mm-hand/mmhand-core-software/desktop/resources/images/joint_motor_ids.png

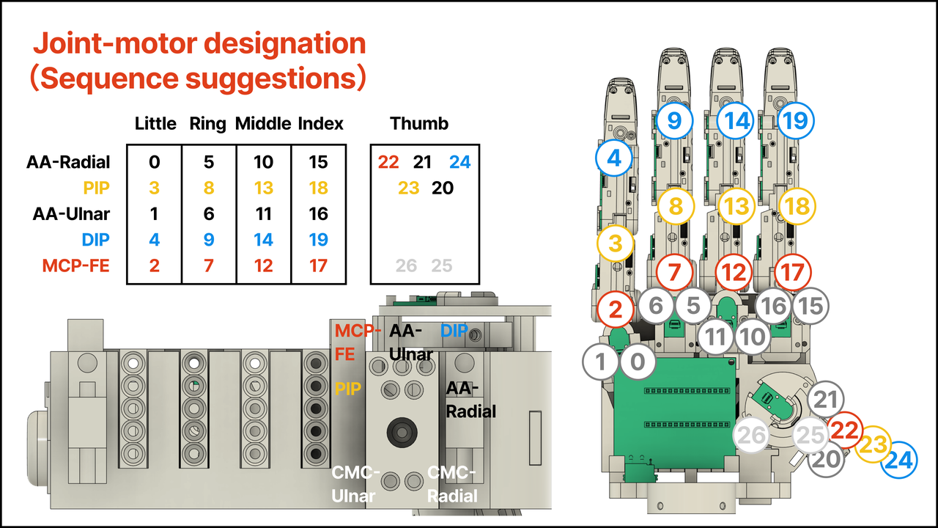
desktop/resources/images/joint_motor_ids.png
