mm-hand/mmhand-core-software/docs/desktop-safety-catalog.md

# Desktop safety catalog

Generated by `tools/generate_desktop_safety_catalog.py`; do not edit.

188 rejection messages, 124 fall back to `HOST_ACTION_FAILED` (the app cannot name the cause).

Static scan only: gates that fail silently, or forward `return False, message`,
are not listed. f-string messages are templates.

## desktop/core/application_actions.py

| Line | Message | Issue |
| --- | --- | --- |
| 158 | Wait for calibration to finish before changing control parameters | HOST_ACTION_FAILED ⚠ fallback |
| 165 | Parameters saved; P4 synchronization pending until idle | HOST_ACTION_FAILED ⚠ fallback |
| 177 | Parameters saved; P4 synchronization pending until idle | HOST_ACTION_FAILED ⚠ fallback |
| 182 | Wait for calibration to finish before changing control parameters | HOST_ACTION_FAILED ⚠ fallback |
| 189 | Default parameters restored; P4 synchronization pending until idle | HOST_ACTION_FAILED ⚠ fallback |
| 205 | Parameter synchronization cancelled by STOP | HOST_CANCELLED |
| 209 | Parameters changed during synchronization; apply the new revision first | HOST_ACTION_FAILED ⚠ fallback |
| 321 | Missing operation id | HOST_ACTION_FAILED ⚠ fallback |
| 327 | Calibration alert acknowledged | HOST_ACTION_FAILED ⚠ fallback |
| 328 | Operation has no calibration alert | HOST_ACTION_FAILED ⚠ fallback |
| 329 | Unknown operation | HOST_ACTION_FAILED ⚠ fallback |
| 369 | Replay service is not running | HOST_ACTION_FAILED ⚠ fallback |
| 446 | Application is shutting down | HOST_ACTION_FAILED ⚠ fallback |
| 448 | An operation is still finishing. Use STOP to cancel. | HOST_OPERATION_BUSY |
| 450 | P4 is disconnected or status data is stale. Check the connection. | HOST_CONNECTION_LOST |
| 488 | The operation worker is closed | HOST_ACTION_FAILED ⚠ fallback |
| 490 | {…} accepted | HOST_ACTION_FAILED ⚠ fallback |
| 514 | Select a device. The port is never changed automatically. | HOST_ACTION_FAILED ⚠ fallback |
| 521 | Connection cancelled | HOST_CANCELLED |
| 557 | Connection failed on {…}: {…} | HOST_ACTION_FAILED ⚠ fallback |
| 571 | Application is shutting down | HOST_ACTION_FAILED ⚠ fallback |
| 589 | Joint selection is out of range | HOST_ACTION_FAILED ⚠ fallback |
| 608 | Device is stopped (E-STOP latched); use the top-right Clear Faults button first | ACT-1005 |
| 615 | {…} cancelled | HOST_CANCELLED |
| 622 | Control handover was not queued | HOST_ACTION_FAILED ⚠ fallback |
| 626 | P4 did not acknowledge control handover | HOST_ACTION_FAILED ⚠ fallback |
| 635 | P4 did not release the old control owner | HOST_ACTION_FAILED ⚠ fallback |
| 675 | A maintenance or recovery operation owns the device | HOST_ACTION_FAILED ⚠ fallback |
| 686 | Select joints before enabling | HOST_SELECTION_EMPTY |
| 703 | Enable coordinate recovery failed: {…} | HOST_ACTION_FAILED ⚠ fallback |
| 705 | Scope setup failed. Check online devices, feedback and calibration. | HOST_ACTION_FAILED ⚠ fallback |
| 708 | Enable cancelled | HOST_CANCELLED |
| 729 | Enable preparation was not confirmed by P4 | HOST_ACTION_FAILED ⚠ fallback |
| 732 | Enable preparation changed before it could be used | HOST_ACTION_FAILED ⚠ fallback |
| 739 | P4 did not report READY after workspace recovery | HOST_ACTION_FAILED ⚠ fallback |
| 742 | Enable cancelled | HOST_CANCELLED |
| 745 | Enable blocked: P4 readiness or mapped feedback changed | HOST_ACTION_FAILED ⚠ fallback |
| 750 | Enable blocked: J{…} current angle is invalid | HOST_ACTION_FAILED ⚠ fallback |
| 769 | Enable cancelled | HOST_CANCELLED |
| 773 | Workspace recovery was not queued | HOST_ACTION_FAILED ⚠ fallback |
| 776 | Enable cancelled | HOST_CANCELLED |
| 778 | P4 workspace recovery ACK timed out | HOST_ACTION_FAILED ⚠ fallback |
| 780 | P4 rejected workspace recovery (ACK={…}) | HOST_ACTION_FAILED ⚠ fallback |
| 790 | Enable cancelled | HOST_CANCELLED |
| 791 | P4 workspace recovery result timed out | HOST_RESULT_UNKNOWN |
| 794 | Enable cancelled or workspace recovery result changed | HOST_CANCELLED |
| 797 | P4 workspace recovery failed (reason={…}) | HOST_ACTION_FAILED ⚠ fallback |
| 827 | Fault clear cancelled | HOST_CANCELLED |
| 832 | P4 did not acknowledge RESET. STOP remains pending; check the connection and Diagnostics. | HOST_ACTION_FAILED ⚠ fallback |
| 851 | RESET acknowledged, but a fresh stationary P4 status was not confirmed. Check Diagnostics. | HOST_ACTION_FAILED ⚠ fallback |
| 854 | Fault clear cancelled by a new STOP | HOST_CANCELLED |
| 865 | Targets must contain 21 finite angle values | HOST_ACTION_FAILED ⚠ fallback |
| 868 | Select a valid joint scope | HOST_ACTION_FAILED ⚠ fallback |
| 872 | Target cancelled | HOST_CANCELLED |
| 879 | Select valid joints | HOST_ACTION_FAILED ⚠ fallback |
| 889 | An operation is running. Wait for it to finish before authorizing ROS Input. | HOST_ACTION_FAILED ⚠ fallback |
| 896 | Invalid Manual capture arguments | HOST_ACTION_FAILED ⚠ fallback |
| 925 | P4 connection changed; capture the endpoint again. | HOST_ACTION_FAILED ⚠ fallback |
| 942 | J{…} raw feedback is invalid or stale. Check the encoder before capturing. | HOST_ACTION_FAILED ⚠ fallback |
| 946 | Press STOP and wait until P4 is stationary before capturing Manual endpoints. | HOST_MANUAL_INVALID |
| 949 | Capture cancelled | HOST_CANCELLED |
| 979 | J{…} not saved: {…} | HOST_ACTION_FAILED ⚠ fallback |
| 981 | Manual save cancelled | HOST_CANCELLED |
| 997 | Select joints | HOST_SELECTION_EMPTY |
| 1002 | Manual readback failed | HOST_ACTION_FAILED ⚠ fallback |
| 1008 | Clear cancelled | HOST_CANCELLED |
| 1024 | The current operation is still finishing | HOST_OPERATION_BUSY |
| 1029 | Select joints and connect P4 with fresh status | HOST_SELECTION_EMPTY |
| 1031 | Control parameters are not applied. Wait for parameter synchronization before calibrating. | HOST_PARAMETERS_PENDING |
| 1034 | J{…} is missing Manual Min / Max | HOST_MANUAL_MISSING |
| 1038 | J{…}: {…} | HOST_ACTION_FAILED ⚠ fallback |
| 1076 | Selected-joint calibration accepted | HOST_ACTION_FAILED ⚠ fallback |
| 1178 | Motor selection is out of range | HOST_ACTION_FAILED ⚠ fallback |
| 1183 | Motor scope updated | HOST_ACTION_FAILED ⚠ fallback |
| 1196 | Select motors before enabling | HOST_SELECTION_EMPTY |
| 1205 | Motor scope setup failed | HOST_MOTORS_NOT_READY |
| 1208 | Select motors; enable was not submitted | HOST_SELECTION_EMPTY |
| 1250 | Motors are online but their configuration check has not finished. Check the motor bus and retry. | HOST_MOTORS_NOT_READY |
| 1254 | ABS zero requires the original connected P4 device | HOST_MOTORS_NOT_READY |
| 1272 | ABS zero cancelled before stopping | HOST_CANCELLED |
| 1283 | P4 stop/owner release was not confirmed; ABS zero was not sent | HOST_ACTION_FAILED ⚠ fallback |
| 1285 | P4 device identity changed; ABS zero was not sent | HOST_ACTION_FAILED ⚠ fallback |
| 1328 | ABS zero may have completed; new trusted feedback/JSON save is unconfirmed. No automatic retry. | HOST_RESULT_UNKNOWN |
| 1330 | ABS zero partly completed (saved mask=0x{…}); {…} | HOST_RESULT_PARTIAL |
| 1347 | Waiting for motor firmware and configuration checks | HOST_MOTORS_NOT_READY |
| 1350 | No online, routable motors to initialize. Check the motor buses. | HOST_MOTORS_NOT_READY |
| 1359 | Select motors | HOST_SELECTION_EMPTY |
| 1369 | Select joints before releasing their tendons | HOST_SELECTION_EMPTY |
| 1396 | Calibration file exceeds 10 MB | HOST_ACTION_FAILED ⚠ fallback |
| 1408 | Calibration preview cancelled | HOST_CANCELLED |
| 1419 | Import requires a validated file and fresh, idle P4 connection | HOST_ACTION_FAILED ⚠ fallback |
| 1421 | Control parameters are not applied. Wait for parameter synchronization before loading calibration. | HOST_PARAMETERS_PENDING |
| 1454 | Calibration import started | HOST_ACTION_FAILED ⚠ fallback |
| 1461 | Motor scope setup failed | HOST_MOTORS_NOT_READY |
| 1464 | Direct control cancelled | HOST_CANCELLED |
| 1470 | Direct control cancelled | HOST_CANCELLED |
| 1475 | Current ABS is stale or untrusted | HOST_ACTION_FAILED ⚠ fallback |
| 1487 | Motor target send failed | HOST_ACTION_FAILED ⚠ fallback |
| 1495 | P4 rejected motor target (reason={…}, mask=0x{…}) | HOST_ACTION_FAILED ⚠ fallback |
| 1497 | Motor execution confirmation timed out | HOST_ACTION_FAILED ⚠ fallback |
| 1505 | Select joints explicitly before playing a motion | HOST_SELECTION_EMPTY |
| 1509 | Playback cancelled | HOST_CANCELLED |
| 1511 | Replay is not running | HOST_ACTION_FAILED ⚠ fallback |
| 1518 | Playback startup cancelled | HOST_CANCELLED |
| 1532 | Turn Save Data OFF before changing recording options | HOST_ACTION_FAILED ⚠ fallback |
| 1534 | Recording options updated | HOST_ACTION_FAILED ⚠ fallback |

## desktop/core/core_logic.py

| Line | Message | Issue |
| --- | --- | --- |
| 153 | Cannot reset motor positions while Stop is active. Check the hand, click Clear Faults, then retry the original action. | HOST_ACTION_FAILED ⚠ fallback |
| 338 | Not connected or empty motor scope | HOST_ACTION_FAILED ⚠ fallback |
| 349 | Direct enable cancelled | HOST_CANCELLED |
| 352 | Current ABS is stale or untrusted | HOST_ACTION_FAILED ⚠ fallback |
| 359 | Current-position hold was not queued | HOST_ACTION_FAILED ⚠ fallback |
| 365 | P4 rejected current-position hold (reason={…}) | HOST_ACTION_FAILED ⚠ fallback |
| 371 | Direct enable execution was not confirmed | HOST_ACTION_FAILED ⚠ fallback |
| 979 | serial not connected | HOST_CONNECTION_LOST |
| 985 | no multi-turn anchors to reconcile | HOST_ACTION_FAILED ⚠ fallback |
| 1011 | multi-turn frame shift refused: {…} | HOST_ACTION_FAILED ⚠ fallback |
| 1020 | multi-turn reconciliation reload failed: {…} | HOST_ACTION_FAILED ⚠ fallback |
| 1025 | device connection changed during coordinate reconciliation | HOST_ACTION_FAILED ⚠ fallback |
| 1027 | P4 did not accept the multi-turn trust request | HOST_ACTION_FAILED ⚠ fallback |
| 1058 | multi-turn recovery cancelled | HOST_CANCELLED |
| 1127 | no persistent multi-turn anchor: {…} | HOST_ACTION_FAILED ⚠ fallback |
| 2205 | waiting for post-reset native ABS | HOST_ACTION_FAILED ⚠ fallback |
| 2223 | post-reset native ABS unavailable (fresh={…} routable={…} unknown=0x{…} online=0x{…}) | HOST_ACTION_FAILED ⚠ fallback |
| 2370 | serial not connected | HOST_CONNECTION_LOST |
| 2382 | snapshot Manual endpoints are invalid | HOST_MANUAL_INVALID |
| 2388 | snapshot contains no valid Manual endpoints | HOST_MANUAL_INVALID |
| 2393 | failed to read current Manual RAM before restore | HOST_ACTION_FAILED ⚠ fallback |
| 2430 | J{…} Manual RAM restore rejected | HOST_ACTION_FAILED ⚠ fallback |
| 2432 | J{…} Manual commit timed out | HOST_ACTION_FAILED ⚠ fallback |
| 2438 | failed to read Manual RAM after restore | HOST_ACTION_FAILED ⚠ fallback |
| 2451 | P4 Manual RAM readback mask is incomplete | HOST_ACTION_FAILED ⚠ fallback |
| 2461 | J{…} Manual RAM readback mismatch | HOST_ACTION_FAILED ⚠ fallback |
| 2480 | serial not connected | HOST_CONNECTION_LOST |
| 2484 | current URDF mapping is invalid: {…} | HOST_ACTION_FAILED ⚠ fallback |
| 2497 | invalid motor ABS limits: {…} | HOST_ACTION_FAILED ⚠ fallback |
| 2499 | unsupported snapshot schema v{…} | HOST_ACTION_FAILED ⚠ fallback |
| 2501 | invalid motor ABS limit count: {…}/{…} | HOST_ACTION_FAILED ⚠ fallback |
| 2505 | invalid joint calibration count: {…} | HOST_ACTION_FAILED ⚠ fallback |
| 2532 | P4 Manual RAM image was not committed | HOST_ACTION_FAILED ⚠ fallback |
| 2540 | P4 Manual references missing active joints: {…} | HOST_ACTION_FAILED ⚠ fallback |
| 2545 | P4 Manual endpoint readback is incomplete | HOST_ACTION_FAILED ⚠ fallback |
| 2560 | snapshot Manual CRC mismatch: {…}; re-run automatic calibration for these joints | HOST_ACTION_FAILED ⚠ fallback |
| 2579 | motor ABS limit load ACK timeout/reject | HOST_ACTION_FAILED ⚠ fallback |
| 2592 | J{…} load ACK timeout/reject | HOST_ACTION_FAILED ⚠ fallback |
| 2595 | no valid joint calibration result in snapshot | HOST_ACTION_FAILED ⚠ fallback |

## desktop/core/hand_backend.py

| Line | Message | Issue |
| --- | --- | --- |
| 619 | ROS2 enable blocked: host calibration is active | HOST_ACTION_FAILED ⚠ fallback |
| 621 | ROS2 enable blocked: device transaction is active | HOST_ACTION_FAILED ⚠ fallback |
| 624 | ROS2 enable blocked: P4 serial is not connected | HOST_ACTION_FAILED ⚠ fallback |
| 628 | ROS2 enable blocked: protocol/model handshake unconfirmed | HOST_RESULT_UNKNOWN |
| 631 | ROS2 enable blocked: active joint scope is empty | HOST_SELECTION_EMPTY |
| 668 | ROS2 enable blocked: host calibration is active | HOST_ACTION_FAILED ⚠ fallback |
| 670 | ordinary controller is not enabled; press ENABLE first | HOST_ACTION_FAILED ⚠ fallback |

## desktop/core/host_calibration/finish.py

| Line | Message | Issue |
| --- | --- | --- |
| 88 | J{…} zero finish requires a valid dual LUT containing 0 degrees | HOST_ACTION_FAILED ⚠ fallback |
| 92 | J{…} zero finish cancelled or control lost | HOST_CANCELLED |
| 96 | J{…} zero finish target publish failed | HOST_ACTION_FAILED ⚠ fallback |
| 102 | zero finish cancelled or control lost before release | HOST_CANCELLED |
| 104 | zero finish direct owner release failed | HOST_ACTION_FAILED ⚠ fallback |

## desktop/core/host_calibration/runtime.py

| Line | Message | Issue |
| --- | --- | --- |
| 147 | session cancelled, replaced or disconnected | HOST_CANCELLED |
| 152 | system status stale or missing (age={…}s) | HOST_ACTION_FAILED ⚠ fallback |
| 161 | faults=0x{…}, route conflicts=0x{…} | HOST_ACTION_FAILED ⚠ fallback |
| 169 | state={…}, owner={…}, token={…}/{…}, result={…} | HOST_ACTION_FAILED ⚠ fallback |
| 174 | not stopped: state={…}, owner={…} | HOST_ACTION_FAILED ⚠ fallback |
| 1150 | device or model identity changed before calibration commit | HOST_ACTION_FAILED ⚠ fallback |
| 1152 | invalid host joint calibration result | HOST_ACTION_FAILED ⚠ fallback |
| 1155 | mechanical result retained in host diagnostics; LUT build invalid, not uploaded | HOST_ACTION_FAILED ⚠ fallback |
| 1160 | could not release motion before Manual/LUT commit | HOST_ACTION_FAILED ⚠ fallback |
| 1164 | Manual writeback failed | HOST_ACTION_FAILED ⚠ fallback |
| 1167 | joint LUT writeback failed | HOST_ACTION_FAILED ⚠ fallback |
| 1174 | calibration motor limits incomplete | HOST_ACTION_FAILED ⚠ fallback |
| 1180 | joint ABS limits writeback failed | HOST_ACTION_FAILED ⚠ fallback |
| 1183 | calibration cancelled after device writeback | HOST_CANCELLED |
| 1217 | new joint result saved; waiting for trusted native ABS anchors | HOST_ACTION_FAILED ⚠ fallback |
| 1226 | new joint result saved; runtime anchor persistence failed | HOST_ACTION_FAILED ⚠ fallback |
| 1263 | calibration stopped; completed joints retained | HOST_ACTION_FAILED ⚠ fallback |
| 1265 | calibration complete; motion owner release failed | HOST_ACTION_FAILED ⚠ fallback |
| 1268 | calibration complete; active scope restore failed | HOST_ACTION_FAILED ⚠ fallback |
| 1270 | calibration complete; P4 preparation failed | HOST_ACTION_FAILED ⚠ fallback |
| 1273 | calibration complete; Pull Joint into Workspace start failed | HOST_ACTION_FAILED ⚠ fallback |
| 1276 | calibration complete; Pull Joint into Workspace result timeout | HOST_RESULT_UNKNOWN |
| 1279 | Pull Joint into Workspace failed | HOST_ACTION_FAILED ⚠ fallback |

## desktop/core/id_actions.py

| Line | Message | Issue |
| --- | --- | --- |
| 72 | Choose Scan (0–30) or Scan (0–253) | HOST_ACTION_FAILED ⚠ fallback |
| 110 | Scan cancelled | HOST_CANCELLED |
| 121 | Connect P4 and scan all buses before renumbering | HOST_MOTORS_NOT_READY |
| 128 | No motors were found | HOST_ACTION_FAILED ⚠ fallback |
| 137 | The scan is no longer current. {…} | HOST_ACTION_FAILED ⚠ fallback |
| 139 | P4 identity is unavailable; wait for device fingerprint | HOST_ACTION_FAILED ⚠ fallback |
| 221 | Connect P4 and scan all buses before buzzing a motor | HOST_MOTORS_NOT_READY |
| 224 | Scan all buses and select a motor to buzz | HOST_MOTORS_NOT_READY |

## Duplicate messages

- ×2 `Wait for calibration to finish before changing control parameters`
- ×2 `Parameters saved; P4 synchronization pending until idle`
- ×2 `Application is shutting down`
- ×5 `Enable cancelled`
- ×2 `Motor scope setup failed`
- ×2 `Direct control cancelled`
- ×2 `Current ABS is stale or untrusted`
- ×3 `serial not connected`
- ×2 `ROS2 enable blocked: host calibration is active`
