mm-hand/mmhand-core-software/desktop/resources/mmhand_urdf/meshes/link_finger_tip_2.stl

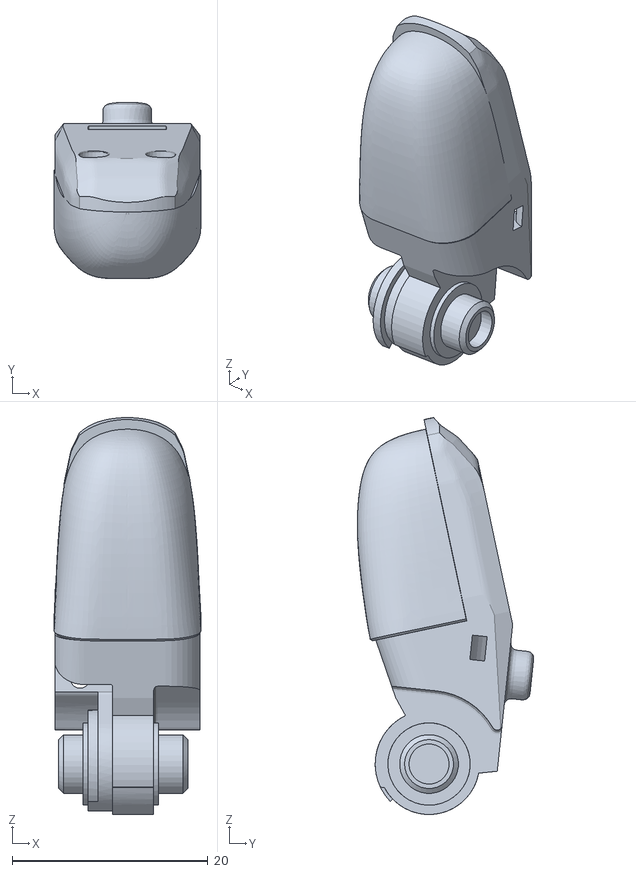
[picture p2: CAD file, 2026-10-31]
desktop/resources/mmhand_urdf/meshes/link_finger_tip_2.stl
15.0 x 18.0 x 40.5
