mm-hand/mmhand-core-software/desktop/resources/mmhand_urdf/meshes/link_proximal_phalanx_4.stl

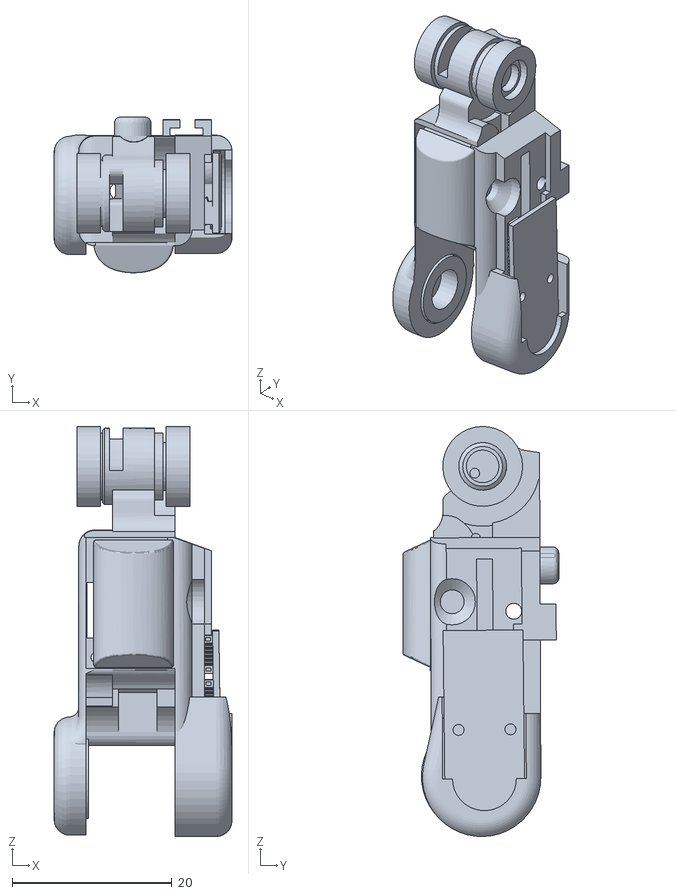
[picture p4: CAD file, 2026-10-31]
desktop/resources/mmhand_urdf/meshes/link_proximal_phalanx_4.stl
22.3 x 19.5 x 51.4
