mm-hand/mmhand-core-software/desktop/resources/mmhand_urdf/meshes/link_aa_with_fin_1.stl

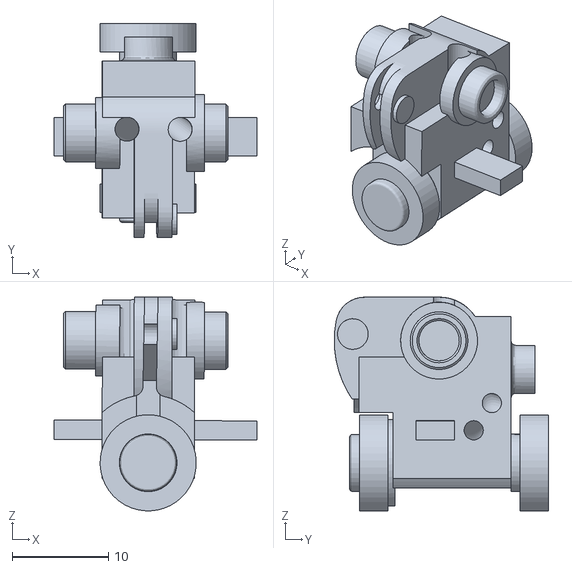
[picture p6: CAD file, 2026-10-31]
desktop/resources/mmhand_urdf/meshes/link_aa_with_fin_1.stl
21.1 x 22.3 x 22.2
