mm-hand/mmhand-core-software/desktop_macOS/hku_hand_v2_urdf/meshes/2-3_Link.STL.convex.stl

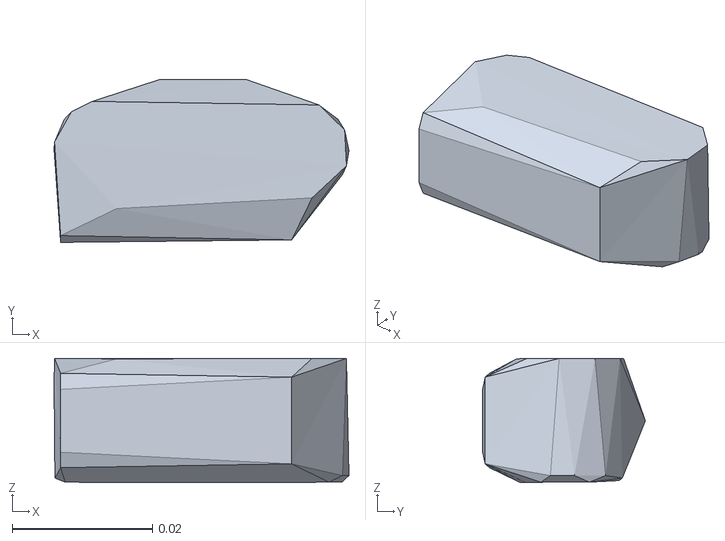
[picture p8: CAD file, 2026-04-04]
desktop_macOS/hku_hand_v2_urdf/meshes/2-3_Link.STL.convex.stl
0.042 x 0.0232 x 0.0177
