mm-hand/mmhand-core-software/desktop/resources/mmhand_urdf/meshes/link_left_thumb_base_1.stl

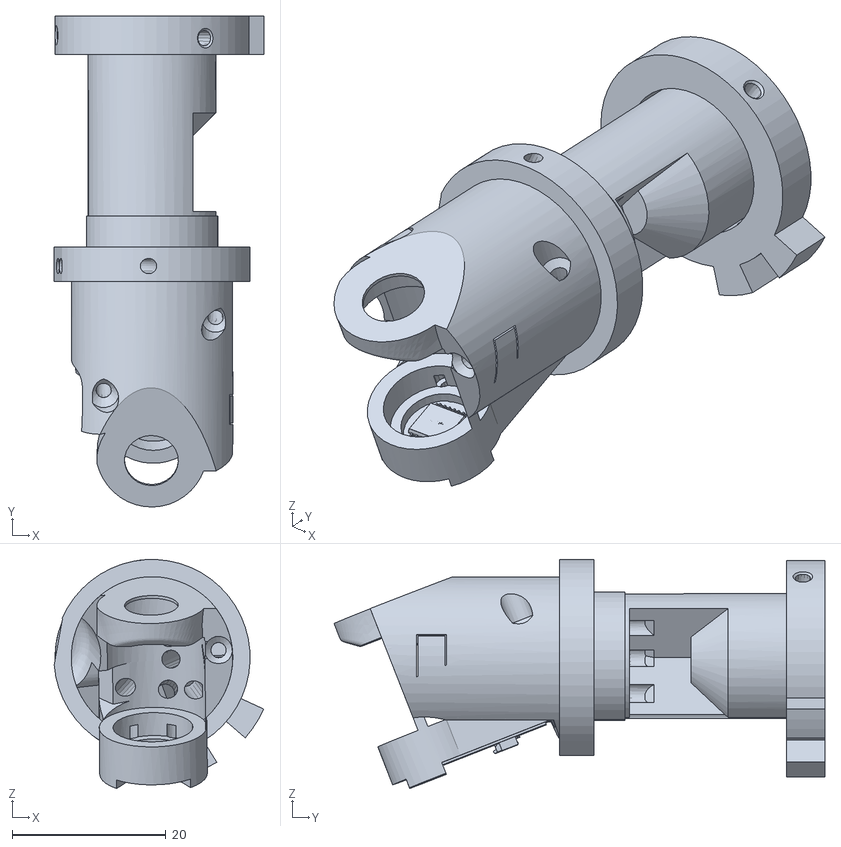
[picture p9: CAD file, 2026-10-31]
desktop/resources/mmhand_urdf/meshes/link_left_thumb_base_1.stl
27.2 x 63.8 x 29.8
