mm-hand/mmhand-core-software/desktop_macOS/hku_hand_v2_urdf/meshes/3-4_Link.STL

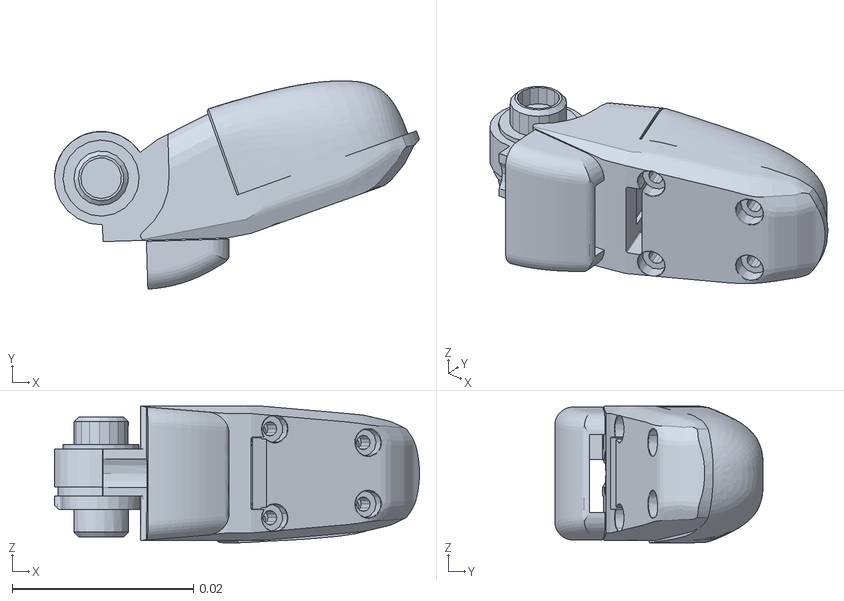
[picture p10: CAD file, 2026-04-04]
desktop_macOS/hku_hand_v2_urdf/meshes/3-4_Link.STL
0.0402 x 0.023 x 0.0151
