mm-hand/mmhand-core-software/desktop/resources/mmhand_urdf/meshes/link_aa_without_fin_1.stl

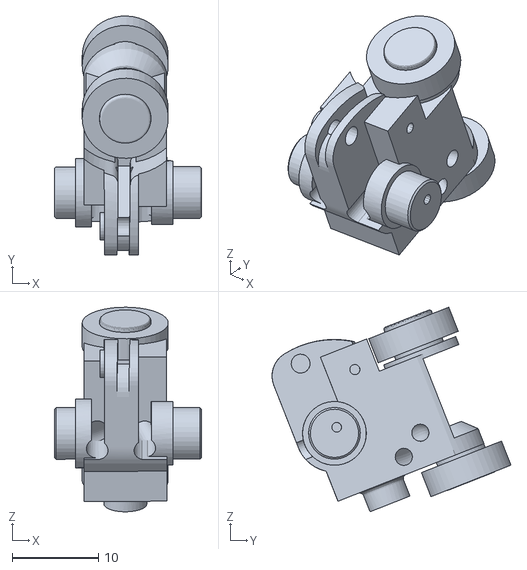
[picture p11: CAD file, 2026-10-31]
desktop/resources/mmhand_urdf/meshes/link_aa_without_fin_1.stl
17.1 x 27.7 x 23.7
