mm-hand/mmhand-core-software/desktop/resources/mmhand_urdf/meshes/link_distal_phalanx_3.stl

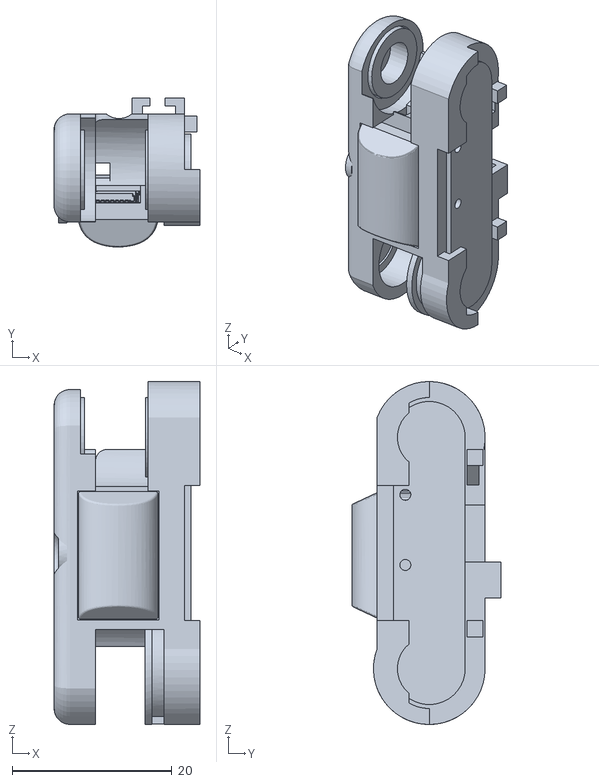
[picture p13: CAD file, 2026-10-31]
desktop/resources/mmhand_urdf/meshes/link_distal_phalanx_3.stl
18.3 x 18.7 x 43.0
