mm-hand/mmhand-core-software/desktop_macOS/hku_hand_v2_urdf/meshes/4-4_Link.STL

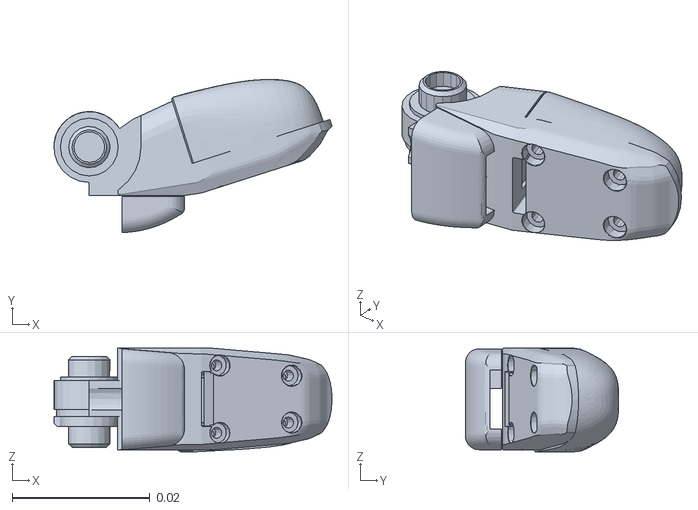
[picture p14: CAD file, 2026-04-04]
desktop_macOS/hku_hand_v2_urdf/meshes/4-4_Link.STL
0.0404 x 0.0222 x 0.0151
