mm-hand/mmhand-core-software/desktop_macOS/hku_hand_v2_urdf/meshes/base_link.STL

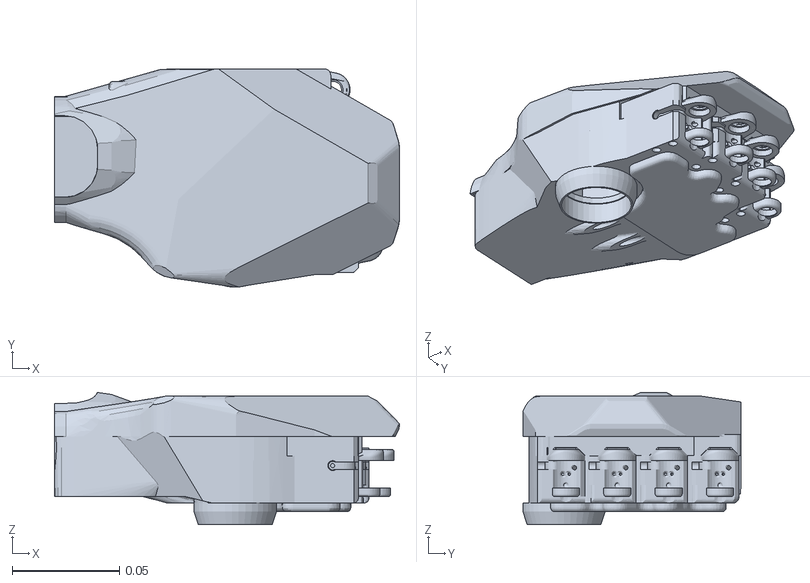
[picture p15: CAD file, 2026-04-04]
desktop_macOS/hku_hand_v2_urdf/meshes/base_link.STL
0.161 x 0.102 x 0.0617
