mm-hand/mmhand-core-software/desktop/resources/mmhand_urdf/meshes/link_left_palm_1.stl

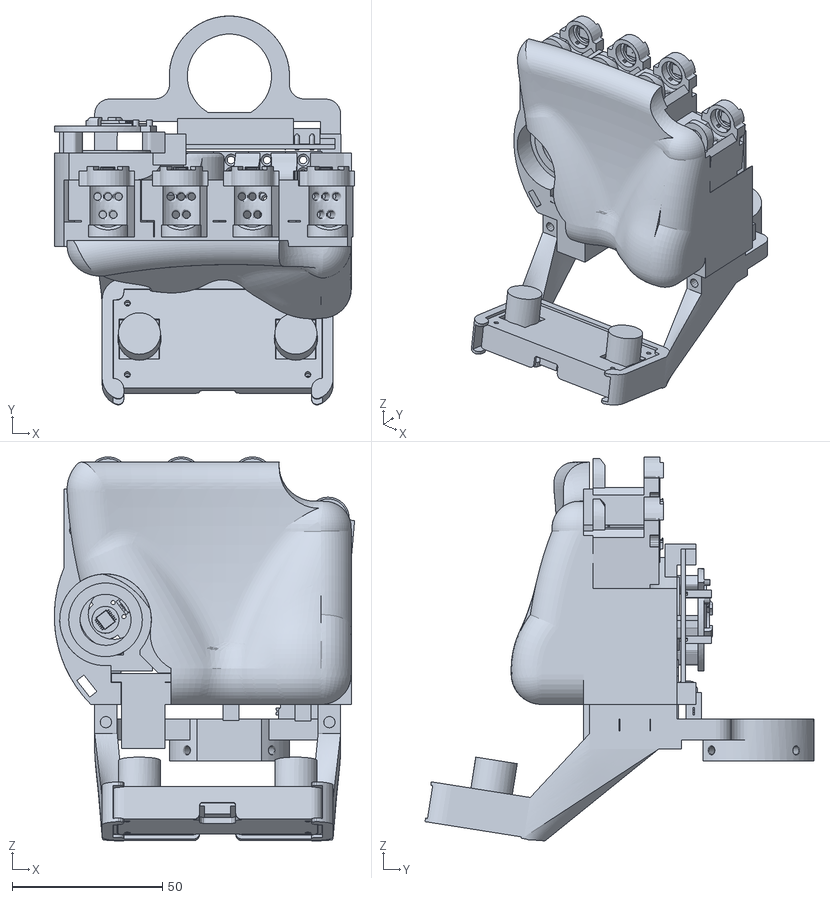
[picture p16: CAD file, 2026-10-31]
desktop/resources/mmhand_urdf/meshes/link_left_palm_1.stl
99.8 x 129.3 x 127.6
