mm-hand/mmhand-core-software/desktop/resources/mmhand_urdf/meshes/link_distal_phalanx_1.stl

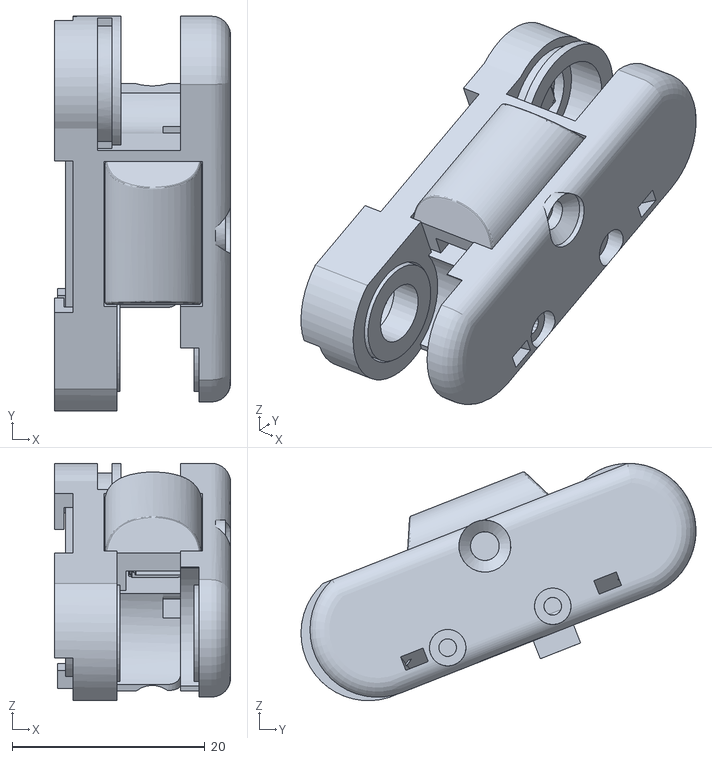
[picture p18: CAD file, 2026-10-31]
desktop/resources/mmhand_urdf/meshes/link_distal_phalanx_1.stl
18.3 x 41.0 x 24.6
