mm-hand/mmhand-core-software/desktop/resources/mmhand_urdf/meshes/link_proximal_phalanx_1.stl

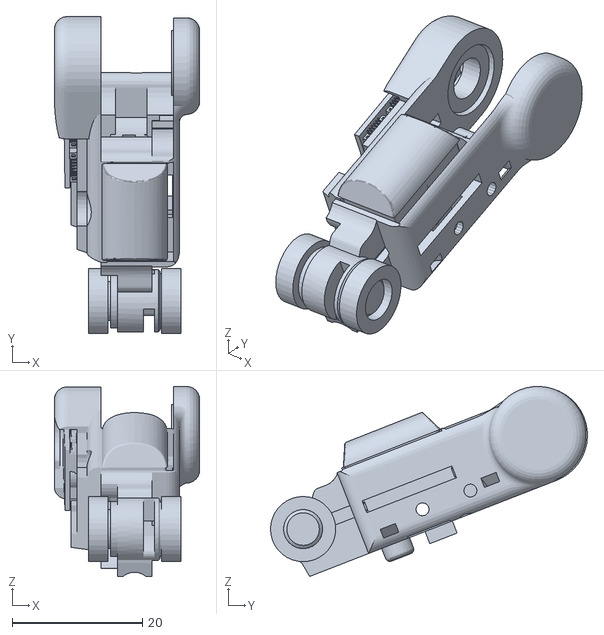
[picture p20: CAD file, 2026-10-31]
desktop/resources/mmhand_urdf/meshes/link_proximal_phalanx_1.stl
22.3 x 48.6 x 29.1
