mm-hand/mmhand-core-software/desktop_macOS/hku_hand_v2_urdf/meshes/4-2_Link.STL

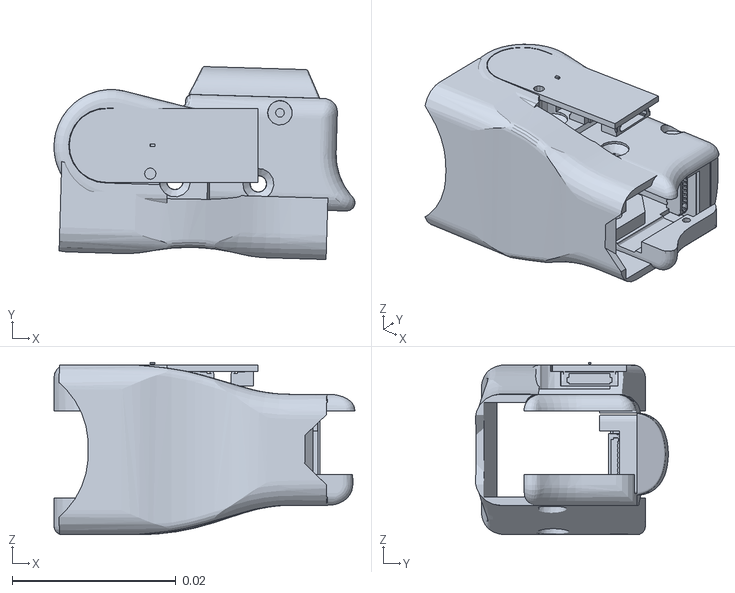
[picture p22: CAD file, 2026-04-04]
desktop_macOS/hku_hand_v2_urdf/meshes/4-2_Link.STL
0.0368 x 0.0236 x 0.0211
