mm-hand/mmhand-core-software/desktop/resources/mmhand_urdf/meshes/link_aa_without_fin_2.stl

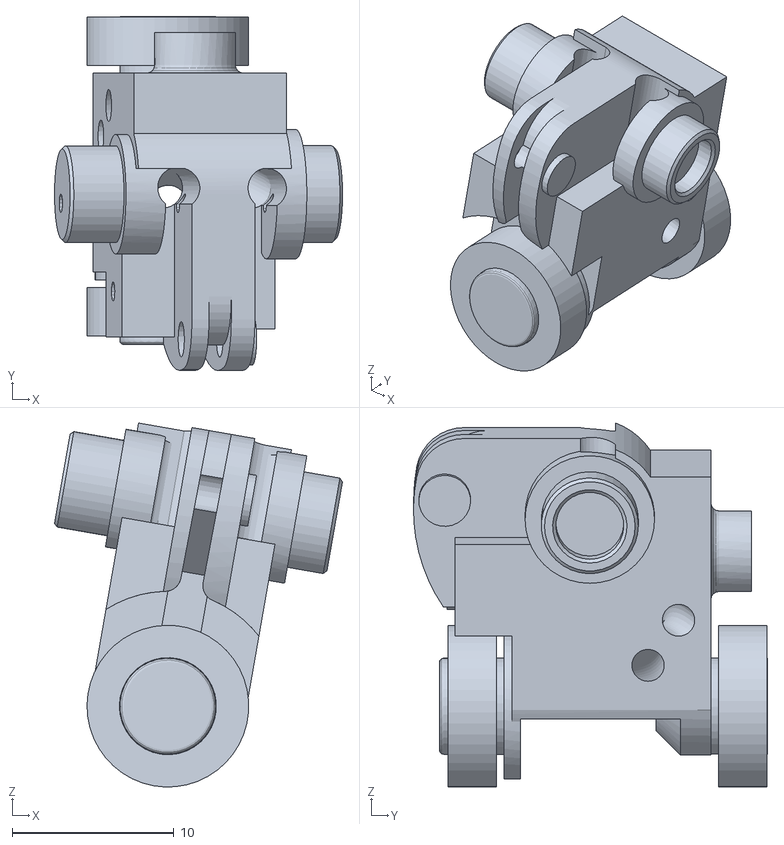
[picture p23: CAD file, 2026-10-31]
desktop/resources/mmhand_urdf/meshes/link_aa_without_fin_2.stl
17.8 x 21.9 x 22.5
