mm-hand/mmhand-core-software/desktop_macOS/hku_hand_v2_urdf/meshes/3-2_Link.STL.convex.stl

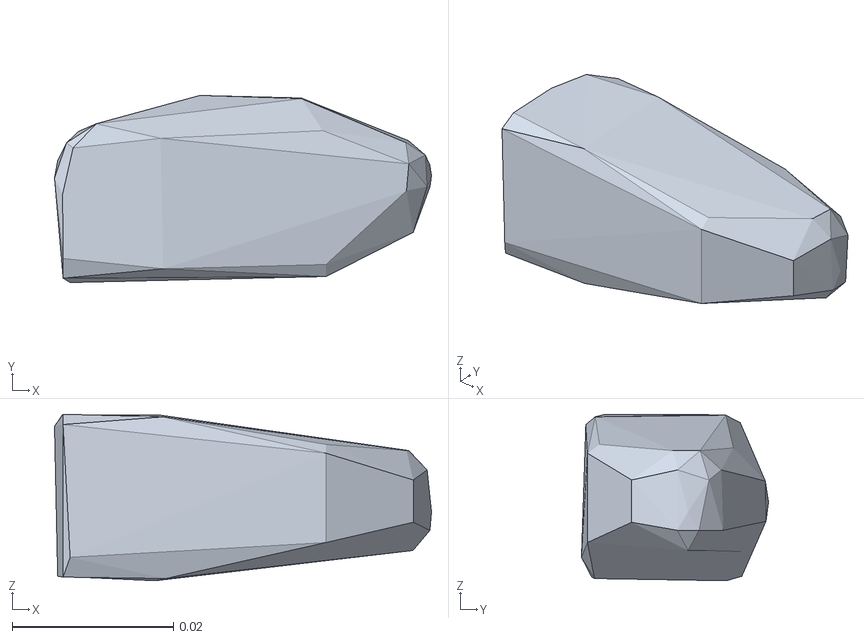
[picture p24: CAD file, 2026-04-04]
desktop_macOS/hku_hand_v2_urdf/meshes/3-2_Link.STL.convex.stl
0.0468 x 0.0232 x 0.0207
