mm-hand/mmhand-core-software/desktop_macOS/hku_hand_v2_urdf/meshes/5-2_Link.STL

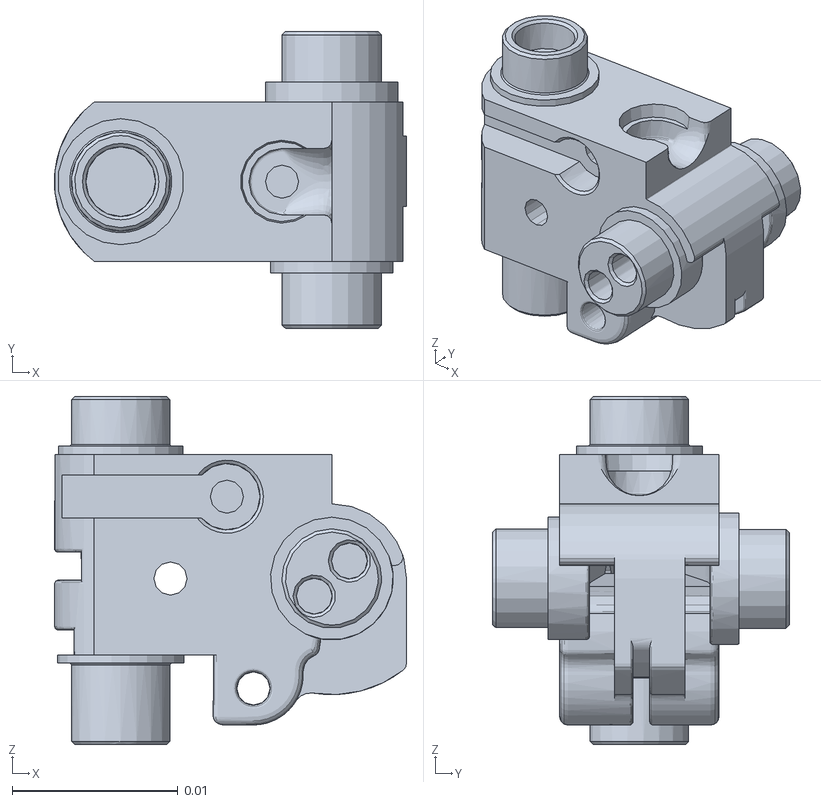
[picture p26: CAD file, 2026-04-04]
desktop_macOS/hku_hand_v2_urdf/meshes/5-2_Link.STL
0.0212 x 0.0179 x 0.021
