mm-hand/mmhand-core-software/desktop/resources/mmhand_urdf/meshes/link_proximal_phalanx_5.stl

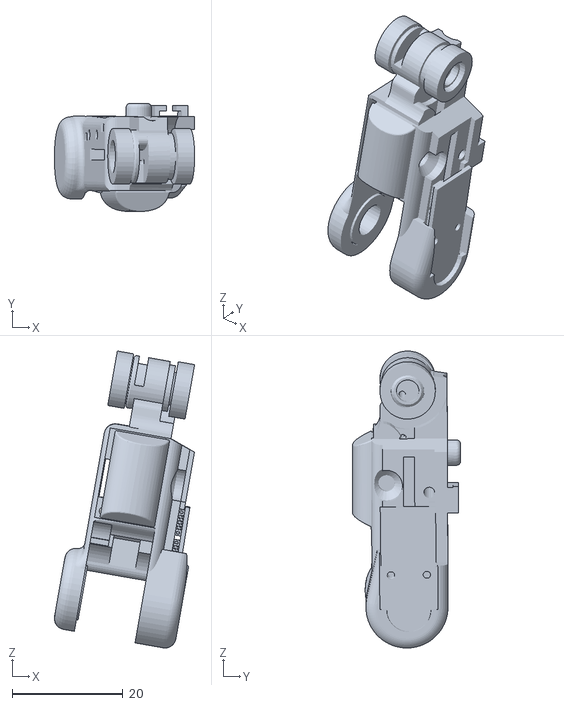
[picture p27: CAD file, 2026-10-31]
desktop/resources/mmhand_urdf/meshes/link_proximal_phalanx_5.stl
25.3 x 19.5 x 53.7
