mm-hand/mmhand-core-software/desktop_macOS/hku_hand_v2_urdf/meshes/2-4_Link.STL.convex.stl

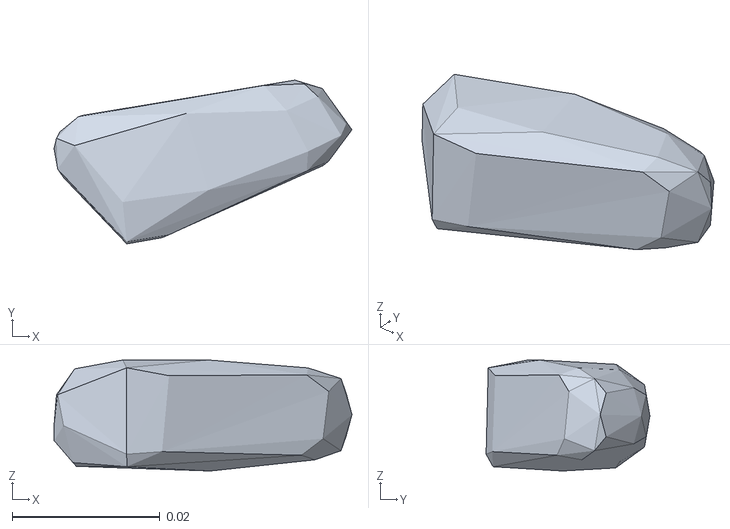
[picture p28: CAD file, 2026-04-04]
desktop_macOS/hku_hand_v2_urdf/meshes/2-4_Link.STL.convex.stl
0.0404 x 0.0222 x 0.015
