mm-hand/mmhand-core-software/desktop/resources/mmhand_urdf/meshes/link_distal_phalanx_5.stl

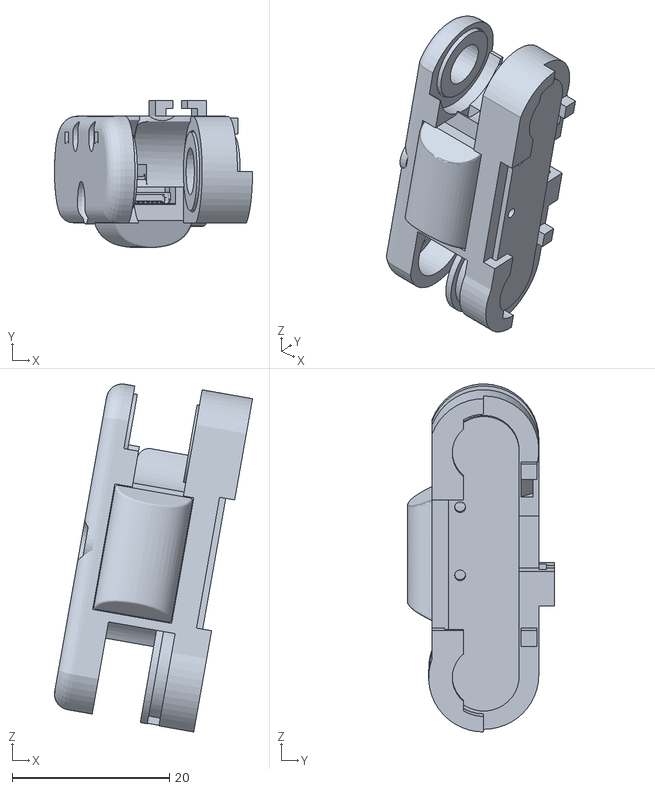
[picture p29: CAD file, 2026-10-31]
desktop/resources/mmhand_urdf/meshes/link_distal_phalanx_5.stl
25.2 x 18.7 x 44.2
