mm-hand/mmhand-core-software/desktop/resources/mmhand_urdf/meshes/link_finger_tip_5.stl

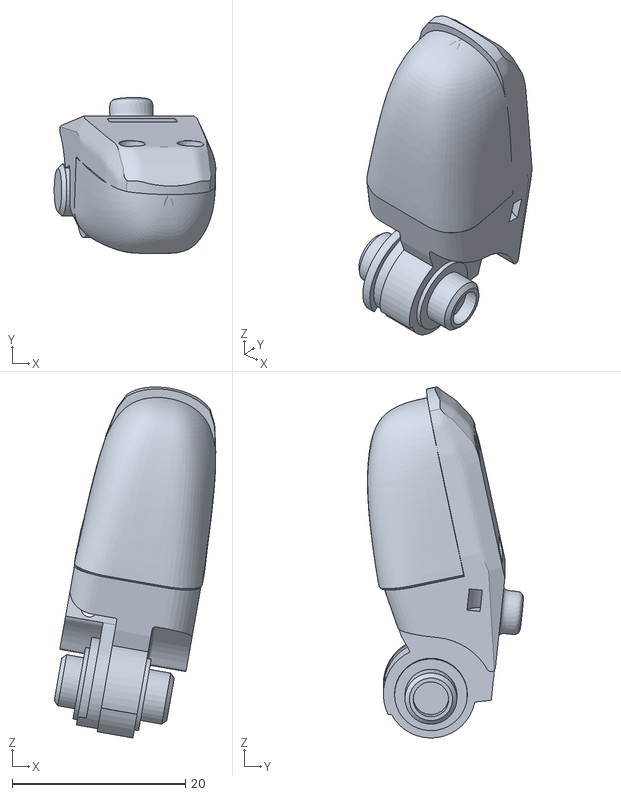
[picture p32: CAD file, 2026-10-31]
desktop/resources/mmhand_urdf/meshes/link_finger_tip_5.stl
18.7 x 18.0 x 40.5
