mm-hand/mmhand-core-software/desktop/resources/mmhand_urdf/meshes/link_finger_tip_1.stl

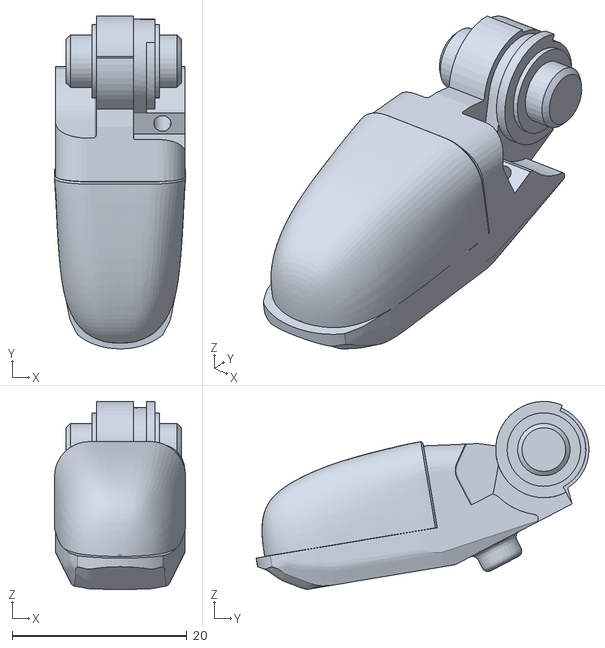
[picture p33: CAD file, 2026-10-31]
desktop/resources/mmhand_urdf/meshes/link_finger_tip_1.stl
15.0 x 38.0 x 21.5
