mm-hand/mmhand-core-software/desktop_macOS/hku_hand_v2_urdf/meshes/1-3_Link.STL

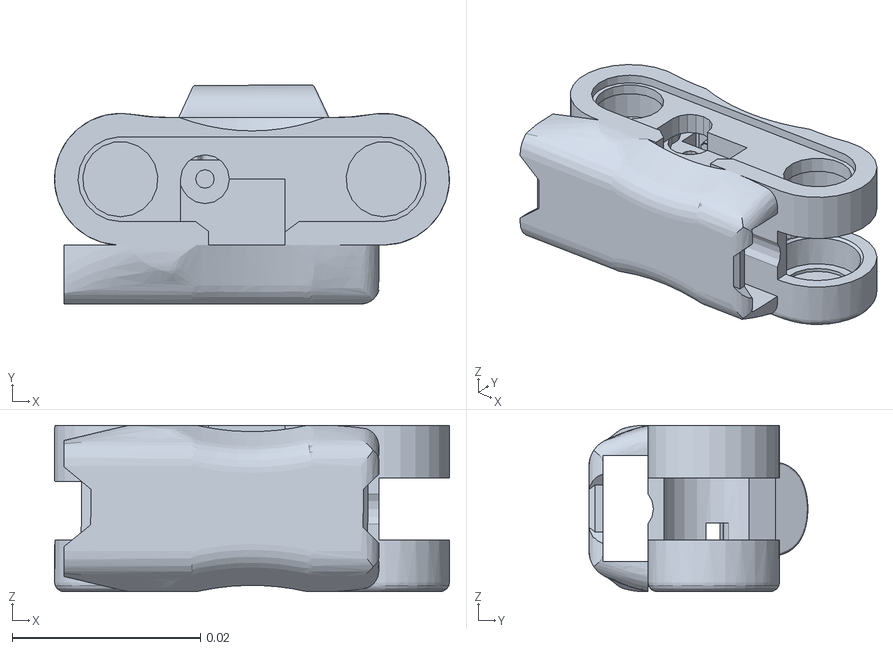
[picture p34: CAD file, 2026-04-04]
desktop_macOS/hku_hand_v2_urdf/meshes/1-3_Link.STL
0.042 x 0.0233 x 0.0177
