mm-hand/mmhand-core-software/desktop_macOS/hku_hand_v2_urdf/meshes/5-4_Link.STL

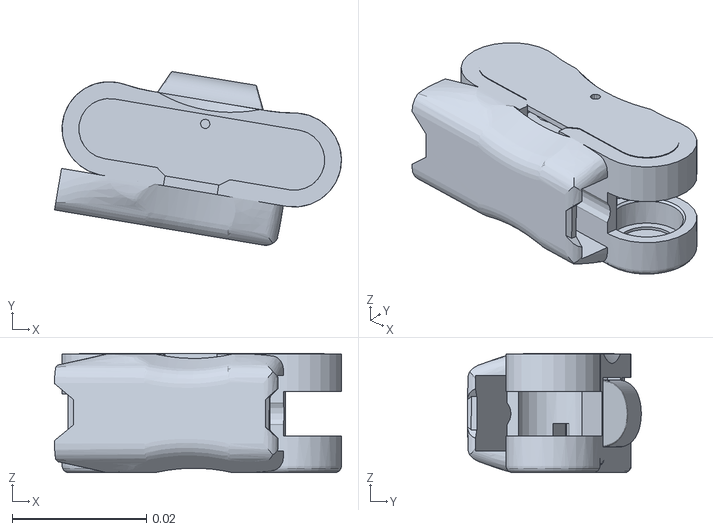
[picture p35: CAD file, 2026-04-04]
desktop_macOS/hku_hand_v2_urdf/meshes/5-4_Link.STL
0.0427 x 0.0259 x 0.0178
