mm-hand/mmhand-core-software/desktop_macOS/hku_hand_v2_urdf/meshes/base_link.STL.convex.stl

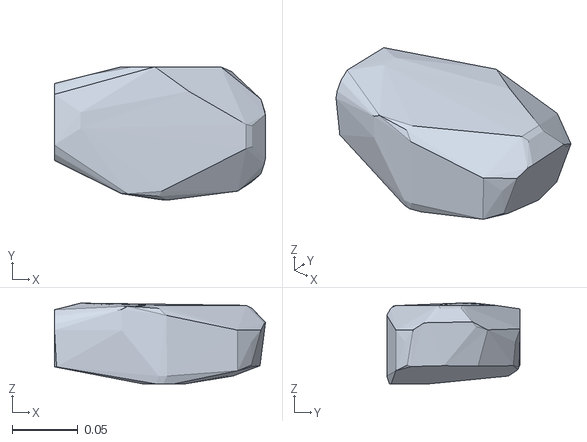
[picture p36: CAD file, 2026-04-04]
desktop_macOS/hku_hand_v2_urdf/meshes/base_link.STL.convex.stl
0.161 x 0.102 x 0.0617
