mm-hand/mmhand-core-software/desktop_macOS/hku_hand_v2_urdf/meshes/3-4_Link.STL.convex.stl

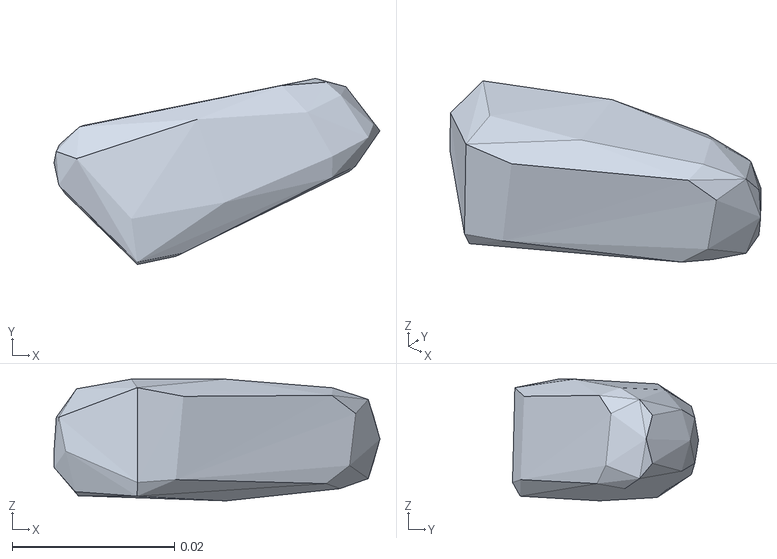
[picture p37: CAD file, 2026-04-04]
desktop_macOS/hku_hand_v2_urdf/meshes/3-4_Link.STL.convex.stl
0.0402 x 0.023 x 0.015
