mm-hand/mmhand-core-software/desktop_macOS/hku_hand_v2_urdf/meshes/2-2_Link.STL

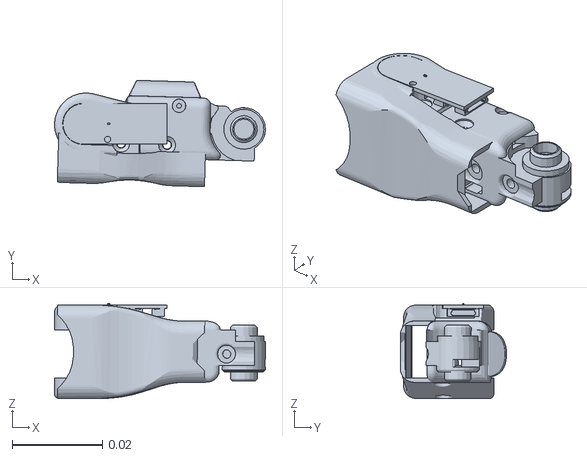
[picture p40: CAD file, 2026-04-04]
desktop_macOS/hku_hand_v2_urdf/meshes/2-2_Link.STL
0.0468 x 0.0236 x 0.0211
