mm-hand/mmhand-core-software/desktop_macOS/hku_hand_v2_urdf/meshes/5-3_Link.STL

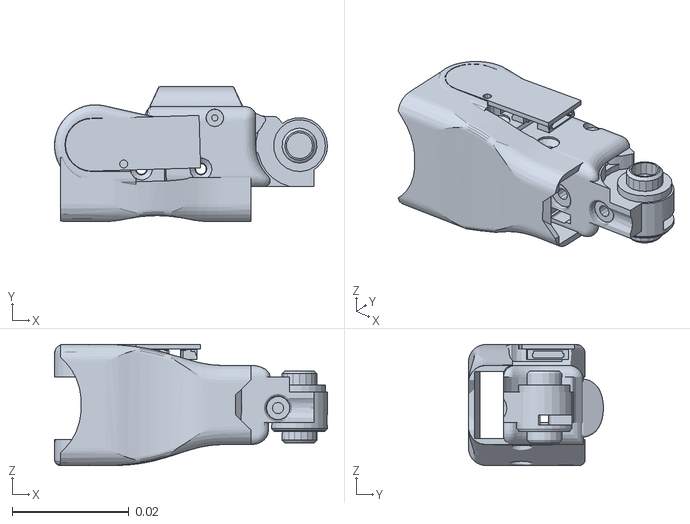
[picture p41: CAD file, 2026-04-04]
desktop_macOS/hku_hand_v2_urdf/meshes/5-3_Link.STL
0.0468 x 0.0231 x 0.0208
