mm-hand/mmhand-core-software/desktop_macOS/hku_hand_v2_urdf/meshes/5-4_Link.STL.convex.stl

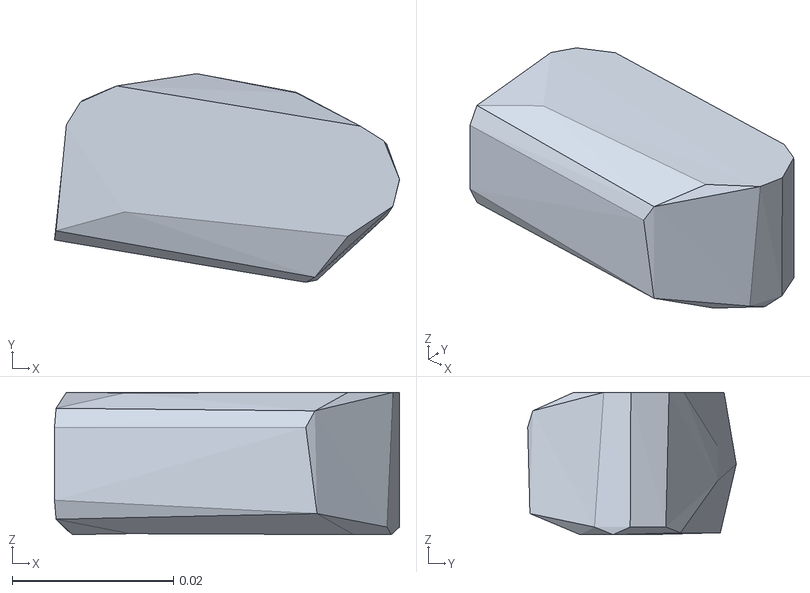
[picture p44: CAD file, 2026-04-04]
desktop_macOS/hku_hand_v2_urdf/meshes/5-4_Link.STL.convex.stl
0.0427 x 0.0258 x 0.0176
