mm-hand/mmhand-core-software/(list of files, cad)

Other CAD files:
desktop/resources/mmhand_urdf/meshes/link_aa_with_fin_3.stl
desktop/resources/mmhand_urdf/meshes/link_proximal_phalanx_3.stl
desktop/resources/mmhand_urdf/meshes/link_finger_tip_4.stl
desktop_macOS/hku_hand_v2_urdf/meshes/1-3_Link.STL.convex.stl
desktop/resources/mmhand_urdf/meshes/link_finger_tip_3.stl
desktop/resources/mmhand_urdf/meshes/link_distal_phalanx_4.stl
desktop/resources/mmhand_urdf/meshes/link_aa_with_fin_2.stl
desktop/resources/mmhand_urdf/meshes/link_proximal_phalanx_2.stl
desktop/resources/mmhand_urdf/meshes/link_distal_phalanx_2.stl
desktop_macOS/hku_hand_v2_urdf/meshes/1-1_Link.STL.convex.stl
desktop_macOS/hku_hand_v2_urdf/meshes/3-1_Link.STL.convex.stl
desktop_macOS/hku_hand_v2_urdf/meshes/2-3_Link.STL
desktop_macOS/hku_hand_v2_urdf/meshes/2-4_Link.STL
desktop_macOS/hku_hand_v2_urdf/meshes/1-4_Link.STL.convex.stl
desktop_macOS/hku_hand_v2_urdf/meshes/1-2_Link.STL
desktop_macOS/hku_hand_v2_urdf/meshes/2-1_Link.STL.convex.stl
desktop_macOS/hku_hand_v2_urdf/meshes/1-4_Link.STL
desktop_macOS/hku_hand_v2_urdf/meshes/1-1_Link.STL
desktop_macOS/hku_hand_v2_urdf/meshes/1-2_Link.STL.convex.stl
desktop_macOS/hku_hand_v2_urdf/meshes/4-1_Link.STL
desktop_macOS/hku_hand_v2_urdf/meshes/3-1_Link.STL
