mm-hand/mmhand-core-software/desktop_macOS/hku_hand_v2_urdf/calculate_instruct.md

# Calculation of manipulability ellipsoid

Many calculate the manipulability ellipsoid from the end-effector Jacobian which models the directions in which the end-effector can move. We compute the volume of this ellipsoid using the following equation:

$$
    w=\sqrt{det(J(q)J(q)^T)}
$$

where q is the joint configuration and J is the Jacobian of the end-effector. 

Now we need do this analysis for `hku_hand.xml`. Now, ellipsoid analysis calculations need to be performed for the HKU hand. Specifically, ellipsoid values need to be calculated for the index finger (1-1_Link) and thumb (5-1_Link) under three joint configurations, as follows:

1. Up-pose: The three distal joints of the finger or thumb are fully extended.

2. Down-pose: The three distal joints of the finger or thumb are fully flexed.

3. Curled-pose: The three distal joints of the finger or thumb are maintained at an intermediate state between their maximum and minimum values.

In all three configurations, the side-sway joint of the index finger and the two base joints of the thumb remain in a neutral position (keep 0).

Some tips:
1. You can search mujoco docs for Jacobian calculation
