mm-hand/mmhand-core-software/docs/debug/field-notes-20261025-thumb-aa.md

# 2026-10-25 拇指 AA 标定失败现场记录

## 症状

- 16:06 J18（拇指 PIP）标定在“AA 中点”阶段失败：
  `J18: J16: AA midpoint target publish failed`。
- 16:03 那次 J18 从 16:03:43 跑到 16:04:25：J16 角度 `-32.2° → +22.5°`，
  M20 实际 `6789 → 10812`，同期负载约 `-590`（未到 800）。
- 16:06 再试时 AA 在 `+22.4°`，M20 负载 `200 → 800`；程序在 800 处拒绝继续下发，
  随后释放直控/扭矩，界面报 `publish failed`。

## 已确认

- **2026-10-25 操作者手动确认**：卸力后拇指 AA 在 `-25°~+25°` 可自由走动，
  不卡、未被手掌/食指挡住，两根绳有余量。机械卡死假设排除。
- **主机/P4 角度一致**：16:03:43.602 原始编码器 `J16 raw = 5206`，按主机 Manual
  映射（min=3189, max=7907, span=4718）计算为 `-32.25°`；P4 trace 同刻为 `-32.2°`。
  之前怀疑的“主机映射 vs P4 反馈不一致”不成立。
- **AA hold 没守住**：16:03:43~16:04:24 的发布日志里（除最后一行 16:04:24.986
  为 J19 首笔），M20/M21 目标固定在 `6789 / 3632`，但 M20 实际走到 `10812`，
  J16 角度走到 `+22.5°`。
- `hold_targets_except` 只重发锁定的 AA 目标，没有漂移门限；这是 2026-10-25 J05
  现场后特意去掉的（见 `tests/desktop/core/test_host_calibration_aa_midpoint.py:185`），
  所以 hold 期间的实际漂移不会被判失败。

## 证据

- `logs/recordings_20261025_153859_216036/06_操作事件总表.csv`
  （J18 16:04:25 FAILED；J19 紧接着 `J16: AA midpoint target publish failed`）
- `logs/diag/calib_publish_20261025_160343.csv`
  （16:03 的 M20/M21 目标与实际；目标 6789/3632 固定，实际 M20 到 10812）
- `logs/recordings_20261025_153859_216036/02_关节总表.csv`
  （16:04:25 J16 `22.49°`、M20 `10812`；trace `command_age_ms=42298`）
- `logs/recordings_20261025_153859_216036/08_原始接收帧.csv`
  （16:03:43 raw J16=5206；15:58:31 整组舵机 offline/unknown；16:03:36 restore；
  16:06/16:07 0xEC turn-zero）
- 当时的校准专用日志记录了 16:06:39 / 16:07:26 的 `[ACK] cmd=0xEC`。
  该历史独立日志现已移除；新记录统一写入会话日志的 `[PROTO]`，
  参见 [舵机反馈诊断与日志位置](servo-feedback-diagnostics.md)。

## 掉电/恢复

- 15:58:31.542：`servo_online=0x0000000`、`multi_turn_unknown=0x07FFFFFF`，
  27 路舵机全部掉线、全部多圈未知。
- 16:03:36~16:03:38：unknown 逐位清零；上位机 `CMD_RESTORE_MULTITURN (0xDA)`
  的 0x17 结果包 token 2~14（15:58:36~16:03:38），P4 用 0x0B 写回锚点。
- 断电前后锚点一致：M20 `6789 / raw 2693`，M21 `3632 / raw 3632`。
  恢复写的是断电前值，不是 0；坐标没有被改。
- 16:06/16:07 的 0xEC 是操作者事后“重置 7 个电机圈数 + 放 1500 counts”，
  发生在 AA 失败之后，不是 16:03 失败的原因；它作废了 J16~J20。

## 待查

- 为什么 AA hold 目标 `6789` 时 M20 实际会走到 `10812`：
  P4 direct 目标是否每笔都真正应用（token / applied mask / command age）？
  舵机保持力矩/负载限制？绳长/符号/零点？
- `publish` 的 800 负载保护只在单次负载 ≥800 时触发；hold 漂移没有独立门限，
  所以这次是“先漂到 +22.5°，下一次再顶到 800”。

## 下一步

1. 从 J16（拇指 AA）开始重标，再 J17/J18/J19；J20（CMC）单独。
   不要跳过 AA 直接标 J17~J19（`runtime.py:499-566`）。
2. 标定/中点时盯 `command_age_ms`、M20/M21 目标 vs 实际、负载；
   目标固定但实际漂 >500 counts 就停，比等 800 更早。
3. 如果复发，先查 P4 direct 目标是否逐笔应用，再查舵机保持力矩/绳长。
4. 这次掉电按“坐标恢复事件”处理：恢复精确，但旧标定是否仍可信要重新确认；
   J16~J20 已被 turn-zero 作废，按计划重标。
