mm-hand/mmhand-core-software/ESP32-P4/src/hal/servo/FeetechServoDriver.cpp

/**
 * @file FeetechServoDriver.cpp
 * @brief 飞特驱动翻译单元；SDK 实现随本目录 FTServo_Arduino 一起编译。
 */
#include "FeetechServoDriver.h"

/* FeetechServoDriver::FeetechServoDriver */
FeetechServoDriver::FeetechServoDriver()
    : _serial(NULL),
      _busIndex(0xFF),
      _rxPin(-1),
      _txPin(-1),
      _baud(0),
      _writeCount(0),
      _currentReadDivider(0),
      _syncReadActive(false),
      _syncReadIncludeCurrent(false),
      _syncReadCount(0),
      _syncReadFeedbackLen(0),
      _syncReadSequence(0),
      _syncReadStartedUs(0),
      _syncReadDeadlineUs(0)
{
    memset(_feedback, 0, sizeof(_feedback));
    memset(_torqueDisabled, 0, sizeof(_torqueDisabled));
    memset(_multiTurnConfigured, 0, sizeof(_multiTurnConfigured));
    memset(_syncReadIds, 0, sizeof(_syncReadIds));
}

/* void FeetechServoDriver::begin */
void FeetechServoDriver::begin(uint8_t busIndex, int rxPin, int txPin, uint32_t baud)
{
    HardwareSerial* serial = NULL;
    switch (busIndex) {
        case 0: serial = &Serial1; break;
        case 1: serial = &Serial2; break;
        case 2: serial = &Serial3; break;
        case 3: serial = &Serial4; break;
        default: return;
    }

    _serial = serial;
    _busIndex = busIndex;
    _rxPin = rxPin;
    _txPin = txPin;
    _baud = baud;
    // 必须在 begin() 前扩大 Arduino UART RX ring；不设置 TX ring，命令立即下发。
    _serial->setRxBufferSize(kServoBusUartRxBufferBytes);
    _serial->begin(baud, SERIAL_8N1, rxPin, txPin);
    _sms.pSerial = _serial;
}

bool FeetechServoDriver::checkOnlineConfiguration(uint8_t id)
{
    if (!_serial || id > MAX_SERVO_ID) return false;
    if (_multiTurnConfigured[id]) return true;
    auto& feedback = _feedback[id];
    uint8_t version[2] = {};
    if (_sms.Read(id, 0, version, sizeof(version)) != sizeof(version) || _sms.getState()) {
        feedback.onlineCheck = ServoOnlineCheck::VersionReadFailed;
        return false;
    }
    feedback.firmwareMajor = version[0];
    feedback.firmwareMinor = version[1];
    if (version[0] < 3 || (version[0] == 3 && version[1] < 10)) {
        feedback.onlineCheck = ServoOnlineCheck::UnsupportedFirmware;
        return false;
    }
    feedback.onlineCheck = ServoOnlineCheck::ConfigurationFailed;
    uint8_t config[11] = {}, profile[3] = {}, overload[3] = {};
    if (_sms.Read(id, 8, config, sizeof(config)) != sizeof(config) || _sms.getState() ||
        _sms.Read(id, 84, profile, sizeof(profile)) != sizeof(profile) || _sms.getState() ||
        _sms.Read(id, 34, overload, sizeof(overload)) != sizeof(overload) || _sms.getState()) return false;
    const int unloadCondition = _sms.readByte(id, 19);
    if (unloadCondition < 0 || _sms.getState()) return false;
    const uint8_t unloadDesired = (uint8_t)((uint8_t)unloadCondition | 0x20);
    // 负载保护只保留舵机自己：过载扭矩 95%（寄存器36）、保护时间 2 s（寄存器35）。
    constexpr uint8_t kOverloadTorquePercent = 95;
    constexpr uint8_t kProtectionTime10ms = 200;
    const bool overloadDiffer = overload[1] != kProtectionTime10ms ||
                                overload[2] != kOverloadTorquePercent ||
                                unloadDesired != (uint8_t)unloadCondition;
    const uint8_t phase = config[10] | 0x10;
    const uint8_t desired[3] = {254, 254, 0};
    const bool limitsDiffer = config[1] || config[2] || config[3] || config[4];
    const int initialLock = _sms.readByte(id, SMS_STS_LOCK);
    if (initialLock < 0 || _sms.getState()) return false;
    const bool different = initialLock != 1 || config[0] != 1 || phase != config[10] || limitsDiffer ||
        overloadDiffer || memcmp(profile, desired, sizeof(profile));
    if (different) {
        if (!setTorqueEnabled(id, false)) {
            // A reply-level 0 motor may have applied torque-off without ACK.
            if (_sms.readByte(id, SMS_STS_TORQUE_ENABLE) != 0 || _sms.getState()) return false;
            _torqueDisabled[id] = true;
        }
        _sms.unLockEprom(id);
        if (_sms.readByte(id, SMS_STS_LOCK) != 0 || _sms.getState()) {
            _sms.LockEprom(id);
            return false;
        }
        if (config[0] != 1) _sms.writeByte(id, 8, 1);
        uint8_t limits[4] = {};
        if (limitsDiffer) _sms.genWrite(id, SMS_STS_MIN_ANGLE_LIMIT_L, limits, sizeof(limits));
        if (phase != config[10]) _sms.writeByte(id, 18, phase);
        if (overload[1] != kProtectionTime10ms) _sms.writeByte(id, 35, kProtectionTime10ms);
        if (overload[2] != kOverloadTorquePercent) _sms.writeByte(id, 36, kOverloadTorquePercent);
        if (unloadDesired != (uint8_t)unloadCondition) _sms.writeByte(id, 19, unloadDesired);
        for (uint8_t i = 0; i < 3; ++i) {
            if (profile[i] != desired[i]) _sms.writeByte(id, 84 + i, desired[i]);
        }
        delay(kMultiTurnConfigDelayMs);
        _sms.LockEprom(id);
        delay(kMultiTurnConfigDelayMs);
        uint8_t overloadAfter[3] = {};
        if (_sms.readByte(id, SMS_STS_LOCK) != 1 || _sms.getState() ||
            _sms.Read(id, 8, config, sizeof(config)) != sizeof(config) || _sms.getState() ||
            _sms.Read(id, 84, profile, sizeof(profile)) != sizeof(profile) || _sms.getState() ||
            _sms.Read(id, 34, overloadAfter, sizeof(overloadAfter)) != sizeof(overloadAfter) ||
            _sms.getState() ||
            overloadAfter[1] != kProtectionTime10ms ||
            overloadAfter[2] != kOverloadTorquePercent ||
            _sms.readByte(id, 19) != (int)unloadDesired || _sms.getState() ||
            config[0] != 1 || config[10] != phase || config[1] || config[2] || config[3] || config[4] ||
            memcmp(profile, desired, sizeof(profile))) return false;
    }
    feedback.onlineCheck = ServoOnlineCheck::Ready;
    _multiTurnConfigured[id] = true;
    FW_LOG_INFO_PRINTF("[SERVO OVERLOAD CFG] id=%u time10ms=%u torque=%u unload=0x%02X\r\n",
                       (unsigned)id, (unsigned)kProtectionTime10ms,
                       (unsigned)kOverloadTorquePercent, (unsigned)unloadDesired);
    return true;
}

/* bool FeetechServoDriver::buzzMaintenance */
bool FeetechServoDriver::buzzMaintenance(uint8_t id, uint8_t counts, int32_t& origin)
{
    if (!_serial || id > MAX_SERVO_ID || !_feedback[id].online ||
        _feedback[id].motorStatus != 0 || counts == 0) {
        return false;
    }
    const unsigned long savedTimeout = _sms.IOTimeOut;
    _sms.IOTimeOut = 10;
    const int raw = _sms.readWord(id, SMS_STS_PRESENT_POSITION_L);
    const bool positionOk = raw >= 0 && _sms.getState() == 0;
    // 寄存器 18 的 0x10 位就是上线检查写的多圈配置位：未开多圈时位置只有 0..4095。
    const int phase = _sms.readByte(id, 18);
    const bool phaseOk = phase >= 0 && _sms.getState() == 0;
    _sms.IOTimeOut = savedTimeout;
    if (!positionOk || !phaseOk) {
        return false;
    }
    if (origin == INT32_MAX) {
        origin = (raw & 0x8000) ? -(int32_t)(raw & 0x7fff) : (int32_t)raw;
    }
    if (origin < kServoHardwareCommandMin || origin > kServoHardwareCommandMax) {
        return false;
    }
    const int32_t step = counts > 128 ? 128 : counts;
    int32_t target;
    const int channel = findMotorChannelByServoId(id);
    if (channel >= 0) {
        // 振动只往松绳方向走：断电对账的危险侧是收绳方向。
        target = origin - getMotorTendonShortenAbsSign((uint8_t)channel) * step;
        if ((phase & 0x10) == 0) {
            target = target < 0 ? 0 : (target > 4095 ? 4095 : target);
        }
    } else {
        // 没有产品绑定的 ID（27-30、253）没有收绳方向，只避开单圈边界。
        target = origin > 2048 ? origin - step : origin + step;
    }
    if (target < kServoHardwareCommandMin || target > kServoHardwareCommandMax) return false;
    const bool wasDisabled = _torqueDisabled[id];
    const bool ok = _sms.WritePosEx(id, origin, SERVO_TARGET_SPEED_DEFAULT, 254) > 0
                 && setTorqueEnabled(id, true)
                 && _sms.WritePosEx(id, target, SERVO_TARGET_SPEED_DEFAULT, 254) > 0;
    delay(kMaintenanceBuzzHoldMs);
    const bool returned = _sms.WritePosEx(id, origin, SERVO_TARGET_SPEED_DEFAULT, 254) > 0;
    delay(kMaintenanceBuzzHoldMs);
    const bool restored = !wasDisabled || setTorqueEnabled(id, false);
    return ok && returned && restored;
}

/* bool FeetechServoDriver::setTarget */
bool FeetechServoDriver::setTarget(uint8_t id, int32_t logicalPosition, uint16_t speed, uint8_t acc)
{
    int16_t hardwarePosition = 0;
    if (!validateAbsoluteTarget(id, logicalPosition, &hardwarePosition)) {
        return false;
    }
    return queueTarget(id, hardwarePosition, speed, acc);
}

/* void FeetechServoDriver::syncWriteAll */
void FeetechServoDriver::syncWriteAll()
{
    if (_writeCount == 0 || !_serial) {
        return;
    }
    _sms.SyncWritePosEx(_writeIDs, _writeCount, _writePos, _writeSpd, _writeAcc);
    _writeCount = 0;
}

/* ServoSyncReadResult FeetechServoDriver::collectSyncRead */
ServoSyncReadResult FeetechServoDriver::collectSyncRead(uint64_t nowUs)
{
    ServoSyncReadResult result = {
        _syncReadActive ? ServoSyncReadState::Pending
                        : ServoSyncReadState::Idle,
        _syncReadCount,
        0,
        _sms.syncReadBufferedBytes(),
        _sms.syncReadExpectedBytes(),
        _syncReadSequence,
        _syncReadStartedUs,
        0,
    };
    if (!_syncReadActive) {
        return result;
    }

    _sms.syncReadCollectAvailable();
    result.bufferedBytes = _sms.syncReadBufferedBytes();
    result.expectedBytes = _sms.syncReadExpectedBytes();
    const bool allBytesReceived =
        result.expectedBytes != 0 &&
        result.bufferedBytes >= result.expectedBytes;
    const bool deadlineReached = nowUs >= _syncReadDeadlineUs;
    if (!allBytesReceived && !deadlineReached) {
        return result;
    }

    uint8_t successCount = 0;
    for (uint8_t i = 0; i < _syncReadCount; i++) {
        const uint8_t id = _syncReadIds[i];
        uint8_t rxBuf[15] = {0};
        const int rxLen = _sms.syncReadPacketRx(id, rxBuf);
        if (id > MAX_SERVO_ID) {
            continue;
        }
        captureReadDiagnostic(id, true, _syncReadFeedbackLen,
                              (uint32_t)((nowUs - _syncReadStartedUs) / 1000U),
                              rxLen != _syncReadFeedbackLen);
        if (rxLen == _syncReadFeedbackLen) {
            const int16_t current = _syncReadIncludeCurrent
                ? decodeSigned(rxBuf[13], rxBuf[14])
                : _feedback[id].current;
            // 状态字节非 0 表示舵机故障，但位置/负载仍然有效：保留遥测，只标记故障。
            recordFeedbackSuccess(id,
                                  decodeSigned(rxBuf[0], rxBuf[1]),
                                  decodeSigned(rxBuf[2], rxBuf[3]),
                                  decodeServoLoad(rxBuf[4], rxBuf[5]),
                                  current,
                                  rxBuf[6],
                                  rxBuf[7],
                                  _sms.getState());
            successCount++;
        } else {
            markReadFailure(id);
        }
    }

    _sms.syncReadEnd();
    _syncReadActive = false;
    result.successCount = successCount;
    result.completedUs = nowUs;
    result.state = successCount == _syncReadCount
        ? ServoSyncReadState::Complete
        : (deadlineReached ? ServoSyncReadState::TimedOut
                           : ServoSyncReadState::ProtocolError);
    _syncReadCount = 0;
    return result;
}

/* void FeetechServoDriver::abortSyncRead */
void FeetechServoDriver::abortSyncRead(bool markFailure)
{
    if (!_syncReadActive) {
        return;
    }
    if (markFailure) {
        for (uint8_t i = 0; i < _syncReadCount; ++i) {
            if (_syncReadIds[i] <= MAX_SERVO_ID) {
                markReadFailure(_syncReadIds[i]);
            }
        }
    }
    _sms.syncReadCollectAvailable();
    _sms.syncReadEnd();
    _syncReadActive = false;
    _syncReadCount = 0;
}
