mm-hand/mmhand-core-software/ESP32-P4/src/tasks/servo_bus/ServoBusTask.cpp

/**
 * @file ServoBusTask.cpp
 * @brief 驱动舵机运行服务，拥有周期等待与截止时间统计。
 * @details 本文件不访问飞特 SDK，四条舵机总线所有权属于 ServoRuntimeService。
 */
#include "ServoBusTask.h"
#include <Arduino.h>
#include "ServoBusService.h"
#include "../../config/ServoConfig.h"
#include "../../system/rtos/PeriodicDeadline.h"
#include "../../system/time/Clock.h"
#include "../../system/SystemRuntimeContext.h"
#include "../../system/adapters/ServiceContextAdapter.h"
#include "../../system/TaskRuntimeMetrics.h"
void servoBusTask(void* parameter)
{
    SystemRuntimeContext* sharedData = static_cast<SystemRuntimeContext*>(parameter);
    if (!sharedData ||
        !initServoBusService(sharedData, p4::platform::time::monotonicMillis())) {
        vTaskDelete(NULL);
        return;
    }
    sharedData->servoBusWake.bind(xTaskGetCurrentTaskHandle());
    // 再在约3 ms后的收集点统一解析，等待期间四路UART由硬件并行接收。
    const TickType_t periodTicks = pdMS_TO_TICKS(
        mmhand::config::servo::kServoBusServicePeriodMs);
    p4::platform::rtos::PeriodicDeadline deadline(periodTicks);
    uint32_t wakeReasons = 0;
    for (;;) {
        const TickType_t dispatchTicks = xTaskGetTickCount();
        const uint64_t dispatchUs = p4::platform::time::monotonicMicros();
        const bool periodicDue = deadline.due(dispatchTicks);
        const bool feedbackCollectDue = servoBusFeedbackCollectDue(dispatchUs);
        if (!periodicDue && !feedbackCollectDue && wakeReasons == 0U) {
            TickType_t waitTicks = deadline.remaining(dispatchTicks);
            const uint32_t feedbackWaitMs = servoBusFeedbackWaitMs(dispatchUs);
            if (feedbackWaitMs != 0U) {
                const TickType_t feedbackWaitTicks = pdMS_TO_TICKS(feedbackWaitMs);
                if (feedbackWaitTicks < waitTicks) {
                    waitTicks = feedbackWaitTicks;
                }
            }
            wakeReasons = sharedData->servoBusWake.wait(waitTicks);
            continue;
        }
        if (periodicDue) deadline.advancePast(dispatchTicks);
        const TickType_t loopBegin = xTaskGetTickCount();
        taskRuntimeMarkLoopStart(TASK_RUNTIME_SERVO_BUS);
        taskRuntimeMarkCycle(TASK_RUNTIME_SERVO_BUS, periodicDue, wakeReasons != 0U);
        const uint32_t nowMs = p4::platform::time::monotonicMillis();
        const ServoServiceInputSnapshot input =
            captureServoServiceInput(sharedData, nowMs);
        const ServiceOutputPort output = makeSystemServiceOutputPort(sharedData);
        const ServoBusStepRequest request = {wakeReasons, periodicDue, feedbackCollectDue};
        wakeReasons = 0;
        stepServoBusService(sharedData, input, output, request);
        taskRuntimeFinishCycle(TASK_RUNTIME_SERVO_BUS, periodicDue, loopBegin, periodTicks, deadline);
    }
    vTaskDelete(NULL);
}
