mm-hand/mmhand-core-software/ESP32-P4/src/tasks/host_comm/HostCommandDispatcher.cpp

/**
 * @file HostCommandDispatcher.cpp
 * @brief 实现上位机命令的长度校验、状态门禁、执行分发与 ACK 返回。
 * @details 本文件只处理已经由 HostFrameReader 解码完成的 CMD+payload。
 */
#include "HostCommandDispatcher.h"
#include "HostCommService.h"
#include "../../system/time/Clock.h"
#include "HostTelemetryPublisher.h"
#include "HostAckPublisher.h"
#include "HostProtocolCodec.h"
#include "../../safety/policies/ProtocolContractPolicy.h"
#include "HostCalibrationCommandHandler.h"
#include "../../data/SafetyTypes.h"
#include "../../system/SystemRuntimeContext.h"
#include "../../system/rtos/SharedSafetyState.h"
#include "../../system/calibration/CalibrationMath.h"
#include "../../system/calibration/CalibrationRuntimeStore.h"
#include "../../system/calibration/ManualEncoderReferenceStore.h"
#include "../../system/calibration/TendonCalibrationLut.h"
#include "../../config/protocol/HostProtocol.h"
#include "../../generated/UrdfJointLimits.generated.h"
#include "../../generated/ProductFingerprint.generated.h"
#include "../../hal/serial/HostSerialPort.h"
#include "../../config/topology/HardwareMap.h"
#include "../../config/ServoConfig.h"
#include "../../config/SafetyConfig.h"
#include "../../system/rtos/AtomicValue.h"
#include "../../system/log/FirmwareLog.h"
#include "../../system/ports/SystemEventPort.h"
#include "../../system/TaskRuntimeMetrics.h"
#include "../../safety/SafetyEventReporter.h"
#include "../../system/ports/DirectTargetResult.h"
#include "HostCommandRouter.h"
#include "../servo_bus/ServoMaintenance.h"
#include "../../control/ControlParameters.h"
#include "../../control/RampParameters.h"

#include <math.h>
#include <string.h>

using namespace p4::host;

namespace p4::host {

namespace {

void sendControlParameterResult(uint8_t block, uint8_t status)
{
    uint32_t revision = 0;
    uint32_t crc = 0;
    if (block == 1) {
        const auto applied = mmhand::control::readRampParameters();
        revision = applied.revision;
        crc = applied.crc;
    } else {
        const auto applied = mmhand::control::readParameters();
        revision = applied.revision;
        crc = applied.crc;
    }
    uint8_t packet[15] = {PROTOCOL_HEADER, 13, PACKET_TYPE_CONTROL_PARAMETERS, 1, block, status};
    size_t offset = 6;
    appendU32BigEndian(packet, &offset, revision);
    appendU32BigEndian(packet, &offset, crc);
    packet[offset++] = PROTOCOL_TAIL;
    FW_SERIAL_WRITE(packet, offset);
}

bool servoRebaseZeroPending(const SystemRuntimeContext* sharedData)
{
    return sharedAtomicLoad(&sharedData->servo_rebase_zero_request_token) !=
           sharedAtomicLoad(&sharedData->servo_rebase_zero_result_token);
}

bool commandConflictsWithServoRebaseZero(uint8_t command)
{
    switch (command) {
        case CMD_START:
        case CMD_RUN_FEEDBACK:
        case CMD_PULL_JOINT_INTO_WORKSPACE:
        case CMD_MOTOR_POS_ABS:
        case CMD_ANGLE_CTRL:
        case CMD_CALIB_LOAD_JOINT:
        case CMD_CALIB_LOAD_LIMITS:
            return true;
        default:
            return false;
    }
}

/**
 * Calib Load 的 ABS Limit 包可能来自较早的控制策略。加载完整结果后，
 * 以本次 LUT 拟合直线两端 + 可配置外延重建工作区；不再使用实测紧端，
 * 因为它只在标定姿态成立。单腱与双腱均使用已应用的运行参数。
 */
bool refreshLoadedJointAbsLimits(SystemRuntimeContext* sharedData,
                                 uint8_t jointIndex,
                                 const JointCalibrationResult& result)
{
    if (!sharedData) return false;
    const auto parameters = mmhand::control::readParameters();
    if (!parameters.configured) return false;
    const uint8_t count = getJointActuatorCount(jointIndex);
    if (count == 0 || count > TENDON_LUT_ACTUATOR_COUNT) return false;
    int32_t mins[TENDON_LUT_ACTUATOR_COUNT] = {}, maxs[TENDON_LUT_ACTUATOR_COUNT] = {};
    uint8_t motors[TENDON_LUT_ACTUATOR_COUNT] = {};
    for (uint8_t i = 0; i < count; ++i) {
        JointActuatorItem actuator{};
        if (!getJointActuator(jointIndex, i, &actuator) ||
            result.tendonLutMotor[i] != actuator.motorChannel ||
            !tendonCalibrationMotorAbsRangeWithMargins(result, i, actuator.motorChannel,
                parameters[mmhand::control::OutputLutReleaseMarginCounts],
                parameters[mmhand::control::OutputLutTightMarginCounts], &mins[i], &maxs[i])) return false;
        motors[i] = actuator.motorChannel;
    }
    SharedSafetyGuard guard;
    for (uint8_t i = 0; i < count; ++i) {
        sharedData->motor_abs_limit_min[motors[i]] = mins[i];
        sharedData->motor_abs_limit_max[motors[i]] = maxs[i];
        sharedAtomicFetchOr(&sharedData->motor_abs_limit_valid_bitmap, 1UL << motors[i]);
    }
    return true;
}

void refreshLoadedLutLimits(SystemRuntimeContext* sharedData, uint32_t motorMask)
{
    for (uint8_t joint = 0; joint < ENCODER_TOTAL_NUM; ++joint) {
        JointCalibrationRuntimeSnapshot snapshot{};
        if (!readJointCalibrationRuntimeSnapshot(joint, &snapshot) || !snapshot.result.success) continue;
        const uint8_t count = getJointActuatorCount(joint);
        bool selected = false;
        for (uint8_t i = 0; i < count; ++i) {
            JointActuatorItem actuator{};
            if (getJointActuator(joint, i, &actuator) && (motorMask & (1UL << actuator.motorChannel))) selected = true;
        }
        if (selected && !refreshLoadedJointAbsLimits(sharedData, joint, snapshot.result)) {
            // No stale 900-count boundary is allowed after a failed rebuild.
            for (uint8_t i = 0; i < count; ++i) {
                JointActuatorItem actuator{};
                if (getJointActuator(joint, i, &actuator))
                    sharedAtomicFetchAnd(&sharedData->motor_abs_limit_valid_bitmap, ~(1UL << actuator.motorChannel));
            }
        }
    }
}

} // namespace

/**
 * 上报 Mxx 到物理 BUS 的运行时路由快照。
 *
 * BUS 位置不再属于 HardwareMap，因此上位机必须依据本包区分扫描中、离线、
 * 重复 ID 和 BUS 超容量。数组顺序固定为 M00..M26。
 */
// 应用一帧已通过长度检查的下行命令，并返回对应协议 ACK。
void dispatchHostCommand(SystemRuntimeContext* sharedData, const uint8_t* frame, size_t frameLen)
{
    if (!sharedData || !frame || frameLen == 0) {
        return;
    }

    const uint8_t cmd = frame[0];
    const uint32_t nowMs = p4::platform::time::monotonicMillis();
    HostSerialPort::markCommand(nowMs);
    const uint32_t previousHeartbeat = sharedAtomicLoad(&sharedData->host_rx_heartbeat_ms);
    if (previousHeartbeat == 0 || (uint32_t)(nowMs - previousHeartbeat) >
            mmhand::config::safety::kHostControlLeaseTimeoutMs) {
        sharedAtomicStore(&sharedData->host_protocol_compatible, (uint8_t)0);
    }
    // 每一帧通过结构校验的上位机命令都刷新心跳，不要求它一定是运动命令。
    // SystemStateTask 在另一核心读取该字段，统一走原子接口避免租约边界读到撕裂值。
    sharedAtomicStore(&sharedData->host_rx_heartbeat_ms, nowMs);
    if (cmd == CMD_PROTOCOL_HELLO) {
        const bool compatible = p4::system::protocolContractMatches(
            frame[1], readU32BigEndian(frame + 2), readU32BigEndian(frame + 6),
            kHostProtocolVersion, kProductControlModelCrc, kProductHardwareMapCrc);
        sharedAtomicStore(&sharedData->host_protocol_compatible, (uint8_t)compatible);
        if (!compatible) requestEmergencyStop(sharedData);
        sendProtoAckPacket(cmd, sharedData->system_state,
                           compatible ? PROTO_ACK_STATUS_OK : PROTO_ACK_STATUS_CONTRACT_MISMATCH);
        return;
    }
    if (generatedCommandRequiresHandshake(cmd) &&
        !sharedAtomicLoad(&sharedData->host_protocol_compatible)) {
        sendProtoAckPacket(cmd, sharedData->system_state, PROTO_ACK_STATUS_CONTRACT_MISMATCH);
        return;
    }

    if (cmd == CMD_PARAMETERS_QUERY) {
        const uint8_t block = frameLen >= 2 ? frame[1] : 0xFF;
        if (block == 0) {
            sendControlParameterResult(0, mmhand::control::parametersConfigured() ? 0 : 3);
        } else if (block == 1) {
            sendControlParameterResult(1, mmhand::control::rampParametersConfigured() ? 0 : 3);
        } else {
            sendProtoAckPacket(cmd, sharedData->system_state, PROTO_ACK_STATUS_INVALID_DATA);
        }
        return;
    }
    if (cmd == CMD_CONTROL_PARAMETERS_SET) {
        const bool idle = !sharedAtomicLoad(&sharedData->control_enabled) &&
            sharedAtomicLoad(&sharedData->servo_target_owner) == SERVO_TARGET_OWNER_NONE &&
            (sharedData->system_state == SYSTEM_STATE_UNCONTROLLABLE ||
             sharedData->system_state == SYSTEM_STATE_IDLE ||
             sharedData->system_state == SYSTEM_STATE_READY ||
             sharedData->system_state == SYSTEM_STATE_JOINT_BEYOND_WORKSPACE);
        const uint8_t result = !idle || servoMaintenanceBlocksCommands() ? 2 :
            mmhand::control::applyParameterPayload(frame + 1, frameLen - 1) ? 0 : 1;
        if (result == 0) refreshLoadedLutLimits(sharedData, validMotorChannelMask());
        sendControlParameterResult(0, result);
        sendProtoAckPacket(cmd, sharedData->system_state, result == 0 ?
            PROTO_ACK_STATUS_OK : result == 2 ? PROTO_ACK_STATUS_UNSUPPORTED_MODE : PROTO_ACK_STATUS_INVALID_DATA);
        return;
    }
    if (cmd == CMD_CONTROL_RAMP_PARAMETERS_SET) {
        const bool idle = !sharedAtomicLoad(&sharedData->control_enabled) &&
            sharedAtomicLoad(&sharedData->servo_target_owner) == SERVO_TARGET_OWNER_NONE &&
            (sharedData->system_state == SYSTEM_STATE_UNCONTROLLABLE ||
             sharedData->system_state == SYSTEM_STATE_IDLE ||
             sharedData->system_state == SYSTEM_STATE_READY ||
             sharedData->system_state == SYSTEM_STATE_JOINT_BEYOND_WORKSPACE);
        const uint8_t result = !idle || servoMaintenanceBlocksCommands() ? 2 :
            mmhand::control::applyRampParameterPayload(frame + 1, frameLen - 1) ? 0 : 1;
        sendControlParameterResult(1, result);
        sendProtoAckPacket(cmd, sharedData->system_state, result == 0 ?
            PROTO_ACK_STATUS_OK : result == 2 ? PROTO_ACK_STATUS_UNSUPPORTED_MODE : PROTO_ACK_STATUS_INVALID_DATA);
        return;
    }
    if ((cmd == CMD_RUN_FEEDBACK || cmd == CMD_START || cmd == CMD_MOTOR_POS_ABS ||
         cmd == CMD_ANGLE_CTRL) &&
        !mmhand::control::parametersConfigured()) {
        FW_LOG_WARN_PRINTF("[UPPER] motion rejected cmd=0x%02X parameters not configured\r\n", (unsigned)cmd);
        sendProtoAckPacket(cmd, sharedData->system_state, PROTO_ACK_STATUS_INVALID_DATA);
        return;
    }

    if (cmd == CMD_SERVO_MAINTENANCE) {
        const bool queued = frameLen == 13 && submitServoMaintenance(frame + 1);
        sendProtoAckPacket(cmd, sharedData->system_state, queued ? PROTO_ACK_STATUS_QUEUED : PROTO_ACK_STATUS_UNSUPPORTED_MODE);
        return;
    }
    if (cmd == CMD_STOP) cancelServoMaintenance();
    if (servoMaintenanceBlocksCommands() && cmd != CMD_STOP && cmd != CMD_HOST_HEARTBEAT &&
        cmd != CMD_STATE_SYNC_REQUEST && cmd != CMD_DIAGNOSTICS_SUBSCRIBE) {
        sendProtoAckPacket(cmd, sharedData->system_state, PROTO_ACK_STATUS_UNSUPPORTED_MODE);
        return;
    }
    if (servoRebaseZeroPending(sharedData) &&
        commandConflictsWithServoRebaseZero(cmd)) {
        sendProtoAckPacket(cmd, sharedData->system_state,
                           PROTO_ACK_STATUS_UNSUPPORTED_MODE);
        return;
    }
    if (sharedAtomicLoad(&sharedData->direct_target_request_generation) !=
            sharedAtomicLoad(&sharedData->direct_target_result_generation) &&
        (cmd == CMD_MOTOR_ABS_ZERO ||
         cmd == CMD_TRUST_MULTITURN || cmd == CMD_ACTIVE_SCOPE)) {
        sendProtoAckPacket(cmd, sharedData->system_state,
                           PROTO_ACK_STATUS_UNSUPPORTED_MODE);
        return;
    }

    if (cmd == CMD_HOST_HEARTBEAT)
    {
        return;
    }
    if (cmd == CMD_STATE_SYNC_REQUEST)
    {
        const uint32_t requestedMask = readU32BigEndian(frame + 1);
        if ((requestedMask & ~((uint32_t)STATE_SYNC_ALL)) != 0) {
            sendProtoAckPacket(CMD_STATE_SYNC_REQUEST,
                               sharedData->system_state,
                               PROTO_ACK_STATUS_INVALID_DATA);
        } else {
            requestHostStateSync(requestedMask);
            sendProtoAckPacket(CMD_STATE_SYNC_REQUEST,
                               sharedData->system_state,
                               PROTO_ACK_STATUS_OK);
        }
        return;
    }
    if (cmd == CMD_DIAGNOSTICS_SUBSCRIBE)
    {
        const uint8_t flags = frameLen >= 3 ? frame[1] : 0xFF;
        const uint8_t divisor = frameLen >= 3 ? frame[2] : 0;
        if (flags > 3 || divisor == 0 || divisor > 100) {
            sendProtoAckPacket(CMD_DIAGNOSTICS_SUBSCRIBE,
                               sharedData->system_state,
                               PROTO_ACK_STATUS_INVALID_DATA);
        } else {
            setHostTaskDiagSubscribed((flags & 1) != 0, nowMs);
            setHostControlTraceSubscribed((flags & 2) != 0, divisor);
            sendProtoAckPacket(CMD_DIAGNOSTICS_SUBSCRIBE,
                               sharedData->system_state,
                               PROTO_ACK_STATUS_OK);
        }
        return;
    }

    if (cmd == CMD_PULL_JOINT_INTO_WORKSPACE)
    {
        const uint32_t requestedMask =
            readU32BigEndian(frame + 1) & kManualEncoderReferenceFullMask;
        const uint32_t activeMask =
            sharedAtomicLoad(&sharedData->active_joint_mask) &
            kManualEncoderReferenceFullMask;
        uint8_t status = PROTO_ACK_STATUS_QUEUED;
        if (requestedMask == 0 || requestedMask != activeMask) {
            status = PROTO_ACK_STATUS_INVALID_DATA;
        } else if (!activeManualReferencesReady(sharedData)) {
            status = PROTO_ACK_STATUS_MANUAL_REFERENCE_REQUIRED;
        } else if ((autoCalibrationValidMask(sharedData) & requestedMask) !=
                   requestedMask) {
            status = PROTO_ACK_STATUS_CALIBRATION_REQUIRED;
        } else if (sharedData->system_state != SYSTEM_STATE_IDLE &&
                   sharedData->system_state != SYSTEM_STATE_READY &&
                   sharedData->system_state != SYSTEM_STATE_JOINT_BEYOND_WORKSPACE) {
            status = PROTO_ACK_STATUS_UNSUPPORTED_MODE;
        } else if (!postSystemEvent(sharedData, SYSTEM_EVENT_PULL_JOINT_INTO_WORKSPACE)) {
            status = PROTO_ACK_STATUS_UNSUPPORTED_MODE;
        }
        sendProtoAckPacket(CMD_PULL_JOINT_INTO_WORKSPACE, sharedData->system_state, status);
        return;
    }

    if (cmd != CMD_RUN_FEEDBACK && commandRequiresManualReference(cmd) &&
        !activeManualReferencesReady(sharedData)) {
        sendProtoAckPacket(cmd,
                           sharedData->system_state,
                           PROTO_ACK_STATUS_MANUAL_REFERENCE_REQUIRED);
        return;
    }

    if (cmd == CMD_CONTROL_RELEASE)
    {
        const uint8_t state = sharedData->system_state;
        const bool ordinary = state == SYSTEM_STATE_RUN_DIRECT || state == SYSTEM_STATE_RUN_FEEDBACK;
        const bool idle = state == SYSTEM_STATE_UNCONTROLLABLE || state == SYSTEM_STATE_IDLE ||
                          state == SYSTEM_STATE_READY || state == SYSTEM_STATE_JOINT_BEYOND_WORKSPACE;
        const bool accepted = (ordinary || idle) &&
            (sharedData->servo_target_owner == SERVO_TARGET_OWNER_NONE ||
             sharedData->servo_target_owner == SERVO_TARGET_OWNER_CONTROL) &&
            !servoRebaseZeroPending(sharedData) && !servoMaintenanceBlocksCommands() &&
            postSystemEvent(sharedData, SYSTEM_EVENT_CONTROL_RELEASE);
        sendProtoAckPacket(cmd, state, accepted ? PROTO_ACK_STATUS_QUEUED : PROTO_ACK_STATUS_UNSUPPORTED_MODE);
        return;
    }


    if (cmd == CMD_START)
    {
        postSystemEvent(sharedData, SYSTEM_EVENT_START);
        sendProtoAckPacket(CMD_START, sharedData->system_state, PROTO_ACK_STATUS_QUEUED);
        return;
    }

    if (cmd == CMD_RUN_FEEDBACK)
    {
        const uint32_t requestSequence =
            sharedAtomicAddFetch(&sharedData->feedback_admission_sequence, (uint32_t)1);
        sharedAtomicStore(&sharedData->feedback_admission_status,
                          (uint8_t)FEEDBACK_ADMISSION_PENDING);
        sharedAtomicStore(&sharedData->feedback_reject_reason,
                          (uint8_t)FEEDBACK_REJECT_NONE);
        if (!activeManualReferencesReady(sharedData)) {
            sharedAtomicStore(&sharedData->feedback_admission_status,
                              (uint8_t)FEEDBACK_ADMISSION_REJECTED);
            sharedAtomicStore(&sharedData->feedback_reject_reason,
                              (uint8_t)FEEDBACK_REJECT_MANUAL_REFERENCE);
            sendProtoAckPacket(
                CMD_RUN_FEEDBACK,
                sharedData->system_state,
                PROTO_ACK_STATUS_MANUAL_REFERENCE_REQUIRED);
        } else {
            if (!postSystemEventForToken(sharedData,
                                         SYSTEM_EVENT_RUN_FEEDBACK,
                                         requestSequence)) {
                sharedAtomicStore(&sharedData->feedback_admission_status,
                                  (uint8_t)FEEDBACK_ADMISSION_REJECTED);
                sharedAtomicStore(&sharedData->feedback_reject_reason,
                                  (uint8_t)FEEDBACK_REJECT_EVENT_QUEUE);
            }
            sendProtoAckPacket(CMD_RUN_FEEDBACK,
                               sharedData->system_state,
                               PROTO_ACK_STATUS_QUEUED);
        }
        return;
    }

    if (cmd == CMD_STOP)
    {
        taskRuntimeMarkStopReceived();
        const bool accepted = requestEmergencyStop(sharedData);
        sendProtoAckPacket(CMD_STOP,
                           sharedData->system_state,
                           accepted ? PROTO_ACK_STATUS_QUEUED
                                    : PROTO_ACK_STATUS_UNSUPPORTED_MODE);
        return;
    }

    if (cmd == CMD_RESET)
    {
        postSystemEvent(sharedData, SYSTEM_EVENT_RESET);
        sendProtoAckPacket(CMD_RESET, sharedData->system_state, PROTO_ACK_STATUS_QUEUED);
        return;
    }

    if (cmd == CMD_ANGLE_CTRL)
    {
        if (frameLen < 1 + kFloatPayloadBytes) {
            return;
        }
        const uint32_t jointMask =
            (uint32_t)frame[1] |
            ((uint32_t)frame[2] << 8) |
            ((uint32_t)frame[3] << 16) |
            ((uint32_t)frame[4] << 24);
        float parsedAngles[ENCODER_TOTAL_NUM] = {0.0f};
        if (parseFloatArrayLittleEndian(frame + 5,
                                        frameLen - 5,
                                        parsedAngles,
                                        ENCODER_TOTAL_NUM)) {
            upperApplyTargetAnglesMasked(sharedData,
                                         parsedAngles,
                                         ENCODER_TOTAL_NUM,
                                         jointMask);
        }
        return;
    }

    if (cmd == CMD_MOTOR_POS_ABS)
    {
        uint8_t status = PROTO_ACK_STATUS_QUEUED;
        int32_t targets[SERVO_TOTAL_NUM] = {};
        const uint32_t token = frameLen == 1 + kMotorPosAbsPayloadBytes
            ? readU32BigEndian(frame + 1) : 0;
        const uint32_t wireMask = frameLen == 1 + kMotorPosAbsPayloadBytes
            ? readU32BigEndian(frame + 5) : 0;
        const uint32_t activeMask =
            sharedAtomicLoad(&sharedData->active_motor_mask) & validMotorChannelMask();
        const uint32_t requestedMask = wireMask != 0 ? wireMask : activeMask;
        if (frameLen != 1 + kMotorPosAbsPayloadBytes ||
            requestedMask == 0 || (requestedMask & ~activeMask) != 0 ||
            !parseInt32ArrayBigEndian(frame + 9, SERVO_TOTAL_NUM * 4U,
                                       targets, SERVO_TOTAL_NUM)) {
            status = PROTO_ACK_STATUS_INVALID_DATA;
            FW_LOG_WARN_PRINTF("[UPPER] D3 invalid length=%u expected=%u requested=0x%08lX active=0x%08lX\r\n",
                (unsigned)frameLen, (unsigned)(1 + kMotorPosAbsPayloadBytes),
                (unsigned long)requestedMask, (unsigned long)activeMask);
        } else if (!upperApplyMotorTargets(
            sharedData, targets, SERVO_TOTAL_NUM, token, requestedMask,
            readU16BigEndian(frame + 117), frame[119])) {
            status = PROTO_ACK_STATUS_UNSUPPORTED_MODE;
        }
        sendProtoAckPacket(CMD_MOTOR_POS_ABS, sharedData->system_state, status);
        return;
    }

    if (cmd == CMD_MOTOR_DIRECT_RELEASE)
    {
        const uint8_t status =
            frameLen != 1 + kMotorDirectReleasePayloadBytes
                ? PROTO_ACK_STATUS_INVALID_DATA
                : upperReleaseMotorDirect(sharedData, readU32BigEndian(frame + 1))
                    ? PROTO_ACK_STATUS_QUEUED : PROTO_ACK_STATUS_UNSUPPORTED_MODE;
        sendProtoAckPacket(CMD_MOTOR_DIRECT_RELEASE, sharedData->system_state, status);
        return;
    }

    if (cmd == CMD_ACTIVE_SCOPE)
    {
        uint8_t status = PROTO_ACK_STATUS_OK;
        if (frameLen < 1 + kActiveScopePayloadBytes) {
            status = PROTO_ACK_STATUS_UNSUPPORTED_MODE;
        } else {
            const uint32_t activeMotorMask = readU32BigEndian(frame + 1);
            const uint32_t activeJointMask = readU32BigEndian(frame + 5);
            const uint8_t requireCanFeedback = frame[9] ? 1 : 0;
            if (activeMotorMask == 0) {
                status = PROTO_ACK_STATUS_UNSUPPORTED_MODE;
            } else {
                if (!upperApplyActiveScope(sharedData,
                                           activeMotorMask,
                                           activeJointMask,
                                           requireCanFeedback)) {
                    status = PROTO_ACK_STATUS_UNSUPPORTED_MODE;
                }
            }
        }
        if (status == PROTO_ACK_STATUS_OK) {
            postSystemEvent(sharedData, SYSTEM_EVENT_REEVALUATE_READY);
        }
        sendProtoAckPacket(CMD_ACTIVE_SCOPE, sharedData->system_state, status);
        return;
    }

    if (cmd == CMD_TRUST_MULTITURN)
    {
        uint8_t status = PROTO_ACK_STATUS_OK;
        const uint8_t state = sharedData->system_state;
        const bool idle = state == SYSTEM_STATE_UNCONTROLLABLE ||
                          state == SYSTEM_STATE_IDLE ||
                          state == SYSTEM_STATE_READY ||
                          state == SYSTEM_STATE_JOINT_BEYOND_WORKSPACE;
        const uint32_t motorMask =
            frameLen >= 1 + kTrustMultiTurnPayloadBytes
                ? (readU32BigEndian(frame + 1) & validMotorChannelMask())
                : 0;
        if (frameLen < 1 + kTrustMultiTurnPayloadBytes || motorMask == 0) {
            status = PROTO_ACK_STATUS_INVALID_DATA;
        } else if (!idle || sharedData->control_enabled != 0 ||
                   sharedData->servo_target_owner != SERVO_TARGET_OWNER_NONE ||
                   sharedAtomicLoad(&sharedData->emergency_stop_latched) != 0) {
            status = PROTO_ACK_STATUS_UNSUPPORTED_MODE;
        } else {
            SemaphoreHandle_t lock = sharedData->commandStateMutex;
            if (lock && xSemaphoreTake(lock, pdMS_TO_TICKS(10)) != pdTRUE) {
                status = PROTO_ACK_STATUS_UNSUPPORTED_MODE;
            } else {
                sharedData->trust_multi_turn_request_mask = motorMask;
                sharedAtomicAddFetch(&sharedData->trust_multi_turn_request_token,
                                     (uint32_t)1);
                if (lock) {
                    xSemaphoreGive(lock);
                }
            }
        }
        FW_LOG_INFO_PRINTF(
            "[UPPER] TRUST_MULTITURN request status=%u mask=0x%08lX\r\n",
            (unsigned)status,
            (unsigned long)sharedData->trust_multi_turn_request_mask);
        sendProtoAckPacket(CMD_TRUST_MULTITURN, sharedData->system_state, status);
        return;
    }

    if (cmd == CMD_CALIB_LOAD_LIMITS)
    {
        uint8_t status = PROTO_ACK_STATUS_OK;
        if (frameLen != 1 + kCalibLoadLimitsPayloadBytes) {
            status = PROTO_ACK_STATUS_UNSUPPORTED_MODE;
        } else if (sharedData->system_state == SYSTEM_STATE_RUN_DIRECT ||
                   sharedData->system_state == SYSTEM_STATE_RUN_FEEDBACK ||
                   sharedData->system_state == SYSTEM_STATE_PULL_JOINT_INTO_WORKSPACE_RUNNING) {
            status = PROTO_ACK_STATUS_UNSUPPORTED_MODE;
        } else {
            const uint32_t updateMask =
                readU32BigEndian(frame + 1) & validMotorChannelMask();
            const uint32_t validMask =
                readU32BigEndian(frame + 5) & validMotorChannelMask();
            int32_t loadedMin[SERVO_TOTAL_NUM] = {0};
            int32_t loadedMax[SERVO_TOTAL_NUM] = {0};
            const uint8_t* p = frame + 9;
            for (uint8_t ch = 0; ch < SERVO_TOTAL_NUM; ch++) {
                loadedMin[ch] = readI32BigEndian(p);
                p += 4;
                loadedMax[ch] = readI32BigEndian(p);
                p += 4;
            }
            if (updateMask == 0) {
                status = PROTO_ACK_STATUS_INVALID_DATA;
            } else {
                // 只覆盖快照声明的电机，保留其余关节已经加载或刚标定的 ABS 限位。
                uint32_t appliedValidMask = 0;
                {
                    SharedSafetyGuard guard;
                    const uint32_t previousValid =
                        sharedAtomicLoad(&sharedData->motor_abs_limit_valid_bitmap);
                    for (uint8_t ch = 0; ch < SERVO_TOTAL_NUM; ch++) {
                        if ((updateMask & (1UL << ch)) == 0) {
                            continue;
                        }
                        sharedData->motor_abs_limit_min[ch] = loadedMin[ch];
                        sharedData->motor_abs_limit_max[ch] = loadedMax[ch];
                    }
                    appliedValidMask =
                        (previousValid & ~updateMask) | (validMask & updateMask);
                    sharedAtomicStore(&sharedData->motor_abs_limit_valid_bitmap,
                                      appliedValidMask);
                }
                FW_LOG_INFO_PRINTF(
                    "[UPPER] CALIB_LOAD_LIMITS update=0x%08lX valid=0x%08lX\r\n",
                    (unsigned long)updateMask,
                    (unsigned long)appliedValidMask);
            }
        }
        if (status == PROTO_ACK_STATUS_OK) refreshLoadedLutLimits(sharedData,
            sharedAtomicLoad(&sharedData->motor_abs_limit_valid_bitmap));
        sendProtoAckPacket(CMD_CALIB_LOAD_LIMITS, sharedData->system_state, status);
        return;
    }

    if (cmd == CMD_CALIB_LOAD_JOINT)
    {
        uint8_t status = PROTO_ACK_STATUS_OK;
        uint8_t loadedJointIndex = 0xFF;
        if (frameLen != 1 + kCalibLoadJointPayloadBytes) {
            status = PROTO_ACK_STATUS_INVALID_DATA;
        } else if (sharedData->system_state == SYSTEM_STATE_RUN_DIRECT ||
                   sharedData->system_state == SYSTEM_STATE_RUN_FEEDBACK ||
                   sharedData->system_state == SYSTEM_STATE_PULL_JOINT_INTO_WORKSPACE_RUNNING) {
            status = PROTO_ACK_STATUS_UNSUPPORTED_MODE;
        } else {
            const uint8_t* p = frame + 1;
            const uint8_t jointIndex = *p++;
            loadedJointIndex = jointIndex;
            if (jointIndex >= ENCODER_TOTAL_NUM) {
                status = PROTO_ACK_STATUS_INVALID_DATA;
            } else {
                JointCalibrationResult result;
                memset(&result, 0, sizeof(result));
                result.success = (*p++ != 0);
                result.angleMax = readFloatBigEndian(p); p += 4;
                result.startEncoder = readI32BigEndian(p); p += 4;
                result.tightEncoder = readI32BigEndian(p); p += 4;
                result.zeroEncoder = readI32BigEndian(p); p += 4;
                result.encoderSpan = readI32BigEndian(p); p += 4;
                result.startServoAbs = readI32BigEndian(p); p += 4;
                result.tightServoAbs = readI32BigEndian(p); p += 4;
                result.zeroServoAbs = readI32BigEndian(p); p += 4;
                result.startDeg = readFloatBigEndian(p); p += 4;
                result.tightDeg = readFloatBigEndian(p); p += 4;
                result.totalDeg = readFloatBigEndian(p); p += 4;
                result.scaled = (*p++ != 0);
                result.tendonLutValid = (*p++ != 0) ? 1 : 0;
                result.tendonLutCount = *p++;
                result.tendonLutMotor[0] = *p++;
                result.tendonLutMotor[1] = *p++;
                result.tendonLutAngleStartDeg = readFloatBigEndian(p); p += 4;
                result.tendonLutAngleStepDeg = readFloatBigEndian(p); p += 4;
                for (uint8_t actuator = 0;
                     actuator < TENDON_LUT_ACTUATOR_COUNT; actuator++) {
                    const int32_t anchor = readI32BigEndian(p);
                    p += 4;
                    for (uint8_t sample = 0;
                         sample < TENDON_LUT_MAX_SAMPLES; sample++) {
                        const int16_t encoded = readI16BigEndian(p);
                        p += 2;
                        result.tendonLutMotorAbs[actuator][sample] =
                            anchor + (int32_t)encoded;
                    }
                }
                const uint8_t incomingMappingVersion = *p++;
                result.angleMin = readFloatBigEndian(p); p += 4;
                const uint32_t incomingUrdfCrc = readU32BigEndian(p); p += 4;
                const uint16_t autoMinRaw = readU16BigEndian(p); p += 2;
                const uint16_t autoMaxRaw = readU16BigEndian(p); p += 2;
                const uint32_t incomingManualCrc = readU32BigEndian(p); p += 4;
                // V5: 原先闲置的两个 float 槽承载 angleK/angleB；payload 仍为 188 字节。
                result.angleK = readFloatBigEndian(p); p += 4;
                result.angleB = readFloatBigEndian(p); p += 4;

                const uint32_t localManualEntryCrc =
                    manualEncoderReferenceEntryCrc(
                        jointIndex, g_manualEncoderReference[jointIndex]);
                const uint32_t localValidMask =
                    sharedAtomicLoad(&sharedData->manual_reference_valid_bitmap);
                // S3 只发映射 raw；start/tight 就是 Auto 端点的 raw，P4 不再取反。
                const uint16_t expectedAutoMinRaw =
                    (uint16_t)calibrationWrapEncoderCount(
                        result.startEncoder);
                const uint16_t expectedAutoMaxRaw =
                    (uint16_t)calibrationWrapEncoderCount(
                        result.tightEncoder);
                if (incomingMappingVersion !=
                        kManualScaledUrdfFeedbackMappingVersion ||
                    incomingUrdfCrc != kManualScaledUrdfConfigCrc) {
                    status = PROTO_ACK_STATUS_CALIBRATION_REQUIRED;
                } else if (incomingManualCrc != localManualEntryCrc) {
                    status = PROTO_ACK_STATUS_MANUAL_CRC_MISMATCH;
                } else if ((localValidMask & (1UL << jointIndex)) == 0) {
                    status = PROTO_ACK_STATUS_MANUAL_REFERENCE_REQUIRED;
                } else if (autoMinRaw != expectedAutoMinRaw ||
                           autoMaxRaw != expectedAutoMaxRaw) {
                    FW_LOG_WARN_PRINTF(
                        "[UPPER] CALIB_LOAD reject J%02u raw endpoint "
                        "contract: incoming=%u->%u expected=%u->%u; "
                        "recalibration required\r\n",
                        (unsigned)jointIndex,
                        (unsigned)autoMinRaw,
                        (unsigned)autoMaxRaw,
                        (unsigned)expectedAutoMinRaw,
                        (unsigned)expectedAutoMaxRaw);
                    status = PROTO_ACK_STATUS_INVALID_DATA;
                } else if (!applyManualScaledUrdfMappingToCalibration(
                               jointIndex,
                               g_manualEncoderReference[jointIndex],
                               autoMinRaw,
                               autoMaxRaw,
                               localManualEntryCrc,
                               &result)) {
                    status = PROTO_ACK_STATUS_INVALID_DATA;
                } else if (result.success &&
                           (!isfinite(result.startDeg) ||
                            !isfinite(result.tightDeg) ||
                            !isfinite(result.totalDeg) ||
                            result.encoderSpan <= 0 || result.totalDeg <= 0.0f ||
                            !calibrationTendonLutMatchesJoint(jointIndex,
                                                             result))) {
                    status = PROTO_ACK_STATUS_INVALID_DATA;
                } else if (result.success &&
                           !refreshLoadedJointAbsLimits(
                               sharedData, jointIndex, result)) {
                    status = PROTO_ACK_STATUS_INVALID_DATA;
                    FW_LOG_WARN_PRINTF(
                        "[UPPER] CALIB_LOAD reject J%02u: joint "
                        "LUT envelope is invalid\r\n",
                        (unsigned)jointIndex);
                } else {
                    publishJointCalibrationResult(jointIndex, result);
                    if (result.success) {
                        updateCalibrationAssemblyWarning(
                            sharedData, jointIndex, result);
                    }
                    FW_LOG_INFO_PRINTF(
                        "[UPPER] CALIB_LOAD J%02u auto=%u->%u manualCrc=0x%08lX urdf=%.3f..%.3f\r\n",
                        (unsigned)jointIndex,
                        (unsigned)result.autoMinRaw,
                        (unsigned)result.autoMaxRaw,
                        (unsigned long)result.manualReferenceCrc,
                        result.angleMin,
                        result.angleMax);
                }
            }
        }
        sendProtoAckPacket(CMD_CALIB_LOAD_JOINT,
                           sharedData->system_state,
                           status);
        if (status == PROTO_ACK_STATUS_OK) {
            // Calib Load 改写了 Auto/LUT 与边界：ACK 后立即回传该关节及关联范围，
            // 不再等待旧的一秒周期广播，上位机可据此完成逐关节闭环校验。
            if (loadedJointIndex < ENCODER_TOTAL_NUM) {
                if (!sendJointCalibSnapshotPacket(loadedJointIndex)) {
                    requestHostStateSync(STATE_SYNC_JOINT_CALIBRATION);
                }
            }
            requestHostStateSync(
                STATE_SYNC_MOTOR_ABS_LIMIT |
                STATE_SYNC_SERVO_LOGICAL_RANGE);
            postSystemEvent(sharedData, SYSTEM_EVENT_REEVALUATE_READY);
        }
        return;
    }
    if (cmd == CMD_MANUAL_ENCODER_SINGLE)
    {
        uint8_t status = PROTO_ACK_STATUS_OK;
        const uint8_t joint = frame[1];
        const uint16_t minRaw = readU16BigEndian(frame + 2);
        const uint16_t maxRaw = readU16BigEndian(frame + 4);
        if (manualUpdateMotionActive(sharedData)) {
            status = PROTO_ACK_STATUS_UNSUPPORTED_MODE;
        } else {
            if (joint >= ENCODER_TOTAL_NUM ||
                minRaw >= kEncoderModulo || maxRaw >= kEncoderModulo) {
                status = PROTO_ACK_STATUS_INVALID_DATA;
            } else {
                ManualEncoderReference references[ENCODER_TOTAL_NUM];
                {
                    SharedSafetyGuard guard;
                    memcpy(references, g_manualEncoderReference,
                           sizeof(references));
                }
                references[joint].valid = 1;
                references[joint].minRaw = minRaw;
                references[joint].maxRaw = maxRaw;
                if (!manualEncoderReferencesCoverMask(
                        references, (1UL << joint), NULL)) {
                    status = PROTO_ACK_STATUS_INVALID_DATA;
                } else {
                    status = commitManualReferences(sharedData, references);
                }
            }
        }
        sendProtoAckPacket(CMD_MANUAL_ENCODER_SINGLE,
                           sharedData->system_state,
                           status);
        if (status == PROTO_ACK_STATUS_OK) {
            sendManualEncoderReferencePacket(sharedData);
        }
        FW_LOG_INFO_PRINTF(
            "[MANUAL RAM] single J%02u min=%u max=%u status=%u "
            "committed=%u result=%u valid=0x%08lX crc=0x%08lX revision=%lu\r\n",
            (unsigned)joint,
            (unsigned)minRaw,
            (unsigned)maxRaw,
            (unsigned)status,
            (unsigned)sharedData->manual_reference_committed,
            (unsigned)sharedData->manual_reference_commit_status,
            (unsigned long)sharedAtomicLoad(
                &sharedData->manual_reference_valid_bitmap),
            (unsigned long)sharedAtomicLoad(
                &sharedData->manual_reference_crc),
            (unsigned long)sharedAtomicLoad(
                &sharedData->manual_reference_revision));
        return;
    }
    if (cmd == CMD_MANUAL_ENCODER_REFERENCE)
    {
        uint8_t status = PROTO_ACK_STATUS_OK;
        const uint8_t action = frame[1];
        const bool motionActive =
            sharedData->control_enabled != 0 ||
            sharedData->servo_target_owner != SERVO_TARGET_OWNER_NONE ||
            sharedData->system_state == SYSTEM_STATE_RUN_DIRECT ||
            sharedData->system_state == SYSTEM_STATE_RUN_FEEDBACK ||
            sharedData->system_state == SYSTEM_STATE_PULL_JOINT_INTO_WORKSPACE_RUNNING;

        if (motionActive) {
            status = PROTO_ACK_STATUS_UNSUPPORTED_MODE;
        } else if (action == 0) {
            // P4 只清会话 RAM；桌面端收到 ACK 后同步删除自身 JSON 条目。
            sharedData->manual_reference_committed = 0;
            manualEncoderReferencesClearRam();
            sharedAtomicStore(&sharedData->manual_reference_valid_bitmap,
                              (uint32_t)0);
            sharedAtomicStore(&sharedData->manual_reference_crc,
                              (uint32_t)0);
            sharedAtomicStore(&sharedData->manual_reference_revision,
                              (uint32_t)0);
            sharedData->manual_reference_commit_status =
                MANUAL_SAVE_STATUS_NONE;
            invalidateAutomaticCalibration(
                sharedData, kManualEncoderReferenceFullMask);
            postSystemEvent(sharedData, SYSTEM_EVENT_REEVALUATE_READY);
        } else if (action == 1) {
            ManualEncoderReference references[ENCODER_TOTAL_NUM];
            const uint8_t* p = frame + 2;
            for (uint8_t joint = 0; joint < ENCODER_TOTAL_NUM; joint++) {
                references[joint].valid = 1;
                references[joint].minRaw = readU16BigEndian(p);
                p += 2;
                references[joint].maxRaw = readU16BigEndian(p);
                p += 2;
            }

            uint32_t validMask = 0;
            if (!manualEncoderReferencesValidate(references, &validMask)) {
                status = PROTO_ACK_STATUS_INVALID_DATA;
            } else {
                status = commitManualReferences(sharedData, references);
            }
        } else {
            status = PROTO_ACK_STATUS_INVALID_DATA;
        }
        FW_LOG_INFO_PRINTF(
            "[MANUAL RAM] action=%u status=%u valid=0x%08lX "
            "crc=0x%08lX revision=%lu committed=%u result=%u\r\n",
            (unsigned)action,
            (unsigned)status,
            (unsigned long)sharedAtomicLoad(
                &sharedData->manual_reference_valid_bitmap),
            (unsigned long)sharedAtomicLoad(
                &sharedData->manual_reference_crc),
            (unsigned long)sharedAtomicLoad(
                &sharedData->manual_reference_revision),
            (unsigned)sharedData->manual_reference_committed,
            (unsigned)sharedData->manual_reference_commit_status);
        sendProtoAckPacket(CMD_MANUAL_ENCODER_REFERENCE,
                           sharedData->system_state,
                           status);
        return;
    }
    if (cmd == CMD_CLEAR_CALIBRATION)
    {
        uint8_t status = PROTO_ACK_STATUS_OK;
        if (sharedData->system_state == SYSTEM_STATE_RUN_DIRECT ||
            sharedData->system_state == SYSTEM_STATE_RUN_FEEDBACK ||
            sharedData->system_state == SYSTEM_STATE_PULL_JOINT_INTO_WORKSPACE_RUNNING) {
            status = PROTO_ACK_STATUS_UNSUPPORTED_MODE;
        } else {
            {
                SharedSafetyGuard guard;
                sharedAtomicStore(&sharedData->motor_abs_limit_valid_bitmap, (uint32_t)0);
                memset(sharedData->motor_abs_limit_min, 0, sizeof(sharedData->motor_abs_limit_min));
                memset(sharedData->motor_abs_limit_max, 0, sizeof(sharedData->motor_abs_limit_max));
            }
            clearAllJointCalibrationResults();
            clearCalibrationAssemblyWarnings(
                sharedData, kManualEncoderReferenceFullMask);
            postSystemEvent(sharedData, SYSTEM_EVENT_REEVALUATE_READY);
            FW_LOG_INFO_PRINTLN("[UPPER] CLEAR_CALIBRATION: joint calibration and ABS limits cleared");
        }
        sendProtoAckPacket(CMD_CLEAR_CALIBRATION, sharedData->system_state, status);
        return;
    }

    if (cmd == CMD_CLEAR_CALIBRATION_SCOPE)
    {
        uint8_t status = PROTO_ACK_STATUS_OK;
        const uint32_t motorMask =
            frameLen >= 1 + kClearCalibrationScopePayloadBytes
                ? (readU32BigEndian(frame + 1) & validMotorChannelMask())
                : 0;
        const uint32_t restoredMask =
            ~sharedAtomicLoad(&sharedData->multi_turn_unknown_bitmap) &
            validMotorChannelMask();
        const uint32_t jointMask = jointMaskForMotorMask(motorMask);
        if (sharedData->system_state == SYSTEM_STATE_RUN_DIRECT ||
            sharedData->system_state == SYSTEM_STATE_RUN_FEEDBACK ||
            sharedData->system_state == SYSTEM_STATE_PULL_JOINT_INTO_WORKSPACE_RUNNING) {
            status = PROTO_ACK_STATUS_UNSUPPORTED_MODE;
        } else if (motorMask == 0 || jointMask == 0 ||
                   (motorMask & ~restoredMask) != 0) {
            status = PROTO_ACK_STATUS_INVALID_DATA;
            FW_LOG_WARN_PRINTF(
                "[UPPER] CLEAR_CALIBRATION_SCOPE reject motors=0x%08lX restored=0x%08lX joints=0x%08lX\r\n",
                (unsigned long)motorMask,
                (unsigned long)restoredMask,
                (unsigned long)jointMask);
        } else {
            invalidateAutomaticCalibration(sharedData, jointMask);
            postSystemEvent(sharedData, SYSTEM_EVENT_REEVALUATE_READY);
            FW_LOG_INFO_PRINTF(
                "[UPPER] CLEAR_CALIBRATION_SCOPE motors=0x%08lX joints=0x%08lX remainingAuto=0x%08lX\r\n",
                (unsigned long)motorMask,
                (unsigned long)jointMask,
                (unsigned long)autoCalibrationValidMask(sharedData));
        }
        sendProtoAckPacket(
            CMD_CLEAR_CALIBRATION_SCOPE, sharedData->system_state, status);
        return;
    }



    // Direct 显式置零与标定前 F0 共用同一坐标维护事务和最终 0x19 结果。
    // motor mask 原样提交；关联关节的标定失效不会扩大实际置零的电机范围。
    if (cmd == CMD_MOTOR_ABS_ZERO)
    {
        uint8_t status = PROTO_ACK_STATUS_QUEUED;
        const uint32_t requestedMask =
            frameLen == 1 + kMotorAbsZeroPayloadBytes
                ? readU32BigEndian(frame + 1)
                : 0;
        // 必须先取命令 mutex，不能在短跨核临界区内等待 RTOS mutex。
        // 它与 pending→applied 提升串行，接受归零即撤销旧坐标待执行目标。
        SemaphoreHandle_t commandLock = sharedData->commandStateMutex;
        if (commandLock &&
            xSemaphoreTake(commandLock, pdMS_TO_TICKS(10)) != pdTRUE) {
            sendProtoAckPacket(cmd,
                               sharedData->system_state,
                               PROTO_ACK_STATUS_UNSUPPORTED_MODE);
            return;
        }
        {
            // 与状态机授予运动 owner 的最后一步使用同一短临界区。
            // 不在此处访问 UART；已有结果保留到新事务完整提交。
            SharedSafetyGuard guard;
            const uint8_t state = sharedData->system_state;
            const bool safeState =
                state == SYSTEM_STATE_UNCONTROLLABLE ||
                state == SYSTEM_STATE_IDLE ||
                state == SYSTEM_STATE_READY ||
                state == SYSTEM_STATE_JOINT_BEYOND_WORKSPACE;
            const uint32_t onlineMask =
                sharedAtomicLoad(&sharedData->servo_online_bitmap);
            const uint32_t controllableMask =
                sharedAtomicLoad(&sharedData->servo_route_controllable_bitmap);
            const uint32_t recoveryBusyMask =
                sharedAtomicLoad(&sharedData->servo_recovery_pending_bitmap) &
                ~sharedAtomicLoad(&sharedData->servo_recovery_failed_bitmap);
            if (requestedMask == 0 ||
                (requestedMask & ~validMotorChannelMask()) != 0 ||
                (requestedMask & ~onlineMask) != 0 ||
                (requestedMask & ~controllableMask) != 0) {
                status = PROTO_ACK_STATUS_INVALID_DATA;
            } else if (sharedAtomicLoad(&sharedData->emergency_stop_latched) != 0) {
                status = PROTO_ACK_STATUS_EMERGENCY_STOP_LATCHED;
            } else if (!safeState || sharedData->control_enabled != 0 ||
                       sharedData->servo_target_owner != SERVO_TARGET_OWNER_NONE ||
                       servoRebaseZeroPending(sharedData) ||
                       (requestedMask & recoveryBusyMask) != 0) {
                status = PROTO_ACK_STATUS_UNSUPPORTED_MODE;
            } else {
                sharedData->pending_direct_valid = 0;
                sharedData->pending_direct_source = MOTOR_DIRECT_SOURCE_NONE;
                sharedData->pending_direct_motor_mask = 0;
                sharedData->pending_direct_joint_mask = 0;
                sharedData->pending_direct_require_can = 0;
                sharedData->direct_reject_reason = DIRECT_REJECT_STALE;
                sharedData->motor_direct_command_source = MOTOR_DIRECT_SOURCE_NONE;
                sharedData->pending_direct_token = 0;
                sharedData->direct_release_generation = 0;
                sharedData->applied_direct_token = 0;
                sharedData->applied_direct_motor_mask = 0;
                sharedAtomicStore(&sharedData->servo_rebase_zero_request_mask,
                                  requestedMask);
                uint32_t token = sharedAtomicLoad(
                    &sharedData->servo_rebase_zero_request_token) + 1U;
                if (token == 0) token = 1;
                sharedAtomicStore(&sharedData->servo_rebase_zero_request_token,
                                  token);
            }
        }
        if (commandLock) xSemaphoreGive(commandLock);
        sendProtoAckPacket(cmd,
                           sharedData->system_state, status);
        return;
    }

}

} // namespace p4::host
