mm-hand/mmhand-core-software/ESP32-P4/src/tasks/host_comm/HostTelemetryPublisher.cpp

/**
 * @file HostTelemetryPublisher.cpp
 * @brief 实现 P4 状态快照的协议编码与上位机遥测发送。
 * @details 本文件不处理下行命令，也不改变系统状态；所有输出统一经过 HostSerialPort。
 */
#include "HostTelemetryPublisher.h"
#include "../../system/time/Clock.h"
#include "../../system/identity/DeviceIdentity.h"
#include "HostProtocolCodec.h"
#include "HostCalibrationCommandHandler.h"
#include "../../data/SafetyTypes.h"
#include "../../system/SystemRuntimeContext.h"
#include "../../system/rtos/SharedSafetyState.h"
#include "../../system/calibration/CalibrationMath.h"
#include "../../system/calibration/CalibrationRuntimeStore.h"
#include "../../config/protocol/Crc16Ccitt.h"
#include "../../system/calibration/ManualEncoderReferenceStore.h"
#include "../../config/protocol/HostProtocol.h"
#include "../../generated/UrdfJointLimits.generated.h"
#include "../../generated/ProductFingerprint.generated.h"
#include "../../hal/serial/HostSerialPort.h"
#include "../../config/topology/HardwareMap.h"
#include "../../system/rtos/AtomicValue.h"
#include "../../system/log/FirmwareLog.h"
#include "../../system/ports/SystemEventPort.h"
#include "../../system/AppBootstrap.h"
#include "../../system/TaskRuntimeMetrics.h"
#include "HostCommandRouter.h"

#include <math.h>
#include <string.h>

using namespace p4::host;

namespace p4::host {

static_assert(kP4TimestampBytes == sizeof(uint32_t),
              "P4 trailing timestamp must match uint32 serializer");

// 职责：解析下行命令并更新共享命令状态；发送传感器/舵机/故障遥测；
// 维护协议 ACK、周期心跳和长触觉包的发送节奏。
static const uint16_t kEncoderDisconnectRaw = 0xFFFF; ///< CAN 磁编断开原始哨兵。
static const uint16_t kEncoderOpenRaw = 0x7FFE;       ///< S3 自检：开路。
static const uint16_t kEncoderShortRaw = 0x7FFD;      ///< S3 自检：短路。
static const uint8_t kTactileFullPacketMagic0 = 0x54; ///< 全量触觉分包魔数 'T'。
static const uint8_t kTactileFullPacketMagic1 = 0x32; ///< 全量触觉分包版本 '2'。

/** 校验快照 LUT 行数、采样数和 Mxx 归属是否与当前 HardwareMap 一致。 */
bool calibrationTendonLutMatchesJoint(
    uint8_t jointIndex,
    const JointCalibrationResult& result)
{
    if (!result.success) {
        return true;
    }
    if (jointIndex >= ENCODER_TOTAL_NUM ||
        result.tendonLutValid == 0 ||
        result.tendonLutCount < 2 ||
        result.tendonLutCount > TENDON_LUT_MAX_SAMPLES ||
        !isfinite(result.tendonLutAngleStartDeg) ||
        !isfinite(result.tendonLutAngleStepDeg) ||
        result.tendonLutAngleStepDeg <= 0.0f) {
        return false;
    }

    const uint8_t actuatorCount = getJointActuatorCount(jointIndex);
    const uint8_t expectedCount = actuatorCount >= 2 ? 2 : 1;
    for (uint8_t actuatorIndex = 0; actuatorIndex < expectedCount;
         actuatorIndex++) {
        JointActuatorItem actuator;
        if (!getJointActuator(jointIndex, actuatorIndex, &actuator) ||
            actuator.motorChannel >= SERVO_TOTAL_NUM ||
            result.tendonLutMotor[actuatorIndex] != actuator.motorChannel) {
            return false;
        }
    }
    // 单电机快照必须明确把未使用的第 1 行标成 0xFF，避免错误地把
    // 另一台电机的表加载到当前关节。
    if (expectedCount == 1 && result.tendonLutMotor[1] != 0xFF) {
        return false;
    }
    return true;
}

/** 饱和压入 int16 上行字段，避免调试值溢出后改变符号。 */
static int16_t clampI16Local(int32_t value)
{
    if (value > 32767) return 32767;
    if (value < -32768) return -32768;
    return (int16_t)value;
}
/** 检查当前 active scope 是否已有已提交的 RAM Manual 且每路跨度非零。 */
bool activeManualReferencesReady(SystemRuntimeContext* sharedData)
{
    if (!sharedData || !sharedData->manual_reference_committed) return false;
    const uint32_t activeMask =
        sharedAtomicLoad(&sharedData->active_joint_mask) &
        kManualEncoderReferenceFullMask;
    return manualEncoderReferencesCoverActiveMask(activeMask);
}

// 将 CAN 磁编 raw 转为线上值；无效通道统一发送断开哨兵。
static uint16_t encodeRawEncoderForWire(uint16_t rawValue, bool channelValid)
{
    if (rawValue == kEncoderOpenRaw || rawValue == kEncoderShortRaw) {
        return rawValue;  // 保留 S3 自检分类，供上位机显示 open/short。
    }

    if (!channelValid) {
        return (uint16_t)PROTOCOL_DISCONNECT_SENTINEL;
    }

    if (rawValue == kEncoderDisconnectRaw || rawValue == (uint16_t)PROTOCOL_DISCONNECT_SENTINEL) {
        return (uint16_t)PROTOCOL_DISCONNECT_SENTINEL;
    }

    return rawValue;
}

// 上报状态机、owner、active scope、在线/故障和事务 token。
bool sendSystemStatusPacket(SystemRuntimeContext* sharedData)
{
    if (!sharedData) {
        return false;
    }

    uint8_t buffer[224];
    size_t idx = 0;
    uint32_t faultBitmap = 0;
    uint32_t unknownBitmap = 0;
    uint32_t activeMotorMask = 0;
    uint32_t activeJointMask = 0;
    uint32_t servoOnlineMask = 0;
    uint32_t encoderOnlineMask = 0;
    uint32_t encoderWarnMask = 0;
    uint32_t encoderFaultMask = 0;
    uint8_t canLinkOnline = 0;
    uint8_t requireCanFeedback = 0;
    {
        SharedSafetyGuard guard;
        faultBitmap = sharedAtomicLoad(&sharedData->system_fault_bitmap);
        unknownBitmap = sharedAtomicLoad(&sharedData->multi_turn_unknown_bitmap);
        activeMotorMask = sharedAtomicLoad(&sharedData->active_motor_mask);
        activeJointMask = sharedAtomicLoad(&sharedData->active_joint_mask);
        servoOnlineMask = sharedAtomicLoad(&sharedData->servo_online_bitmap);
        encoderOnlineMask = sharedAtomicLoad(&sharedData->encoder_online_bitmap);
        encoderWarnMask = sharedAtomicLoad(&sharedData->encoder_warn_bitmap);
        encoderFaultMask = sharedAtomicLoad(&sharedData->encoder_fault_bitmap);
        canLinkOnline = sharedAtomicLoad(&sharedData->can_link_online);
        requireCanFeedback = sharedAtomicLoad(&sharedData->require_can_feedback);
    }
    const uint32_t transitionCount = sharedData->state_transition_count;

    buffer[idx++] = PROTOCOL_HEADER;
    buffer[idx++] = 0x00;
    buffer[idx++] = PACKET_TYPE_SYSTEM_STATUS;
    buffer[idx++] = sharedData->system_state;
    buffer[idx++] = sharedData->control_enabled;
    buffer[idx++] = sharedData->servo_target_owner;
    buffer[idx++] = sharedData->control_mode;
    buffer[idx++] = 0; // 旧自动标定状态字段保留布局，固件不再运行标定任务。
    buffer[idx++] = (uint8_t)((faultBitmap >> 24) & 0xFF);
    buffer[idx++] = (uint8_t)((faultBitmap >> 16) & 0xFF);
    buffer[idx++] = (uint8_t)((faultBitmap >> 8) & 0xFF);
    buffer[idx++] = (uint8_t)(faultBitmap & 0xFF);
    buffer[idx++] = (uint8_t)((transitionCount >> 24) & 0xFF);
    buffer[idx++] = (uint8_t)((transitionCount >> 16) & 0xFF);
    buffer[idx++] = (uint8_t)((transitionCount >> 8) & 0xFF);
    buffer[idx++] = (uint8_t)(transitionCount & 0xFF);
    buffer[idx++] = (uint8_t)((unknownBitmap >> 24) & 0xFF);
    buffer[idx++] = (uint8_t)((unknownBitmap >> 16) & 0xFF);
    buffer[idx++] = (uint8_t)((unknownBitmap >> 8) & 0xFF);
    buffer[idx++] = (uint8_t)(unknownBitmap & 0xFF);
    buffer[idx++] = (uint8_t)((activeMotorMask >> 24) & 0xFF);
    buffer[idx++] = (uint8_t)((activeMotorMask >> 16) & 0xFF);
    buffer[idx++] = (uint8_t)((activeMotorMask >> 8) & 0xFF);
    buffer[idx++] = (uint8_t)(activeMotorMask & 0xFF);
    buffer[idx++] = (uint8_t)((activeJointMask >> 24) & 0xFF);
    buffer[idx++] = (uint8_t)((activeJointMask >> 16) & 0xFF);
    buffer[idx++] = (uint8_t)((activeJointMask >> 8) & 0xFF);
    buffer[idx++] = (uint8_t)(activeJointMask & 0xFF);
    buffer[idx++] = requireCanFeedback ? 1 : 0;
    buffer[idx++] = (uint8_t)((servoOnlineMask >> 24) & 0xFF);
    buffer[idx++] = (uint8_t)((servoOnlineMask >> 16) & 0xFF);
    buffer[idx++] = (uint8_t)((servoOnlineMask >> 8) & 0xFF);
    buffer[idx++] = (uint8_t)(servoOnlineMask & 0xFF);
    buffer[idx++] = (uint8_t)((encoderOnlineMask >> 24) & 0xFF);
    buffer[idx++] = (uint8_t)((encoderOnlineMask >> 16) & 0xFF);
    buffer[idx++] = (uint8_t)((encoderOnlineMask >> 8) & 0xFF);
    buffer[idx++] = (uint8_t)(encoderOnlineMask & 0xFF);
    buffer[idx++] = canLinkOnline ? 1 : 0;
    buffer[idx++] = (uint8_t)((encoderWarnMask >> 24) & 0xFF);
    buffer[idx++] = (uint8_t)((encoderWarnMask >> 16) & 0xFF);
    buffer[idx++] = (uint8_t)((encoderWarnMask >> 8) & 0xFF);
    buffer[idx++] = (uint8_t)(encoderWarnMask & 0xFF);
    buffer[idx++] = (uint8_t)((encoderFaultMask >> 24) & 0xFF);
    buffer[idx++] = (uint8_t)((encoderFaultMask >> 16) & 0xFF);
    buffer[idx++] = (uint8_t)((encoderFaultMask >> 8) & 0xFF);
    buffer[idx++] = (uint8_t)(encoderFaultMask & 0xFF);
    appendU32BigEndian(buffer, &idx, sharedAtomicLoad(&sharedData->manual_reference_valid_bitmap));
    appendU32BigEndian(buffer, &idx, sharedAtomicLoad(&sharedData->manual_reference_crc));
    appendU32BigEndian(buffer, &idx, sharedAtomicLoad(&sharedData->manual_reference_revision));
    buffer[idx++] = sharedData->manual_reference_committed ? 1 : 0;
    appendU32BigEndian(buffer, &idx, autoCalibrationValidMask(sharedData));
    buffer[idx++] = sharedData->manual_reference_commit_status;
    {
        SharedSafetyGuard guard;
        buffer[idx++] = sharedData->pull_joint_into_workspace_status;
        buffer[idx++] = sharedData->pull_joint_into_workspace_reason;
        appendU32BigEndian(buffer, &idx, sharedData->pull_joint_into_workspace_sequence);
        appendU32BigEndian(buffer, &idx, sharedData->pull_joint_into_workspace_joint_mask);
        appendU32BigEndian(buffer, &idx, sharedData->pull_joint_into_workspace_timestamp);
    }
    appendU32BigEndian(buffer, &idx, sharedData->pending_direct_generation);
    appendU32BigEndian(buffer, &idx, sharedData->applied_direct_generation);
    buffer[idx++] = sharedData->direct_reject_reason;
    appendU32BigEndian(
        buffer, &idx,
        sharedAtomicLoad(&sharedData->calibration_warning_bitmap));
    {
        SharedSafetyGuard guard;
        for (uint8_t joint = 0; joint < ENCODER_TOTAL_NUM; ++joint) {
            appendI16BigEndian(
                buffer,
                &idx,
                sharedData->calibration_auto_min_offset_counts[joint]);
        }
    }
    appendU32BigEndian(buffer, &idx,
                       sharedAtomicLoad(&sharedData->feedback_admission_sequence));
    buffer[idx++] = sharedAtomicLoad(&sharedData->feedback_admission_status);
    buffer[idx++] = sharedAtomicLoad(&sharedData->feedback_reject_reason);
    appendU32BigEndian(
        buffer, &idx,
        sharedAtomicLoad(&sharedData->feedback_collision_hold_bitmap));
    appendU32BigEndian(
        buffer, &idx,
        sharedAtomicLoad(&sharedData->feedback_collision_transition_count));
    // hold/transition 后紧跟 armed 位图，三个字段构成完整碰撞状态快照。
    appendU32BigEndian(
        buffer, &idx,
        sharedAtomicLoad(&sharedData->feedback_collision_armed_bitmap));
    // 原生ABS越界位图；旧圈数复位结果字段已删除。
    appendU32BigEndian(
        buffer, &idx,
        sharedAtomicLoad(&sharedData->servo_turn_overflow_bitmap));
    // 状态包时间表示本次状态快照在 P4 侧被序列化的时刻。
    appendU32BigEndian(buffer, &idx, p4::platform::time::monotonicMillis());
    buffer[idx++] = PROTOCOL_TAIL;
    buffer[1] = (uint8_t)(idx - 2);
    return FW_SERIAL_WRITE(buffer, idx) == idx;
}

/** 上报 21 路 Manual 端点、有效位、CRC 和 RAM 提交状态。 */
bool sendManualEncoderReferencePacket(SystemRuntimeContext* sharedData)
{
    if (!sharedData) {
        return false;
    }

    uint8_t buffer[144];
    size_t idx = 0;
    ManualEncoderReference references[ENCODER_TOTAL_NUM];
    uint32_t validMask = 0;
    uint32_t referenceCrc = 0;
    uint32_t revision = 0;
    uint8_t committed = 0;
    {
        SharedSafetyGuard guard;
        memcpy(references,
               g_manualEncoderReference,
               sizeof(references));
        validMask = sharedAtomicLoad(
            &sharedData->manual_reference_valid_bitmap);
        referenceCrc = sharedAtomicLoad(
            &sharedData->manual_reference_crc);
        revision = sharedAtomicLoad(
            &sharedData->manual_reference_revision);
        committed = sharedData->manual_reference_committed ? 1 : 0;
    }

    buffer[idx++] = PROTOCOL_HEADER;
    buffer[idx++] = 0x00;
    buffer[idx++] = PACKET_TYPE_MANUAL_ENCODER_REFERENCE;
    buffer[idx++] = 4; // Payload version: v4; S3 raw is already direction-normalized.
    appendU32BigEndian(buffer, &idx, validMask);
    appendU32BigEndian(buffer, &idx, referenceCrc);
    appendU32BigEndian(buffer, &idx, revision);
    buffer[idx++] = committed;
    appendU32BigEndian(buffer, &idx, autoCalibrationValidMask(sharedData));
    buffer[idx++] = sharedData->manual_reference_commit_status;
    for (uint8_t joint = 0; joint < ENCODER_TOTAL_NUM; joint++) {
        appendU16BigEndian(buffer, &idx, references[joint].minRaw);
        appendU16BigEndian(buffer, &idx, references[joint].maxRaw);
    }
    appendU32BigEndian(buffer, &idx, p4::platform::time::monotonicMillis());
    buffer[idx++] = PROTOCOL_TAIL;
    buffer[1] = (uint8_t)(idx - 2);
    return FW_SERIAL_WRITE(buffer, idx) == idx;
}
/** 上报一个 TaskRuntimeSnapshot，字段单位由 TaskRuntimeMonitor.h 约定。 */
bool sendTaskRuntimePacket(const TaskRuntimeSnapshot& diag)
{
    // v4 追加四条 BUS 的同步读统计；224 byte 足以容纳固定字段且不使用堆内存。
    uint8_t buffer[224];
    size_t idx = 0;
    buffer[idx++] = PROTOCOL_HEADER;
    buffer[idx++] = 0x00;
    buffer[idx++] = PACKET_TYPE_TASK_DIAG;
    buffer[idx++] = 4; // Payload version.
    buffer[idx++] = diag.taskId;
    buffer[idx++] = diag.active;
    buffer[idx++] = diag.priority;
    buffer[idx++] = (uint8_t)diag.coreId;
    appendU32BigEndian(buffer, &idx, diag.stackAllocatedBytes);
    appendU32BigEndian(buffer, &idx, diag.stackCurrentFreeBytes);
    appendU32BigEndian(buffer, &idx, diag.stackMinFreeBytes);
    appendU32BigEndian(buffer, &idx, diag.loopCount);
    appendU32BigEndian(buffer, &idx, diag.maxGapUs);
    appendU32BigEndian(buffer, &idx, diag.maxExecUs);
    appendU32BigEndian(buffer, &idx, diag.windowSequence);
    appendU32BigEndian(buffer, &idx, diag.windowDurationUs);
    appendU32BigEndian(buffer, &idx, diag.windowLoopCount);
    appendU32BigEndian(buffer, &idx, diag.windowPeriodicCount);
    appendU32BigEndian(buffer, &idx, diag.windowEventCount);
    appendU32BigEndian(buffer, &idx, diag.avgExecUs);
    appendU32BigEndian(buffer, &idx, diag.p95ExecUs);
    appendU32BigEndian(buffer, &idx, diag.p99ExecUs);
    appendU32BigEndian(buffer, &idx, diag.windowMaxExecUs);
    appendU16BigEndian(buffer, &idx, diag.cpuPermille);
    appendU32BigEndian(buffer, &idx, diag.overrunCount);
    appendU16BigEndian(buffer, &idx, diag.consecutiveOverruns);
    appendU16BigEndian(buffer, &idx, diag.maxConsecutiveOverruns);
    appendU16BigEndian(buffer, &idx, diag.core0IdlePermille);
    appendU16BigEndian(buffer, &idx, diag.core1IdlePermille);
    appendU32BigEndian(buffer, &idx, diag.systemStatusMaxGapMs);
    appendU32BigEndian(buffer, &idx, diag.stopLastLatencyUs);
    appendU32BigEndian(buffer, &idx, diag.stopMaxLatencyUs);
    appendU32BigEndian(buffer, &idx, diag.timestampMs);
    for (uint8_t channel = 0; channel < TASK_RUNTIME_IO_CHANNEL_COUNT; ++channel)
        appendU32BigEndian(buffer, &idx, diag.ioSampleCount[channel]);
    for (uint8_t channel = 0; channel < TASK_RUNTIME_IO_CHANNEL_COUNT; ++channel)
        appendU32BigEndian(buffer, &idx, diag.ioRequestedCount[channel]);
    for (uint8_t channel = 0; channel < TASK_RUNTIME_IO_CHANNEL_COUNT; ++channel)
        appendU32BigEndian(buffer, &idx, diag.ioSucceededCount[channel]);
    for (uint8_t channel = 0; channel < TASK_RUNTIME_IO_CHANNEL_COUNT; ++channel)
        appendU32BigEndian(buffer, &idx, diag.ioAvgUs[channel]);
    for (uint8_t channel = 0; channel < TASK_RUNTIME_IO_CHANNEL_COUNT; ++channel)
        appendU32BigEndian(buffer, &idx, diag.ioP95Us[channel]);
    for (uint8_t channel = 0; channel < TASK_RUNTIME_IO_CHANNEL_COUNT; ++channel)
        appendU32BigEndian(buffer, &idx, diag.ioP99Us[channel]);
    buffer[idx++] = PROTOCOL_TAIL;
    buffer[1] = (uint8_t)(idx - 2);
    return FW_SERIAL_WRITE(buffer, idx) == idx;
}

// 上报舵机过载位图和每路锁存的触发 load。
bool sendFaultStatusPacket(SystemRuntimeContext* sharedData, uint32_t overloadFaultBitmap)
{
    uint8_t buffer[12 + SERVO_TOTAL_NUM * 2];
    int16_t faultLoads[SERVO_TOTAL_NUM] = {0};
    if (sharedData) {
        SharedSafetyGuard guard;
        for (uint8_t ch = 0; ch < SERVO_TOTAL_NUM; ch++) {
            faultLoads[ch] = sharedData->overload_fault_load[ch];
        }
    }
    size_t idx = 0;

    buffer[idx++] = PROTOCOL_HEADER;
    buffer[idx++] = 0x00;
    buffer[idx++] = PACKET_TYPE_FAULT_STATUS;
    buffer[idx++] = (uint8_t)((overloadFaultBitmap >> 24) & 0xFF);
    buffer[idx++] = (uint8_t)((overloadFaultBitmap >> 16) & 0xFF);
    buffer[idx++] = (uint8_t)((overloadFaultBitmap >> 8) & 0xFF);
    buffer[idx++] = (uint8_t)(overloadFaultBitmap & 0xFF);
    for (uint8_t ch = 0; ch < SERVO_TOTAL_NUM; ch++) {
        const int16_t load = faultLoads[ch];
        const uint16_t encodedLoad = (uint16_t)load;
        buffer[idx++] = (uint8_t)((encodedLoad >> 8) & 0xFF);
        buffer[idx++] = (uint8_t)(encodedLoad & 0xFF);
    }
    appendU32BigEndian(buffer, &idx, p4::platform::time::monotonicMillis());
    buffer[idx++] = PROTOCOL_TAIL;
    buffer[1] = (uint8_t)(idx - 2);
    return FW_SERIAL_WRITE(buffer, idx) == idx;
}
/** 上报 27 路标定 ABS 范围及有效位；该范围仅用于诊断与快照恢复。 */
bool sendMotorAbsLimitPacket(SystemRuntimeContext* sharedData)
{
    if (!sharedData) {
        return false;
    }

    uint8_t buffer[240];
    size_t idx = 0;
    uint32_t validBitmap = 0;
    int32_t limitMin[SERVO_TOTAL_NUM] = {0};
    int32_t limitMax[SERVO_TOTAL_NUM] = {0};
    {
        SharedSafetyGuard guard;
        validBitmap = sharedAtomicLoad(&sharedData->motor_abs_limit_valid_bitmap);
        memcpy(limitMin, sharedData->motor_abs_limit_min, sizeof(limitMin));
        memcpy(limitMax, sharedData->motor_abs_limit_max, sizeof(limitMax));
    }

    buffer[idx++] = PROTOCOL_HEADER;
    buffer[idx++] = 0x00;
    buffer[idx++] = PACKET_TYPE_MOTOR_ABS_LIMIT;
    buffer[idx++] = (uint8_t)((validBitmap >> 24) & 0xFF);
    buffer[idx++] = (uint8_t)((validBitmap >> 16) & 0xFF);
    buffer[idx++] = (uint8_t)((validBitmap >> 8) & 0xFF);
    buffer[idx++] = (uint8_t)(validBitmap & 0xFF);
    for (int i = 0; i < SERVO_TOTAL_NUM; i++) {
        appendI32BigEndian(buffer, &idx, limitMin[i]);
        appendI32BigEndian(buffer, &idx, limitMax[i]);
    }
    appendU32BigEndian(buffer, &idx, p4::platform::time::monotonicMillis());
    buffer[idx++] = PROTOCOL_TAIL;
    buffer[1] = (uint8_t)(idx - 2);
    return FW_SERIAL_WRITE(buffer, idx) == idx;
}

// 上报实际 ABS 的硬件行程；每台舵机的范围有效性仍随在线及可信状态变化。
bool sendServoLogicalRangePacket(SystemRuntimeContext* sharedData)
{
    if (!sharedData) {
        return false;
    }
    uint8_t buffer[240];
    size_t idx = 0;
    uint32_t validBitmap = 0;
    int32_t rangeMin[SERVO_TOTAL_NUM] = {0};
    int32_t rangeMax[SERVO_TOTAL_NUM] = {0};
    {
        SharedSafetyGuard guard;
        validBitmap =
            sharedAtomicLoad(&sharedData->servo_logical_range_valid_bitmap);
        memcpy(rangeMin,
               sharedData->servo_logical_range_min,
               sizeof(rangeMin));
        memcpy(rangeMax,
               sharedData->servo_logical_range_max,
               sizeof(rangeMax));
    }

    buffer[idx++] = PROTOCOL_HEADER;
    buffer[idx++] = 0;
    buffer[idx++] = PACKET_TYPE_SERVO_LOGICAL_RANGE;
    appendU32BigEndian(buffer, &idx, validBitmap);
    for (uint8_t ch = 0; ch < SERVO_TOTAL_NUM; ch++) {
        appendI32BigEndian(buffer, &idx, rangeMin[ch]);
        appendI32BigEndian(buffer, &idx, rangeMax[ch]);
    }
    appendU32BigEndian(buffer, &idx, p4::platform::time::monotonicMillis());
    buffer[idx++] = PROTOCOL_TAIL;
    buffer[1] = (uint8_t)(idx - 2);
    return FW_SERIAL_WRITE(buffer, idx) == idx;
}
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
