mm-hand/mmhand-core-software/(commit log)

2026-04-04 使用合并haozhuang代码更新仓库，已验证
    [1-1_Link.STL, 1-1_Link.STL.convex.stl, 1-2_Link.STL, 1-2_Link.STL.convex.stl, 1-3_Link.STL, 1-3_Link.STL.convex.stl, 1-4_Link.STL, 1-4_Link.STL.convex.stl]
2026-04-04 modified ui logic when connected to a device
2026-04-04 fix the stop action logic of desktop
    [core_logic.py]
2026-04-05 modified joint id / motor id
2026-04-05 modified UI control, but stop button doesn't work
    [AngleSolver.cpp, protocol.py, ui_main.py]
2026-04-09 direct control motor correctly, feedback control work
    [ui_main.py]
2026-04-09 add data save, problem: no response when drag the bar in joint mode
    [hand_run_20260410_000753.csv, hand_run_20260410_001141.csv]
2026-04-12 restore ui_main dynamic modules and tendon guard while keeping start-gate/clamp/live
2026-04-12 pd control
    [hand_run_20260410_001141.csv, hand_run_20260410_190830.csv, hand_run_20260410_190855.csv, hand_run_20260412_173111.csv, hand_run_20260412_174331.csv, hand_run_20260412_174527.csv, hand_run_20260412_180804.csv, hand_run_20260412_195647.csv]
2026-04-12 add test mode for frequency test
    [hand_run_20260412_205734.csv, hand_run_20260412_210006.csv, hand_run_20260412_211318.csv, hand_run_20260412_211709.csv, hand_run_20260412_211848.csv, hand_run_20260412_212138.csv]
2026-04-13 new plot and results
    [hand_run_20260412_215218.csv, hand_run_20260412_220916.csv, hand_run_20260412_222540.csv, hand_run_20260412_223138.csv, hand_run_20260412_223443.csv, hand_run_20260412_223537.csv, hand_run_20260412_224608.csv, hand_run_20260412_232229.csv]
2026-04-13 Reorganized the directory structure
    [1-1_Link.STL, 1-1_Link.STL.convex.stl, 1-2_Link.STL, 1-2_Link.STL.convex.stl, 1-3_Link.STL, 1-3_Link.STL.convex.stl, 1-4_Link.STL, 1-4_Link.STL.convex.stl]
2026-04-13 update some codes, details in docs/
    [hand_run_20260413_194431.csv, hand_run_20260413_203118.csv, hand_run_20260413_203218.csv, hand_run_20260413_212632.csv]
2026-04-27 update docs/
    [hand_run_20260410_000753.csv, hand_run_20260412_173111.csv, hand_run_20260412_174331.csv, hand_run_20260412_174527.csv, hand_run_20260412_180804.csv, hand_run_20260412_195647.csv, hand_run_20260412_205734.csv, hand_run_20260412_210006.csv]
2026-05-04 Re-plan the code architecture
    [1-1_Link.STL, 1-1_Link.STL.convex.stl, 1-2_Link.STL, 1-2_Link.STL.convex.stl, 1-3_Link.STL, 1-3_Link.STL.convex.stl, 1-4_Link.STL, 1-4_Link.STL.convex.stl]
2026-05-07 using new pcb
    [1-1_Link.STL, 1-1_Link.STL.convex.stl, 1-2_Link.STL, 1-2_Link.STL.convex.stl, 1-3_Link.STL, 1-3_Link.STL.convex.stl, 1-4_Link.STL, 1-4_Link.STL.convex.stl]
2026-05-08 replan ui
    [1-1_Link.STL, 1-1_Link.STL.convex.stl, 1-2_Link.STL, 1-2_Link.STL.convex.stl, 1-3_Link.STL, 1-3_Link.STL.convex.stl, 1-4_Link.STL, 1-4_Link.STL.convex.stl]
2026-05-08 switch to Qt for windows
    [hand_run_20260509_001903.csv, hand_run_20260509_002200.csv, hand_run_20260509_002439.csv, hand_run_20260509_003721.csv, hand_run_20260509_003721_joint_debug_packets.csv]
2026-05-09 transfer to Qt
    [hand_run_20260509_121507.csv, hand_run_20260509_121507_joint_debug_packets.csv, hand_run_20260509_135816.csv, hand_run_20260509_135816_joint_debug_packets.csv, hand_run_20260509_143904.csv, hand_run_20260509_143904_joint_debug_packets.csv, hand_run_20260509_162826.csv, hand_run_20260509_162826_joint_debug_packets.csv]
2026-05-09 reframe desktop file structure
    [hand_run_20260509_165318.csv, hand_run_20260509_165318_joint_debug_packets.csv, hand_run_20260509_171013.csv, hand_run_20260509_171013_joint_debug_packets.csv, hand_run_20260509_171127.csv, hand_run_20260509_171127_joint_debug_packets.csv, hand_run_20260509_171530.csv, hand_run_20260509_171815.csv]
2026-05-10 re-establed the code framework for P4
    [hand_run_20260509_190531.csv, hand_run_20260509_190531_joint_debug_packets.csv, hand_run_20260509_193333.csv, hand_run_20260509_193333_joint_debug_packets.csv, hand_run_20260509_212905.csv, hand_run_20260509_212905_joint_debug_packets.csv, hand_run_20260509_213001.csv, hand_run_20260509_213001_joint_debug_packets.csv]
2026-05-10 optimize structure
    [hand_run_20260510_161444.csv, hand_run_20260510_161444_joint_debug_packets.csv, hand_run_20260510_162043.csv, hand_run_20260510_162043_joint_debug_packets.csv]
2026-05-10 remove some compatibility code
    [hand_run_20260508_000503.csv, hand_run_20260508_000503_joint_debug_packets.csv, hand_run_20260508_002800.csv, hand_run_20260508_002800_joint_debug_packets.csv, hand_run_20260508_010609.csv, hand_run_20260508_010609_joint_debug_packets.csv, hand_run_20260508_012258.csv, hand_run_20260508_012258_joint_debug_packets.csv]
2026-05-11 move continually in direct control mode
    [hand_run_20260510_214043.csv, hand_run_20260510_214043_joint_debug_packets.csv, hand_run_20260510_215704.csv, hand_run_20260510_215704_joint_debug_packets.csv, hand_run_20260510_215854.csv, hand_run_20260510_215854_joint_debug_packets.csv, hand_run_20260510_223528.csv, hand_run_20260510_223528_joint_debug_packets.csv]
2026-05-18 establish state machine and its mapping relationship with desktop; add visual teleoperation function (need optimization)
    [hand_run_20260511_211849.csv, hand_run_20260511_211849_joint_debug_packets.csv, hand_run_20260511_211935.csv, hand_run_20260511_211935_joint_debug_packets.csv, hand_run_20260517_215433.csv, hand_run_20260517_215433_joint_debug_packets.csv, motor_mid_calib.json]
2026-05-19 Add control state UI and PID calibration docs
    [pid_abs_calib.json]
2026-05-21 Update multiturn persistence and manual control UI
    [pid_abs_calib.json]
2026-05-22 Update calibration and rope init workflows
2026-06-01 Update hardware mappings and control UI
    [hand_run_20260510_212032.csv, hand_run_20260510_212032_joint_debug_packets.csv, hand_run_20260510_212454.csv, hand_run_20260510_212454_joint_debug_packets.csv, hand_run_20260510_212711.csv, hand_run_20260510_212711_joint_debug_packets.csv, hand_run_20260510_212912.csv, hand_run_20260510_212912_joint_debug_packets.csv]
2026-06-06 Update mmhand control, tactile and MANUS teleop
    [pid_abs_calib.json]
2026-06-13 Integrate current desktop/S3/P4 updates; tactile pending and PID tuning required
2026-06-15 Update tactile serial UI and calibration workflow
2026-06-17 Update thumb encoder mapping and direct motor controls
2026-06-23 完善标定、多圈安全与控制状态逻辑
    相较上一版：优化侧摆和整手标定流程；增强多圈/NVS保存、TURN UNKNOWN与READY诊断；强化STOP、直控/负反馈模式切换及手动控制恢复；补充上下位机状态协议并调整顶部状态栏交互。
2026-06-25 Improve calibration safety and connectivity handling
2026-06-27 Sync calibration safety and desktop controls
    [base_link.STL, hand.urdf, mmhand_finger_1_abduction_adduction_link_1.stl, mmhand_finger_1_distal_phalanx_1.stl, mmhand_finger_1_fingertip_1.stl, mmhand_finger_1_proximal_phalanx_1.stl, mmhand_finger_2_abduction_adduction_link_1.stl, mmhand_finger_2_distal_phalanx_1.stl]
2026-06-28 Harden new device reset ACK handling
    [comm_layer.py, core_logic.py]
2026-06-29 Fix P4 status heartbeat loss handling
    [comm_layer.py, core_logic.py, data_models.py, hand_backend.py]
2026-06-30 add ROS2 entry and reorgannized code structure of folder 'desktop'
    [1-1_Link.STL, 1-1_Link.STL.convex.stl, 1-2_Link.STL, 1-2_Link.STL.convex.stl, 1-3_Link.STL, 1-3_Link.STL.convex.stl, 1-4_Link.STL, 1-4_Link.STL.convex.stl]
2026-07-01 Add MANUS ROS2 joint target routing
2026-07-02 Update ROS2 raw IK input and calibration recovery
2026-07-09 Update CL calibration, recording, and feedback safety
    [1-1_Link.STL, 1-1_Link.STL.convex.stl, 1-2_Link.STL, 1-2_Link.STL.convex.stl, 1-3_Link.STL, 1-3_Link.STL.convex.stl, 1-4_Link.STL, 1-4_Link.STL.convex.stl]
2026-07-10 Fix dual calibration motion stalls
    [HardwareMap.cpp, comm_layer.py, data_models.py]
2026-07-10 Fix calibration queue ownership and restore runtime
    [comm_layer.py, core_logic.py]
2026-07-13 Fix calibration workspace B reuse
    Reuse an ABS-matched dual-tendon workspace B pose without requiring the transient load sample to remain at 190. Includes the accumulated P4 calibration/state-machine and desktop calibration/UI updates since the prior cl commit, and ignores the local ESP32-P4ID utility.
    [comm_layer.py, core_logic.py, data_models.py, hand_backend.py, protocol.py]
2026-07-16 Integrate manual calibration and URDF-aware control
    [1-1_Link.STL, 1-1_Link.STL.convex.stl, 1-2_Link.STL, 1-2_Link.STL.convex.stl, 1-3_Link.STL, 1-3_Link.STL.convex.stl, 1-4_Link.STL, 1-4_Link.STL.convex.stl]
2026-07-16 Adjust joint feedback overload threshold
2026-07-17 Fix shared J16 dual-tendon joint index
    [HardwareMap.h]
2026-07-18 feat: add Wuji teleop workspace and dynamic calibration updates
    [base_link.stl, finger_1_distal_phalanx_1.stl, finger_1_fingertip_1.stl, finger_1_proximal_phalanx_1.stl, finger_2_distal_phalanx_1.stl, finger_2_fingertip_1.stl, finger_2_proximal_phalanx_1.stl, finger_3_distal_phalanx_1.stl]
2026-07-18 docs: explain Wuji URDF adaptation and ROS2 flow
2026-07-19 fix: stabilize feedback control and standardize PID timing
    [comm_layer.py, core_logic.py]
2026-07-20 fix: harden calibration workflow and test controls
    [CalibrationMath.h]
2026-07-22 fix: isolate feedback commands and harden collision handling
    [TendonCalibrationLut.cpp, TendonCalibrationLut.h, comm_layer.py, core_logic.py, data_models.py, hand_backend.py, motor_mapping.py]
2026-07-23 feat: add motion replay and refine collision guards
    [comm_layer.py, core_logic.py, data_models.py, hand_backend.py, protocol.py]
2026-07-27 feat: harden calibration recovery and replay compatibility
2026-07-28 fix: restore device reset and make fault dialogs scrollable
2026-07-28 feat: add scoped servo reset zero recovery
    [comm_layer.py, core_logic.py, data_models.py, hand_backend.py, protocol.py]
2026-07-30 refactor(p4): centralize servo driver and command gateway
2026-07-30 refactor(p4): isolate calibration feedback access
2026-07-30 refactor(p4): extract calibration LUT builder
2026-07-30 refactor(p4): isolate servo feedback publication
2026-07-31 docs(p4): clarify control and calibration contracts
2026-08-04 feat: update robot model and preserve partial calibration
    [base_link.STL, finger_1_distal_phalanx_1.stl, finger_1_fingertip_1.stl, finger_1_proximal_phalanx_1.stl, finger_2_distal_phalanx_1.stl, finger_2_fingertip_1.stl, finger_2_proximal_phalanx_1.stl, finger_3_distal_phalanx_1.stl]
2026-08-07 refactor: modularize desktop and add dynamic servo routing
2026-08-12 refactor: complete P4 architecture and safety integration
    [base_link.STL, finger_1_distal_phalanx_1.stl, finger_1_fingertip_1.stl, finger_1_proximal_phalanx_1.stl, finger_2_distal_phalanx_1.stl, finger_2_fingertip_1.stl, finger_2_proximal_phalanx_1.stl, finger_3_distal_phalanx_1.stl]
2026-08-13 feat: expose ROS2 targets and extend dual tendon diagnostics
2026-08-13 feat: map manual encoder span to full URDF range
2026-08-17 fix: stabilize P4 task wakeup and runtime telemetry
    [ActuatorCommandGateway.cpp, CollisionSafetyPolicy.cpp, CollisionSafetyPolicy.h, FeetechServoDriver.h, HostCommService.cpp, HostCommTask.cpp]
2026-08-20 refactor: harden recovery and streamline desktop runtime
    Refine P4 calibration, servo recovery, safety policies, and telemetry. Simplify desktop recording/teleop surfaces and add persistent device-state recovery with focused regression tests.
2026-08-21 fix: harden servo feedback and tendon limits
    [MotionControlService.cpp, ServoBusService.cpp, ServoBusTask.cpp]
2026-08-22 checkpoint: before parallel servo sync read
2026-08-24 feat: parallelize servo feedback and harden calibration recovery
2026-08-24 feat: improve calibration recovery and control tracing
2026-08-25 feat: visualize tendon LUT and trace servo commands
2026-08-31 feat: refine calibration recovery and control feedback
    [motor_mid_calib.json]
2026-09-01 refactor desktop calibration workflow
2026-09-07 chore: sync current firmware and desktop changes
2026-09-09 fix: prevent direct enable jumps and scope release rope
    [HostCommService.cpp, HostTelemetryPublisher.cpp, MotionControlService.cpp, ServoDiscoveryManager.cpp, ServoDiscoveryManager.h]
2026-09-10 sync: update current firmware desktop and docs
    [base_link.stl, finger_1_distal_phalanx_1.stl, finger_1_fingertip_1.stl, finger_1_proximal_phalanx_1.stl, finger_2_distal_phalanx_1.stl, finger_2_fingertip_1.stl, finger_2_proximal_phalanx_1.stl, finger_3_distal_phalanx_1.stl]
2026-10-01 Add bilingual AI code guide and source-scope generator
    [motor_channels.json]
2026-10-07 Simplify desktop entry and generate raw model bindings with regression gates
    [base_link.STL, finger_1_distal_phalanx_1.stl, finger_1_fingertip_1.stl, finger_1_proximal_phalanx_1.stl, finger_2_distal_phalanx_1.stl, finger_2_fingertip_1.stl, finger_2_proximal_phalanx_1.stl, finger_3_distal_phalanx_1.stl]
2026-10-07 Remove pause and manual workflow, isolate device anchors and pace telemetry
2026-10-07 Gate motion with protocol contracts and port single tendon mechanical search
2026-10-07 Isolate active calibration snapshots by device and reject unproven restore
2026-10-07 Port Manual encoder mapping and single dual tendon LUT resampling
2026-10-09 transfer autocalibrayion piepline to host,with dirct control interfaces reusing. The new autocalibration class inherits from the ole one.Then all the previous autocalibration logic in p4 is removed,o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
    [calibration_bundle.mmcal.before_scoped_servo_abs_rebase_zero_20261008_174041.json, calibration_bundle.mmcal.before_scoped_servo_abs_rebase_zero_20261008_174052.json, calibration_bundle.mmcal.before_scoped_servo_abs_rebase_zero_20261008_174110.json, calibration_bundle.mmcal.before_scoped_servo_abs_rebase_zero_20261008_174257.json, calibration_bundle.mmcal.before_scoped_servo_abs_rebase_zero_202610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]
2026-10-09 import override
    [calibration_bundle.mmcal.before_scoped_servo_abs_rebase_zero_20261009_125946.json, calibration_bundle.mmcal.before_scoped_servo_abs_rebase_zero_20261009_125948.json, calibration_bundle.mmcal.before_scoped_servo_abs_rebase_zero_20261009_130144.json, calibration_bundle.mmcal.before_scoped_servo_abs_rebase_zero_20261009_130208.json, calibration_bundle.mmcal.before_scoped_servo_abs_rebase_zero_202610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]
2026-10-09 the same as before
    [calibration_bundle.mmcal.before_scoped_servo_abs_rebase_zero_20261009_150942.json, calibration_bundle.mmcal.before_scoped_servo_abs_rebase_zero_20261009_150944.json, calibration_bundle.mmcal.before_scoped_servo_abs_rebase_zero_20261009_151055.json, calibration_bundle.mmcal.before_scoped_servo_abs_rebase_zero_20261009_151115.json, calibration_bundle.mmcal.before_scoped_servo_abs_rebase_zero_202610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]
2026-10-09 fix reconstructed desktop bug: magnetic encoder warpping leading to a completely wrong encoder variation.
    [dual_motor.py]
2026-10-10 Simplify MM-Hand to eight web pages and require full software checks
    [base_link.STL, calibration_bundle.mmcal.before_scoped_servo_abs_rebase_zero_20261008_174041.json, calibration_bundle.mmcal.before_scoped_servo_abs_rebase_zero_20261008_174052.json, calibration_bundle.mmcal.before_scoped_servo_abs_rebase_zero_20261008_174110.json, calibration_bundle.mmcal.before_scoped_servo_abs_rebase_zero_20261008_174257.json, calibration_bundle.mmcal.before_scoped_servo_abs_reb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]
2026-10-10 fix mutiple unexpected bugs caused by desktop ui transition.
    [ActuatorSafetyPolicy.cpp, ActuatorSafetyPolicy.h, FeetechServoDriver.cpp, FeetechServoDriver.h, HardwareMap.cpp, HostCommandDispatcher.cpp]
2026-10-12 Prune obsolete docs, leftover configs and one-off scripts
    Remove the July-August one-off fix/analysis docs, the already-imported
    Feishu pack, per-board readmes, IDE workspaces (.idea/.theia/.vscode),
    the empty wuji_hand_ws, the reference paper and the unregenerable
    code-inventory. Drop the handover generator with its generated docs and
    the orphaned protocol-docx, desktop-shortcut and start scripts plus
    their tests. Surface the bilingual AI guides at the repo root and
    instruct future publishes to keep the root copies fresh.
    [files.csv]
2026-10-12 Flatten ESP32-S3 sketch and vendor FTServo into P4 sketch
    S3: drop the System wrapper folder so the sketch is ESP32-S3/ with a
    matching ESP32-S3.ino (arduino-cli requires folder/file name equality).
    P4: move the Feetech SDK from ESP32-P4/libraries into the sketch's
    src/hal/servo, drop the stale .gitmodules (the library was already
    regular files), repoint the BOM watcher paths, CI compile step and the
    servo test SDK anchor. Exempt the vendored SDK tree from project-wide
    architecture rules, regenerate product fingerprints for the moved
    firmware sources.
2026-10-12 Flatten ESP32-P4 sketch and collapse src into seven-layer tree
    Move the sketch up from ESP32-P4/ServoBoardMain to ESP32-P4 with a
    matching ESP32-P4.ino, and dissolve app/, modules/, platform/ and
    runtime/ into the seven contracted layers: config, data, generated,
    hal, safety, system, tasks. Composition roots (AppBootstrap,
    SystemAssembly), RTOS/log/clock adapters, inter-task channels, service
    ports/adapters and the actuator gateway now live in system/; the
    calibration math quartet joins system/calibration as shared business
    support; CRC and Host protocol contracts join config/protocol; runtime
    state aggregates and metrics value types join data/. All 500+ relative
    includes are recomputed mech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
2026-10-13 Rework ESP32 debug tooling into tools/debug with GDB batch entry
    - Auto-locate arduino-cli/OpenOCD/GDB from the esp32 Arduino core package;
    drop the g8765-specific absolute paths and junction logic
    - Support both P4 and S3 targets (-Target p4|s3: FQBN, board cfg, GDB flavor)
    - Always start OpenOCD with gdb_memory_map disable so GDB connects survive
    failed flash-map probes
    - Add tools/debug/gdb_batch.py: one-shot agent debug session with enforced
    delete-before-detach cleanup and ELF/flashed-firmware SHA256 check
    - Document the full workflow, iron rules and recovery steps in
    docs/debug/esp32-jtag-debugging.md and AGENTS.md
2026-10-13 Add S3 firmware compile to CI with CAN contract sync test
    - Compile ESP32-S3 in the firmware job next to P4
    - tests/firmware/test_s3_can_protocol_contract.py pins the scale and
    CAN constants that S3SensorCanProtocol.h and HalTWAI.h each declare
    by hand, so single-side drift now fails the gate
    - Consolidate the two identical crc16Ccitt copies into ESP32-S3
    src/hal/Crc16.h
    - Delete the dead ESP32-P4 hook, its BOM tools and .vscode, the
    orphan validate_urdf.py, the deprecated generate_p4_urdf_limits.py
    shim, desktop/replay/README.md, stale ignore patterns and dead
    desktop architecture rules
    [Crc16.h, HalTWAI.cpp, TactileTask.cpp]
2026-10-13 Pin JTAG adapter per board and use hardware breakpoints on S3
    With P4 and S3 both on USB-Serial-JTAG, OpenOCD attached whichever
    board enumerated first and failed with "Unsupported DTM version: -1".
    upload_debug.ps1 now records the flashed board's USB serial to
    .debug/<target>/, and gdb_batch/start_openocd pass it to OpenOCD via
    `adapter serial`. S3 sessions insert breakpoints as hbreak: Xtensa has
    no software breakpoints in flash once the memory map is disabled.
    Verified end-to-end on both connected boards.
2026-10-16 Refactor MMHand control and calibration; stabilize native USB
    [AppBootstrap.cpp, CanTask.cpp, CollisionSafetyPolicy.cpp, CollisionSafetyPolicy.h, ControlParameters.cpp, ControlParameters.h]
2026-10-19 Fix calibration timing, scoped saves and finger AA centering
    Use monotonic receive times for freshness, ACK and coordinate transactions.
    Keep Manual updates scoped and preserve other fingers in persistent JSON.
    Center and hold each finger AA before flexion calibration, retaining the
    20-second progress guard and existing feedback and overload checks.
    Validation: 1112 tests pass for the isolated commit; 1128 in the working tree.
    Hardware: J08-J15 all succeeded, including AA preparation, Rope Init and
    dual-LUT zero finish. Verified P4/JSON CRC, LUT and limits, recorded anchor
    feedback and preservation of unselected results. Device stopped/disconnected.
    Evidence: mmhand_data/experiments/calibra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
    [ack_tracker.py, application_actions.py, calibration_snapshot.py, comm_layer.py, config.py, console_snapshot.py, core_logic.py, data_models.py]
2026-10-20 Add P4 control tuning and harden release, parameter and host UI paths
    - ESP32-P4: control-parameter/limit simplification, safety policy and servo-bus updates, SnapshotTimestamp, generated artifacts, and the scoped control-tuning tooling plus docs.
    - Desktop core: make Release wait through transient feedback/route states with diagnostics and idempotent retries, guard already-invalid calibration snapshots, retry parameter SET on contract-mismatch ACK, throttle state-snapshot publication (50 Hz), accelerate HandModel copies and slow down serial discovery.
    - Desktop UI: split fast/heavy/plot refresh, change detection and backpressure, heartbeat reconnect overlay with bounded auto-reload, and r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
2026-10-20 Execute the reconnect watchdog instead of rendering its source
    ui.add_body_html only inserts raw HTML; the script text was shown on the page and never ran. Use ui.run_javascript after the client connects (guarded for event-loop-less page builds) and add a regression test for the injection path.
2026-10-20 Resolve AA calibration dependencies from the host snapshot
    A single-joint calibration (e.g. J14) needs its finger AA (J12). The runtime previously fell back to the P4 readback result, which lacks the host-only manualSpanCounts field, so AA mapping failed and the failed attempt could invalidate the selected joint before the error was detected. Prefer the complete host snapshot result with identity/CRC/invalidation checks, reject unusable results, and let the workflow include missing AA joints in the same calibration transaction instead of failing. Extend AA preflight mapping validation so dependency errors are caught before any selected joint is reset/invalidated.
    [calibration_workflow.py, dependencies.py, runtime.py]
2026-10-20 Improve calibration handover, state presentation and servo ABS restore
    - Replace the per-page STOP/Clear Faults buttons with one top-right button
    that becomes Clear Faults while a STOP is latched, and remove the duplicate
    Diagnostics button. Starting calibration, release, manual capture or import
    now performs the normal control-owner handover automatically instead of
    requiring an extra STOP.
    - Scope calibration failure dialogs to the page that started the operation,
    acknowledge them once and never replay them after page reloads. Keep the
    final root cause and failed joint list in the alert.
    - Clear runtime Auto/LUT/limit state immediately when Release or a scoped
    manual prepare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
    [CalibrationMath.cpp, CalibrationRuntimeStore.h, FeetechServoDriver.h, HostCommandDispatcher.cpp, HostTelemetryPublisher.cpp, MotionControlService.cpp, SystemEventDispatcher.cpp, TendonCalibrationLut.cpp]
2026-10-21 Linearize tendon LUTs and add per-type Ki/Kd damping
2026-10-21 Keep default calibration in repo config and show relative path
2026-10-21 Unify integral limits under Ki config and add PID autotune core
2026-10-21 Tune middle-finger PID and finalize autotune runner
2026-10-21 Ignore local PID autotuning reports
2026-10-21 Move PID autotune code under tools/debug and retune PIP/DIP
2026-10-21 Set tuned middle-finger PID values as defaults
2026-10-21 Add per-type control parameters v5 and integral/reversal autotune
    - Split integral limit, confirm_deg, takeup and exit travel per joint type (58 params, 241 B payload); noise/confirm/pair/collision/ROS2 timing stay global for now.
    - Add P4 per-type parameter lookups, schema v5 validation and regenerated protocol/fingerprint artifacts.
    - Add integral/fast-reversal autotune core, hardware runner, detector replay, report builder and tests; raise host load watchdog to 1000 counts.
    - Deploy AA takeup=40/confirm_deg=0.6 after validation; keep MCP/PIP/DIP/CMC safe; include the pre-existing ROS2 float32 boundary tolerance fix.
    [ControlParameters.cpp, JointFeedbackController.cpp, control_parameters.py, hand_backend.py]
2026-10-21 Set validated AA fast-reversal values as defaults
    Default schema-v5 configuration now matches the deployed AA tuning: confirm_deg_aa=0.6 and takeup_counts_aa=40. Other joint types remain at the safe baseline until their own validation completes.
2026-10-21 Add schema v6 progressive takeup ramp and load freeze
    - Add a separate 16-field ramp parameter frame (B0/vB/load_limit per joint type, global timeout) with its own commands, readback packet, host transaction and P4 storage.
    - Replace the fixed takeup floor with PDF Eq.(7) additive b_i, load-based growth freeze, 0.25 deg exit and timeout.
    - Raise takeup_max schema limit to 2000; split per-type ramp values; add ramp autotune ladder tool and reports.
    - Validated AA: takeup_max=40, B0=5, vB=50, load_limit=900, 10.1% engagement, 744 peak load, 11/11 exits; MCP/PIP/DIP blocked by mechanical load and left safe.
    [ControlParameters.cpp, HostCommandDispatcher.cpp, JointFeedbackController.cpp, JointFeedbackController.h, MotionControlService.cpp, RampParameters.cpp, RampParameters.h, application_actions.py]
2026-10-21 Cap MCP test trajectories below 75 degrees
    Add a 74-degree high cap to hold/reversal/validation plan builders, apply it to the MCP autotune ranges, and refuse to start J09 tests when the current angle is above 74.5 degrees. Actual planned maxima: hold 60.5 deg, reversal 62.5 deg, validation 40.2 deg.
2026-10-21 Hold proximal middle joints and require index AA clear
    Middle-finger tests now hold J08 for MCP, J08+J09 for PIP, and J08+J09+J10 for DIP; the watchdog mask includes held motors. Refuse J09/J10/J11 tests until index AA J04 is manually moved above 20 degrees, since J04 has no calibration and cannot be commanded.
2026-10-21 Unify runtime config under desktop/resources/config
    - Delete the default calibration template; first calibration creates config/calibration_bundle.mmcal.json. - Merge multiturn anchors into the active calibration bundle; remove the separate runtime file. - Merge main/ramp parameter schemas and robot manifest/source/mapping into single files. - Put logs and recordings under repo logs/ and gitignore it. - Keep ID reset transaction journals under config/device_state.
    [angle_mapping.py, application_actions.py, calibration_snapshot.py, calibration_workflow.py, core_logic.py, device_state_store.py, hand_backend.py, joint_target_adapter.py]
2026-10-21 Add result-wait probe logging for servo coordinate transactions
    _wait_coordinate_result now logs a throttled model-state probe (turn-zero
    and rebase tokens/masks/status, status freshness, device fingerprint
    validity) plus matched/timed-out/query transitions; the servo_reset_zero
    attempt line includes baseline/expected tokens; the pending-transaction
    guard logs which mask blocks; _service_servo_turn_zero_result logs whether
    a late result was serviced and why not.
2026-10-21 Fix Release failure on uncalibrated device: tolerate missing calibration bundle
    Root cause (diagnosed from recordings_20261022_001822): the device has never
    been calibrated, so calibration_bundle.mmcal.json does not exist. When the
    firmware published the successful servo_reset_zero result (~0.3 s after the
    command), _update_loop crashed in _service_servo_turn_zero_result ->
    _invalidate_coordinate_anchors -> invalidate_snapshot_multiturn_anchors ->
    read_snapshot BEFORE current_state.copy_state_from ran. The broad except in
    the loop only logged once (dedup) and re-crashed on every subsequent model,
    freezing current_state: the Release wait never saw the result, ran the full
    4 s + 3x1 s timeout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
    [calibration_snapshot.py, core_logic.py]
2026-10-22 Checkpoint take-up defaults, calibration tooling, and repo cleanup
2026-10-22 Fix calibration import: surface validation errors and allow partial loads
    - The import dialog stayed at 'Validating…' forever when Inspect Calibration
    failed; the failure message now replaces the placeholder and Load stays
    disabled (browser_view refresh loop watches the Inspect operation).
    - Manual-snapshot writes no longer drop hand_profile from the bundle: the
    empty V6 template carries it and updates backfill it on save.
    - validate_snapshot_for_load accepts manual-only and partial snapshots, so
    files with only joint calibration endpoints can be restored.
    - load_calibration_snapshot skips the zero-mask CALIB_LOAD_LIMITS command
    (firmware rejects mask 0) and reports restored Manu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
    [calibration_snapshot.py, core_logic.py]
2026-10-22 Fix first-calibration anchor deadlock on an empty snapshot
    Invalidating a scope that has no data returned early without writing the
    scoped_* registration masks, so update_snapshot_multiturn_anchors rejected
    the new turn-zero anchors with 'motors not active in calibration snapshot'.
    The rebase capture mask then never cleared and the first calibration on a
    freshly flashed hand always failed with 'logical ABS zero applied but the
    new feedback anchor was not saved'. Empty scopes now register their
    anchor scope; repeat invalidation still skips the rewrite.
    [calibration_snapshot.py]
2026-10-22 Fix anchor save deadlock on out-of-scope retained anchors
    update_snapshot_multiturn_anchors gated the ENTIRE cumulative anchor set
    against active|scoped masks, so any anchor retained from an earlier
    transaction outside the current scope rejected the whole save. After a
    rebase with partial success the capture mask then never cleared and
    calibration aborted with 'servo ABS zero partly completed; new trusted
    feedback/JSON save unconfirmed'. The gate now constrains only newly
    asserted anchors; retained anchors pass through unchanged (their motors'
    coordinates were not touched by this transaction) and are no longer
    truncated from the written bitmap.
    [calibration_snapshot.py]
2026-10-22 Make gdb_batch.py usable on Linux
    - Fall back to ~/.arduino15 when LOCALAPPDATA is absent.
    - Accept platform tool names without the .exe suffix.
    - Detect a running OpenOCD with pgrep instead of tasklist.
    Verified on Linux against the P4: smoke-test attach, thread listing,
    memory access to sharedData, and the OpenOCD cleanup RPC.
2026-10-22 Tune joint control gains and disable pair recovery
    - Kp: AA 1.3 -> 0.4; MCP/PIP/DIP/CMC -> 0.8
    - Kd: AA 0.08 -> 0; MCP/PIP/DIP/CMC -> 0.1
    - pair_recovery_gain: 0.3 -> 0
    - revision 536/115 -> 555/134
2026-10-23 Store only the fitted tendon LUT line, never a measured tight stop
    Host calibration now fits a least-squares line over the middle half of the
    5-degree LUT (both ends are distorted by tendon slack/take-up) and keeps
    just the two endpoint values evaluated at angleMin/angleMax, so
    tendonLutCount becomes 2. ABS limits are derived from those endpoints
    plus the configured release/tight margins everywhere; the measured
    tightServoAbs is no longer used as a boundary because tube bending
    changes the tendon path once the arm moves.
    P4 accepts 2-point LUTs, interpolates them as a straight line, validates
    snapshots with count >= 2, and drops the tight-anchored single-tendon
    range in favor of the shared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
    [HostCommandDispatcher.cpp, HostTelemetryPublisher.cpp, JointFeedbackController.cpp, TendonCalibrationLut.cpp, TendonCalibrationLut.h, calibration_snapshot.py, dual_motor.py, finish.py]
2026-10-23 Add per-joint adaptive Kp and merge angle commands
    P4 scales each joint's Kp in RAM from lag and one-shot overshoot evidence, defaulting off. The host reads 21 scales plus effective gains at 1 Hz and shows them under Settings > Control Parameters.
    ANGLE_CTRL and ANGLE_CTRL_MASKED are now one little-endian command (mask + 21 floats). Encoder installation labels now say warning rather than error.
    [ControlParameters.cpp, HostCalibrationCommandHandler.cpp, HostCommService.cpp, HostCommandDispatcher.cpp, HostTelemetryPublisher.cpp, HostTelemetryPublisher.h, JointFeedbackController.cpp]
2026-10-23 Merge diagnostics subscriptions into one command
    Task runtime diagnostics and control trace now share CMD_DIAGNOSTICS_SUBSCRIBE: one flags byte (bit0 task, bit1 trace) plus one divisor. The host tracks both subscriptions and sends the combined state.
2026-10-23 Merge single-motor direct control into the general command
    A single motor is now the general CMD_MOTOR_POS_ABS with a one-bit mask. CMD_MOTOR_POS_ABS_ONE and its P4 helper are removed.
2026-10-23 Merge servo raw and ABS telemetry into one position packet
    PACKET_TYPE_SERVO_POSITION carries 27 raw int16, 27 logical ABS int32 and one P4 timestamp, so the two arrays cannot drift apart. SERVO_RAW is retired.
    [HostProtocolCodec.cpp, HostProtocolCodec.h, HostTelemetryPublisher.cpp, comm_layer.py, data_models.py, protocol.py, state_reducer.py]
2026-10-23 Remove the separate Manual endpoint query command
    STATE_SYNC_REQUEST already carries the Manual reference bit. The single-joint write stays: the full-table command marks all 21 entries valid, which would incorrectly turn uncalibrated joints into valid endpoints.
2026-10-23 Merge rebase-zero and motor ABS zero into one command
    Both entry points already shared one P4 transaction and result packet. The calibration page builder is now an alias of CMD_MOTOR_ABS_ZERO.
2026-10-23 Allow AA midpoint to start outside the trusted window and move inward
    J01 aborted 166 ms after starting because its parent AA joint parked at
    M0 = 814 while the trusted window floor was 934: the precheck rejected the
    first target simply because the calibration's own end pose was already
    outside the window. The straight-line LUT underestimates the released end,
    so a fixed margin cannot guarantee containment.
    The precheck now only forbids a target from moving further outside than the
    current actual position; a joint that starts slightly outside may enter the
    window, while an outward step still aborts. Two AA tests cover both cases
    (the inward case fails without the guard).
    [runtime.py]
2026-10-23 Store the full 5-degree tendon LUT and scale gains by its middle slope
    The 2-point straight-line LUT from cd44539 hid the distorted tendon ends:
    J03's LUT claimed 9329 at 101 deg while the measured tightening end needed
    10742 at 99 deg, so the feedback clamp (LUT max + tight margin) was reached
    at 62 deg and a 90 deg target could not execute.
    Host calibration now keeps the full 5-degree table (up to 24 samples, the
    remainder point terminating at the static URDF Max); the motor workspace is
    again the table endpoints extended by the configured release/tight margins.
    fit_middle_line is removed and the LUT sample-angle rule is shared by the
    AA planning and dual-LUT zero finish so host and P4 ag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
    [JointFeedbackController.cpp, TendonCalibrationLut.cpp, TendonCalibrationLut.h, finish.py, math.py, runtime.py]
2026-10-23 Replace the 25-branch packet switch with one lookup table
    [state_reducer.py]
2026-10-23 Move the servo driver bodies out of the 1200-line header
2026-10-23 Allow repeated tendon release on the same device
2026-10-24 Hide magnetic encoder direction behind S3 mapped raw
2026-10-24 Yield all four finger AAs regardless of calibration selection
    The AA neighbor yield is a mechanical prerequisite of the AA sweep,
    not a property of the selected scope: with a partial joint selection
    (e.g. middle+index, or the index finger alone) the deselected
    neighbor AAs were silently skipped, so ring/pinky never moved aside
    while their neighbor was being calibrated. The original P4 firmware
    always prepared all four fingers; restore that semantics and keep
    only the offline-skip / unusable-reject availability rules.
    [dual_motor.py]
2026-10-24 Reject an AA sweep that never covered most of the joint range
    A blocked neighbour (or a mis-numbered tendon pair) can stop a side-sway
    sweep after a few degrees. The result still passed the 10-degree floor and
    was committed as a 20-sample LUT extrapolated over the whole range: on
    2026-10-24 a J00 sweep of 23.5 degrees (26% of its 91-degree range) was
    saved as success. Healthy parts measure 56..109% of the URDF range, so
    reject anything under 45% for the four finger AAs instead of writing it
    back.
2026-10-24 Let Direct Control zero every motor when no calibration is loaded
    Direct Control cannot move a motor whose multi-turn ABS is unknown, which is
    exactly the state of a fresh hand or a device without a calibration file, and
    the page just sits disabled with no explanation.
    Opening the page now prompts once per missing-coordinate episode: load a
    calibration file that includes motor calibration, or set every online motor's
    current position as ABS 0. Confirming reuses the existing controlled ABS-zero
    transaction, which already stops motion, waits for the P4 result and the new
    anchors, and clears Auto/LUT/ABS limits in RAM and in the .mmcal.json for
    those motors (Manual encoder endpoints stay). The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
    [application_actions.py, console_snapshot.py]
2026-10-24 Zero every motor from Direct Control instead of a per-motor button
    Direct Control cannot move motors without coordinates, and a fresh hand only
    showed a disabled page with a per-motor zero button. Opening the page now
    offers, once per missing-calibration episode, to load a calibration file or
    to set every online motor's current position as ABS 0; confirming reuses the
    controlled ABS-zero transaction (stops motion, waits for the P4 result and
    anchors, clears Auto/LUT/ABS limits in RAM and in the .mmcal.json while
    keeping Manual endpoints).
    The Reset Motor Multi-turn Position button is gone: the dialog is the only
    entry point.
    The prompt now triggers on 'no motor ABS limits' rather than 'all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
    [console_snapshot.py, core_logic.py]
2026-10-24 Send the operator back when the Direct zero prompt is cancelled
    Without motor calibration the prompt has to gate the page, not just inform:
    it is now modal (persistent), so ESC and backdrop clicks cannot bypass it.
    Cancel closes the dialog and returns to the page the operator came from, the
    previous non-Direct leaf tracked on tab changes (falling back to Joint
    Calibration), and re-arms the prompt for the next entry. Confirming starts the
    all-motor zero and keeps the page; a rejected start also re-arms the prompt so
    a busy or faulted device cannot leave the page gated with no way to zero.
2026-10-24 Return to Joint Calibration when the Direct zero prompt is cancelled
    Without motor calibration the dialog must leave the page. Instead of tracking
    the previous leaf (which was hard to reason about and easy to get wrong),
    Cancel now switches straight to Calibration / Joint Calibration, where the
    calibration file is loaded, and re-arms the prompt for the next entry.
2026-10-24 Run direct targets at 1200 counts/s with acceleration 100
    Direct Control sent every target and its enable hold with a hardcoded
    400 counts/s / acceleration 20, about 35 deg/s at the servo, independent of
    calibration. Measured recordings confirmed 395..402 counts/s, so large
    uncalibrated moves (the range is the full +-30719 hardware window) crawled.
    Both sends now share DIRECT_SERVO_SPEED/ACC constants at 1200/100, roughly
    105 deg/s with a five times harder ramp. Calibration and feedback keep their
    own speeds.
2026-10-25 Use native motor ABS and check every motor when it connects
    P4 now uses the motor's own multi-turn ABS as the only runtime position.
    The desktop keeps the recovery records and submits one P4 restore
    transaction that writes 0x0B once and accepts only an exact full-ABS match.
    Protocol 6 must be deployed on both sides together.
    Every motor is checked once per online session: firmware >= 3.10 (reported
    to the desktop with a blocking dialog), ack level 1, zero angle limits,
    full-angle feedback and 84/85/86 = 254/254/0. Renumber All no longer touches
    motion limits. A failed check keeps that motor out of control.
    Calibration prepares coordinates once for the motors being recalibrated and
    the unca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
    [FeetechServoDriver.cpp, FeetechServoDriver.h, HalEncoders.cpp, HostCalibrationCommandHandler.cpp, HostCalibrationCommandHandler.h, HostCommService.cpp, HostCommandDispatcher.cpp, HostCommandRouter.cpp]
2026-10-25 Persist the session log and explain retryable failures
    The desktop now streams the full session log to
    logs/session_<start>.log as it happens; the UI keeps its 2000-line ring
    but the file is no longer lost when the process exits or is killed.
    Failed async operations raise a toast instead of only landing in the
    operation history. Calibration alerts, operation failures and immediate
    rejections append "Please try again." only for retryable failures; safety,
    firmware, validation, cancellation and clamping messages stay unchanged.
    Prepare-stage failures no longer list every selected joint as failed, and
    a partly completed ABS rebase names the failed motor.
    Also lands the pending servo fixes: re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
    [FeetechServoDriver.h, ServoBusService.cpp, application_actions.py, core_logic.py, session_log.py]
2026-10-26 Set joint Kp defaults to AA 0.45 and 1.0 for other joints
2026-10-27 Recover the Enable pose instead of only refusing it
    Enable now pulls joints below their workspace minimum back with the P4 Rope
    Init before it waits for READY, and it only accepts READY (the P4 flaps
    IDLE/RECOVERY_REQUIRED while a joint sits outside the band, which previously
    let the host pass on an IDLE sample). The hold check now names the joint, its
    angle and the distance outside the URDF limit, and the status bar shows the
    P4 state plus the first joint outside the workspace.
    Rope Init stops once a joint is inside the minimum instead of at the -24
    counts READY tolerance, because the host holds the pose at the exact URDF
    limit.
    [application_actions.py, console_snapshot.py, hand_backend.py]
2026-10-27 Rebase the calibration to the motors instead of writing them back
    A servo power cycle drops the whole-turn part of the native ABS, and 0x0B can
    only move within +/-4095 counts, so the saved multi-turn anchors are never
    writable again: 27 motors read back 'saved mod 4096' and only the ones that
    already sat inside one turn confirmed. Replace that dead end with a host-side
    frame reconciliation: k = round((anchor - current) / 4096), shift the joint's
    servo ABS fields (LUT, limits, calibration ABS, anchors) by -k*4096, refuse
    the shift when a value leaves +/-30715, save the bundle, load it with the
    existing 0xDF path and let the P4 trust the current feedback via the new
    CMD_TRUST_MULTITURN (0xE1)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
    [FeetechServoDriver.h, HostCommService.cpp, HostCommandDispatcher.cpp, HostCommandRouter.cpp, HostMultiTurnPublisher.cpp, HostMultiTurnPublisher.h, HostTelemetryPublisher.cpp, HostTelemetryPublisher.h]
2026-10-28 Report P4 states honestly and let Rope Init fail without latching E-STOP
    Firmware:
    - requiredServosOnline treats an empty active motor scope as satisfied instead
    of reporting SERVO_OFFLINE, so a freshly booted P4 no longer shows a bogus
    Fault until a scope is set.
    - Rope Init may pull for 20 s (was 8 s): the last J04 recovery stopped 0.77 deg
    outside its workspace after 8 s while its tendon motor had already turned
    3212 counts, so the joint needs more take-up time, not a different target.
    - Consolidate the safety rule catalog, calibration validity helpers and servo
    read diagnostics; regenerate the product fingerprint for the new sources.
    Desktop:
    - A failed Rope Init no longer sen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
    [CalibrationValidity.h, Config.h, FeetechServoDriver.cpp, FeetechServoDriver.h, HostCommandDispatcher.cpp, ParallelServoFeedbackCycle.cpp, RopeInitSafetyPolicy.cpp, SCS.cpp]
2026-10-28 Restore motor coordinates through host calibration
2026-10-28 Recover upper joint limits and add all-scope controls
2026-10-29 Finish Pull Joint into Workspace and workspace warnings
    - Replace Rope Init with Pull Joint into Workspace: enter the workspace interior by 24 counts, then tension to load 200 and stop.
    - Remove the top Clear Faults button; RESET now runs inside Enable and maintenance preparation.
    - Add separate joint-angle and motor workspace badges and per-page warnings that only appear when the corresponding state is bad.
    - Raise the system-state task stack after the pull overflow; restore host calibration anchors and upper joint limits.
    - Regenerate protocol, safety catalog and product fingerprint; add the Hand URDF page and mesh assets.
    [base_link.stl, finger_1_distal_phalanx_1.stl, finger_1_fingertip_1.stl, finger_1_proximal_phalanx_1.stl, finger_2_distal_phalanx_1.stl, finger_2_fingertip_1.stl, finger_2_proximal_phalanx_1.stl, finger_3_distal_phalanx_1.stl]
2026-10-29 Fix hand plot rendering and camera
2026-10-29 Improve motor recovery and joint displays
2026-10-29 Fix adaptive Kp oscillation detection
    Replace overshoot scoring with sustained lag and oscillation detection, keep per-joint multipliers at 0.3-1.3, and raise workspace tension load to 250. Make the architecture gate and timeout test work on Linux.
    [JointFeedbackController.cpp, JointFeedbackController.h, PullJointIntoWorkspaceController.cpp, control_parameters.py]
2026-10-30 Initialize motor coordinates at native ABS 2048
2026-10-31 Fix multi-turn anchor rounding at the one-count boundary
    turn_offset() used floor division, so a current position one count above
    the anchor produced k=-1 and shifted the whole calibration by one turn
    (2026-10-30: M06 anchor=1537 current=1538 -> J04 limits moved +4096 and
    Enable drove the motor into a stall). Treat a small negative difference
    as no lost turn; real one-turn differences still round to +/-1.
    [multiturn_frame.py]
2026-10-31 Keep faulted servo telemetry; let the servo own overload protection
    - Servo feedback with a non-zero status byte is no longer dropped: position,
    load, current, voltage and temperature stay available.
    - New ServoRouteState::Faulted: a faulted motor stays online and readable but
    is excluded from the controllable set; routing returns to Online when the
    status clears.
    - On a 0x20 (overload) status the motor is torqued off immediately and the
    existing fault_status bitmap is fed from the servo status for display.
    - The servo is configured on connect to overload protection 95% / 2 s
    (registers 36/35) with the load unload condition enabled (register 19).
    - Remove the P4 software overload p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
    [FeetechServoDriver.cpp, FeetechServoDriver.h, MotionControlService.cpp, ServoBusService.cpp, ServoDiscoveryManager.cpp, ServoMaintenance.cpp, ServoRouteTable.cpp]
2026-10-31 Replace the hand model with the new left-hand URDF
    - rename desktop/resources/hku_hand_v2_urdf to mmhand_urdf and swap in the
    new 21-DOF left-hand CAD export (mmhand.urdf + 22 meshes); the URDF
    <collision> points at the visual STL, so no separate collision meshes
    - robot_model.json: 21 renamed joints, new source sha256, regenerated limits
    - generate_robot_model: wrap CAD mult-turn limit entries into (-180, 180]
    and reject a joint whose range exceeds a single turn
    - regenerated mapping, product fingerprint and P4 limit headers
    - tests: follow the renamed joints; J20 (thumb CMC) is [0, 54] again
    [base_link.stl, finger_1_distal_phalanx_1.stl, finger_1_fingertip_1.stl, finger_1_proximal_phalanx_1.stl, finger_2_distal_phalanx_1.stl, finger_2_fingertip_1.stl, finger_2_proximal_phalanx_1.stl, finger_3_distal_phalanx_1.stl]
2026-10-31 Fix the pre-commit gate so it passes again
    The commit gate had stopped working, so every commit needed --no-verify.
    - check_p4_architecture.ps1: resolve ripgrep from PATH or a bundled editor
    before the R8 scan rules use it, and fail with a clear error if it is
    missing. The script previously aborted on "rg is not recognized".
    - tests/tools/test_p4_*.py: read C++ sources with an explicit encoding. The
    default GBK locale could not decode Chinese comments, which broke the two
    consolidation tests and all eight native hotplug tests.
    - tests/desktop/core/_clock_helpers.py: sample both clocks once when
    converting a wall-clock timestamp, and add live_status_feedback so a
    mocked P4 can st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
2026-10-31 Adapt the native servo tests to the servo-owned overload protection
    Follow-up to 599b23e, which removed the P4 software overload policy and let
    the servo report its own fault through the status byte. The native harnesses
    were left behind, so the commit gate could not pass.
    - test_p4_servo_hotplug_recovery: the FeetechServoDriver stub gains the
    isFaulted() the production code now calls.
    - test_p4_servo_custom_position: the Device stub models registers 19/34..36
    (load unload condition, protection time, overload torque) because the driver
    reads and writes them while configuring a servo on connect. The FreeRTOS
    headers pulled in through FirmwareLog.h get a stub, and the two
    HostSerial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
2026-10-31 Add V5 tactile contact calibration and three-model hand view
2026-10-31 Aim the hand view camera along the new URDF axes
    The 6f9c681 URDF puts the fingers along +z, but the camera kept
    mmhand_teleop's old pose, so the model sat rolled and off-centre.
    Look down +y instead, keep `up` exactly on +z, and size the scene from
    one shared constant.
    `tests/desktop/ui/test_hand_camera.py` projects the real URDF mesh
    vertices into the camera and asserts the hand stays in frame, is
    centred, fills the height, and does not tilt.
2026-11-01 Simplify the commit gate and share duplicated session code
    Gate: port the P4 architecture check from PowerShell to Python so it runs
    on Linux without pwsh/rg, fold the safety-rule closure audit into the
    catalog generator, stop tracking the audit JSON index, drop the check.py
    alias, and remove rules that only re-checked git facts or line counts.
    The 73-rule closure probes are now stable symbols, not phrases like
    "return true".
    Config: one CONFIG_DIR in desktop.paths, one robot_model loader, one
    atomic_write_json helper, and P4 downlink frames all go through the
    length-validated builder. Live control_parameters.json is runtime state
    and leaves the index, seeded from .default.json on first run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
2026-11-02 Remove tactile sensor renumbering
    The PaXini modules do not accept the documented SPI ID write: correct
    unlock/rename frames, 1 MHz and 100 kHz, split and single CS session, unlock
    bytes A1-A3 - the address never changed, including after a power cycle. One
    module was left at an ID this board cannot address, so the feature is removed
    instead of left half-working.
    - drop Settings > Renumber Tactile, TactileIdActions and the host maintenance
    protocol/channel (0x31/0x32)
    - drop the S3 maintenance firmware and the ID-route NVS; acquisition now uses
    the fixed identity slot mapping
    - keep the tactile data path, the summary/heatmap view and the finger channel
    map fix
    [Config.h, HalEncoders.cpp, HalTactile.cpp, HalTactile.h, TactileTask.cpp, comm_layer.py, id_actions.py, tactile_heatmap.py]
2026-11-05 Dump tactile SPI frames around CRC failures
    The CRC-mismatch counters say how often a read fails but not what the wire
    carried. Print the whole received frame once per selector/address on a
    mismatch, plus the first good frame after it, so a failure can be diffed
    byte by byte against a success. The desktop console routes the two tags
    into the session log instead of dropping them with the other raw SPI text,
    and the tactile task stack doubles to 16 KB to hold the probe nesting.
    Diagnostic only; keep it until the root cause is known.
    [HalTactile.cpp, HalTactile.h, SystemTasks.cpp, comm_layer.py]
2026-11-05 Fit contact calibration from manual contact and clear poses
    The cross-finger contact events needed the whole hand to press in ways the
    fixture rarely reproduces, and the events that did land were too sparse to
    identify seven parameters per joint. Replace them with a labelled-pose fit:
    the operator records joint poses that touch and poses that come close without
    touching, and the solver separates the two classes while fitting k/b and the
    five origin corrections per joint. Directions with no contact coverage fall
    back to the Joint Calibration prior, and results are clamped to the same
    bounds the bundle loader enforces.
    The UI drops the third "original model" pose and keeps the corrected curre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
    [calibration_snapshot.py, contact_calibration.py, dual_motor.py, kinematics.py, math.py, runtime.py, single_motor.py]
2026-11-09 Report CAN and encoder wiring status in the app
    - S3 wire probe class travels over CAN as raw sentinels 0x7FFE (open) / 0x7FFD (short); the P4 preserves and forwards them.
    - Status bar shows CAN: OK / ERROR / UNKNOWN; a faulty joint gets one CAN ERROR / ENCODER OPEN / ENCODER SHORT / ENCODER ERROR badge on Joint Calibration, Motor Calibration, Feedback Control and Direct Control.
    - Protocol version 9; S3 and P4 debug firmware rebuilt and flashed.
    - Includes the pending contact-calibration capture work, the robot-model URDF digest alignment, and a UTF-8 fix in the hand-camera test.
    [Config.h, EncoderWireClassifier.h, EncodersTask.cpp, HalEncoders.cpp, HalEncoders.h, HostTelemetryPublisher.cpp, MotionControlService.cpp]
2026-11-09 Poll encoder wiring every 2 seconds
    - ENCODER_WIRE_PROBE_PERIOD_MS 10000 -> 2000 so a plugged or broken finger is reflected within about 2 s instead of 10 s.
    [Config.h, HalEncoders.cpp, HalEncoders.h]
2026-11-11 Preserve P4 CAN and servo maintenance updates
2026-11-14 Fix tendon LUT build to drop stalled-endpoint samples
    J20 (thumb CMC) failed calibration because its last two samples were
    0.023 deg apart while the motor moved 548 counts. Extrapolating 0 deg from
    that pair produced -71051 counts, which exceeded the int16 delta range and
    aborted the upload for the rest of the batch.
    build_tendon_lut now drops samples that have no normal neighboring segment
    (both sides far steeper than the table median, 8x) and interpolates from
    the remaining points. The 2026-11-13 J20 samples now build a monotonic
    table whose 0 deg node is 6669 and upload cleanly.
    [config.py, math.py]
2026-11-14 Add motor ID rescan and buzz, CAN diagnostics, and run.py entry point
    Motor IDs: the renumber page can Scan (0-253) in addition to Scan (0-30),
    offers a hold-to-buzz pulse on the selected motor, and validates source and
    target addresses before any write.
    Firmware: P4/S3 CAN and servo drivers, S3 CAN RX and tactile tasks, P4
    runtime task metrics and servo maintenance are updated with matching tests.
    Host: run.py replaces desktop/__main__.py as the entry point, and operation
    issue mapping now covers not-ready motors and stale feedback.
    Docs and generated artifacts (product fingerprint, desktop safety catalog)
    are regenerated.
    [CanTask.cpp, FeetechServoDriver.cpp, FeetechServoDriver.h, HalTWAI.cpp, HalTWAI.h, RuntimeMonitorService.cpp, S3CanRxService.cpp, ServoMaintenance.cpp]
2026-11-14 Fix the URDF digest to record the original CAD bytes
    The packaged URDF is a CRLF CAD export, but .gitattributes still carried
    rules for the pre-rename directory hku_hand_v2_urdf. Without a text
    attribute for mmhand_urdf, Git normalized the checkout to LF, so
    robot_model.json flip-flopped between two sha256 values: the CRLF digest
    (59c0a8b5...) from Windows checkouts and the LF digest (8a8245c3...) from
    Linux ones. origin/main currently records the LF digest, which makes
    tests/tools/test_robot_model_source.py and the robot-model check fail.
    Point the attribute at mmhand_urdf with -text whitespace=cr-at-eol so the
    original bytes are preserved on every checkout, restore those bytes, and
    align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
    [mmhand.urdf]
